tsuyoshi-otake/paperdiy-pda-terminal/README.md

# PaperDIY PDA Terminal

M5Stack PaperDIY（4.7 型 e-paper、ESP32-S3）を画面に、CACOE キーボードを BLE でつないだ、PDA 風クラムシェルの SSH 端末です。Un Kyu Lee さんの [phone-enclosure](https://github.com/unkyulee/phone-enclosure)（Boox Palma 2 + CACOE キーボード）を元にしています。

**関連プロジェクト**：画面を M5Stack Tab5（5 型タッチ液晶）に替えた筐体は、[Tab5 PDA Terminal](https://github.com/tsuyoshi-otake/tab5-pda-terminal) にあります（トレイ・ヒンジ・留めツメは同じ形）。

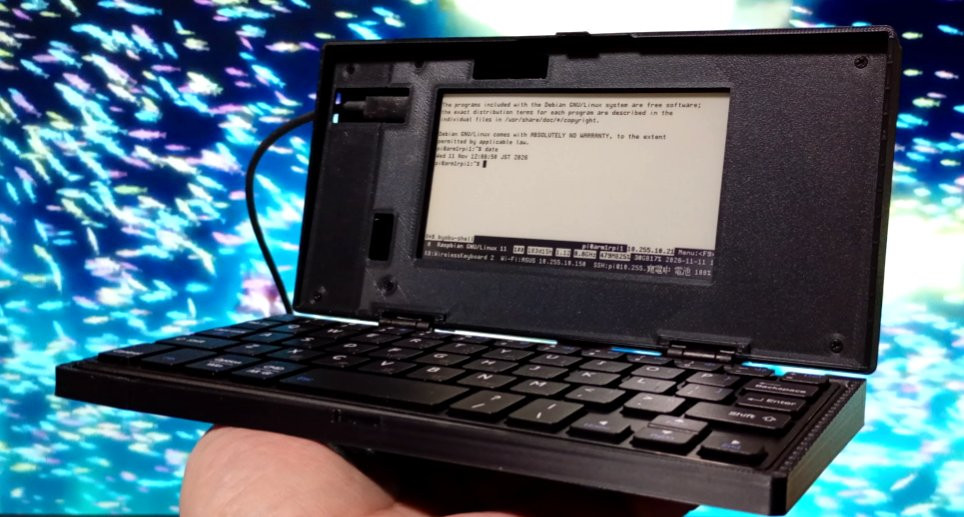
[picture p1: docs/images/photo_2026-11-11.jpg]
組み上がった実機。Raspberry Pi に SSH で入ったところ（2026-11-11）


実機です（2026-11-11。留めツメを直す前の版で、蓋はまだカチッと留まりません）。Wi-Fi 経由で Raspberry Pi に SSH で入り、CACOE キーボードで打っています。下は、いまの版の完成予想図です。

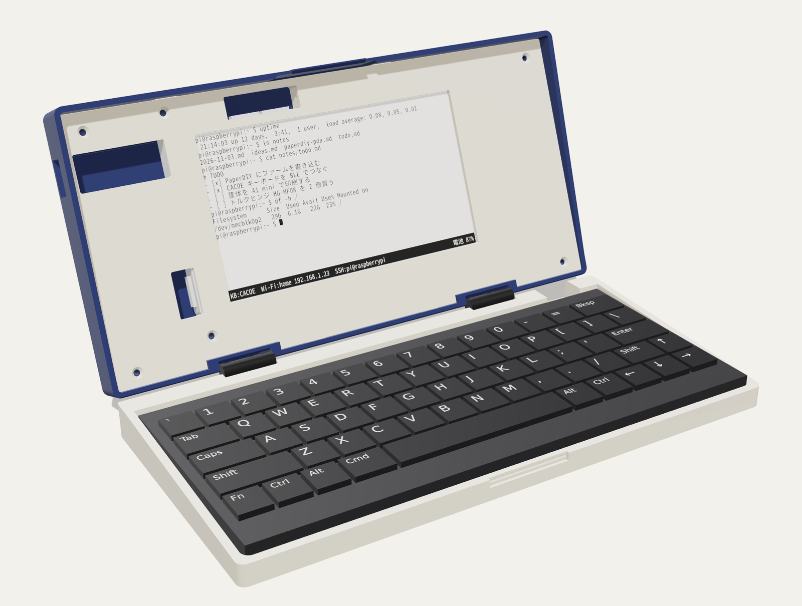
[picture p2: docs/images/render_open.png]
完成予想（開いたところ）


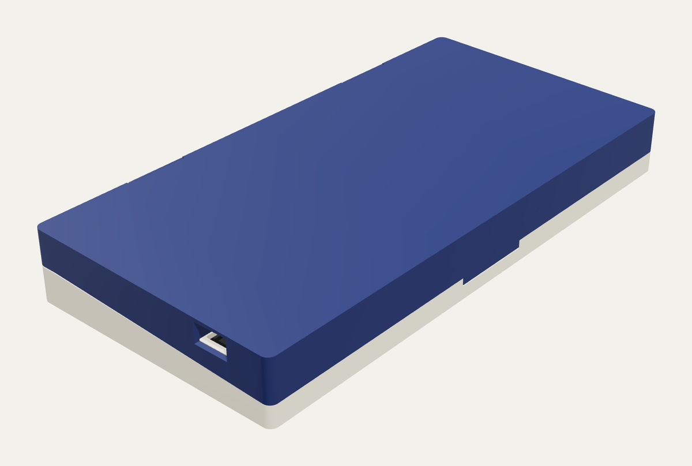
[picture p3: docs/images/render_closed.png]
完成予想（閉じたところ）
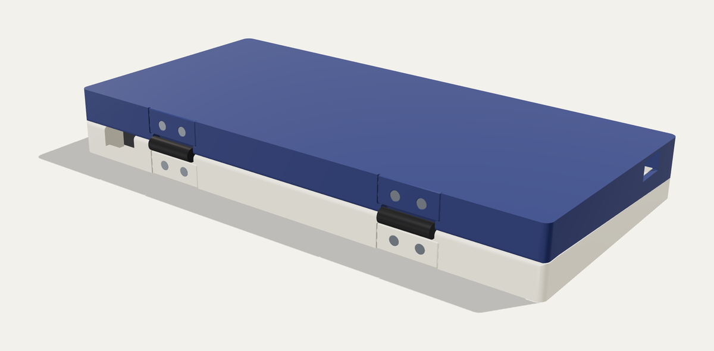
[picture p4: docs/images/render_back.png]
完成予想（背面のヒンジ）


筐体は `cad/out` の STL を組み立てた状態で描いています（キーボードは CACOE の代わりの簡易モデル、画面の表示はイメージ）。色は黒だけ・カーキだけ・ミックス（蓋がカーキ、トレイと化粧パネルが黒）で描いたものもあります：

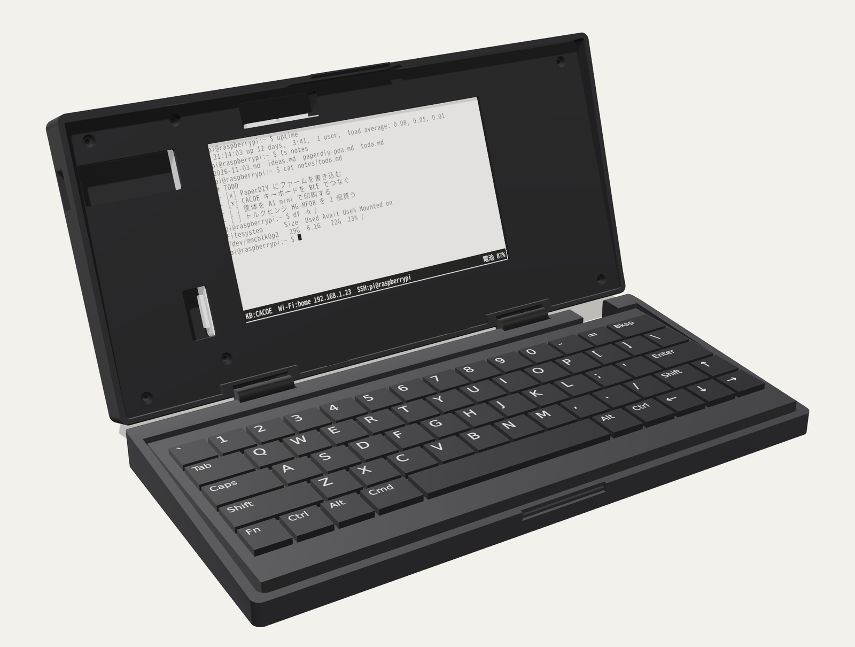
[picture p5: docs/images/render_open_black.png]
黒だけ
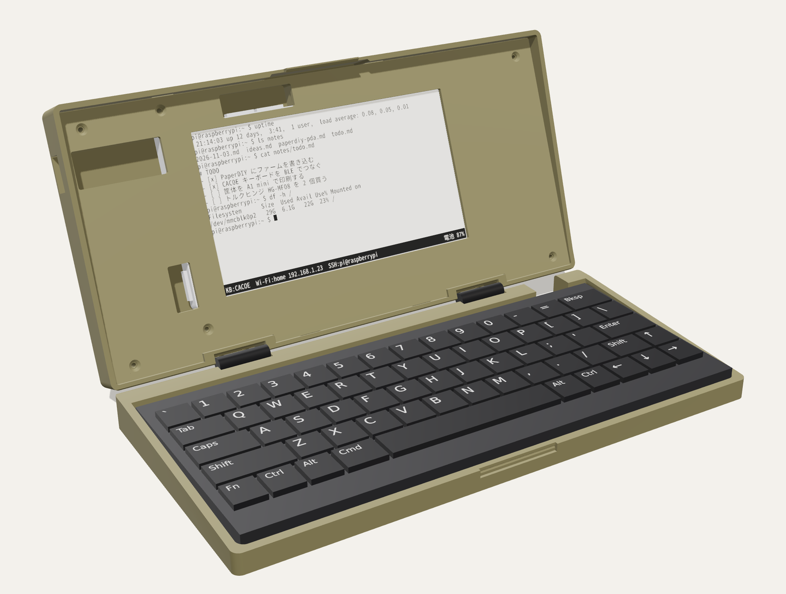
[picture p6: docs/images/render_open_khaki.png]
カーキだけ
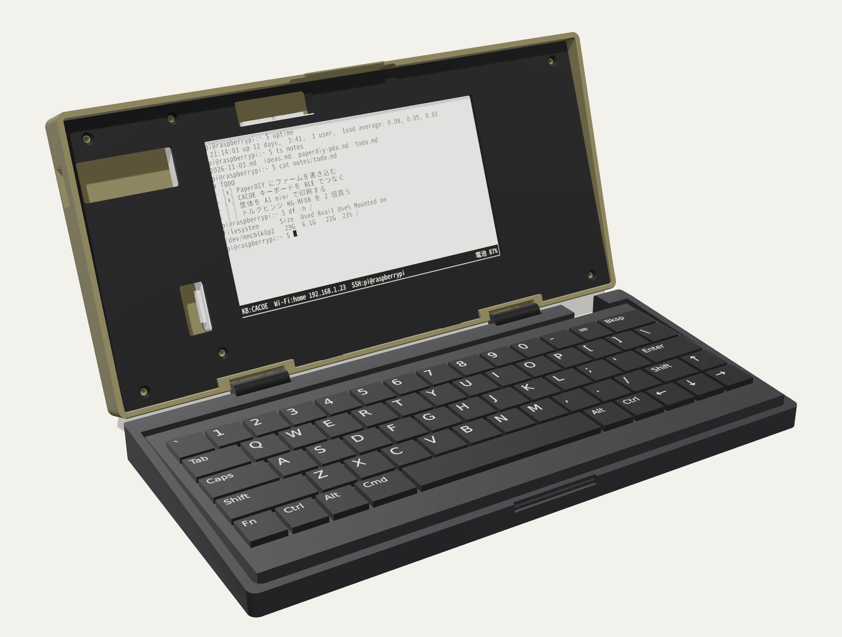
[picture p7: docs/images/render_open_mix.png]
ミックス（蓋がカーキ、トレイと化粧パネルが黒）


> **実機が 1 台、組み上がって動いています**（上の写真）。キーボードの BLE 接続と自動ペアリング、Wi-Fi、Raspberry Pi への SSH ログインまで、筐体に入れた状態で使えています。ただし、まだ試作段階です。筐体は、刷って組むたびに出た問題を直してきました。前の設計（PaperDIY の基板をそのまま載せる版）では、キーボードのがたつきや開いたときのすき間。今の設計（Complete Kit のケースごと入れる中空の蓋と化粧パネル）では、壁の柔らかさ（1.2 mm → 2.0 mm）、カバーと継ぎ板のきつさ、ヒンジの戻りで蓋の手前が浮くこと、留めツメが勝手に外れること、キーボードの位置決めリブが当たること、TPU の足が作りにくいこと。写真の 1 台は留めツメを直す前のもので（ツメが掛からず、蓋の手前が少し浮く）、**いまのリポジトリの版そのものは、まだ刷って確かめていません**（[まだ確かめていないこと](#まだ確かめていないこと)）。

## 特徴

**端末（ファーム）**

- BLE キーボードで入力。ペアリング待ちのキーボードを自分で見つけてつなぎ、次からはキーを押せば再接続
- Wi-Fi の検索・保存・自動再接続、SSH の接続先 8 件（パスワード、キーボードインタラクティブ、microSD の秘密鍵）
- xterm 互換の端末（UTF-8、日本語の全角表示、スクロール領域、代替画面）。vim、less、top、nano、tmux を想定。日本語の入力は未対応（[Issue #1](https://github.com/tsuyoshi-otake/paperdiy-pda-terminal/issues/1)）
- 接続エラーには、つなぎに行った IP とポート、この端末の IP を表示
- ESP-IDF v5.5.6 の再現可能ビルド。ビルド済みのファームはブラウザからでも書き込める

**筐体**

- Bambu Lab A1 mini と PLA で刷る前提の作り：蓋とトレイは壁・天板・床とも 2.0 mm の殻にして（1.2 mm では刷ってみて柔らかすぎた）、ねじのボスとリブで補強（パネルのねじのボスにもリブ）。面取りなし、サポート不要。0.4 mm ノズル向き（0.2 mm ノズルの設定もある）
- トレイは、キーボードのまわりのすき間と奥の帯を、縁と面一の天板（デッキ）でふさいである。ヒンジのボスは隠れる。キーボードの入る所は元のトレイと同じ 196 × 87 mm。壁から内側に出る位置決めのリブはない（キーボードに干渉する・きつい、と分かったのでやめた）
- PaperDIY は Complete Kit のケースに入れたまま、中空の薄い蓋に入れ、画面の窓のある化粧パネルで押さえる。パネルは押し込むとパチンと留まり（ねじなしでもある程度保持）、ねじ 6 本で固定。ボタンと USB-C プラグはパネルの切り欠きから。KEY の切り欠きの裏にはごみよけのガード
- 閉じた高さは手前 23.8 mm・奥 26.4 mm。蓋と一体の短い留めツメ（幅 30 mm、合わせ目から 2.6 mm）でパチンと閉じる（磁石なし）。ツメに切れ目はなく、まわりの壁を内側から薄くした帯が板としてたわむので折れにくい。蓋の下面はヒンジに向かって 0.4 mm まで斜めに逃がしてある（ヒンジのそばで縁が当たると、ねじを締めたときに蓋の手前が開くため）。トルクヒンジは手を離すと少し戻るので、蓋はカチッと言うまで押し込んで閉じる（ツメがその戻りを押さえる）
- 部品はすべて PLA。トレイの底は平らで、足はない（TPU の足とそのくぼみは、作るときの失敗を招くだけだったのでやめた）
- ヒンジは市販のトルクヒンジ（スガツネ HG-MF08 × 2）を背面に埋め込み、背面と面一のカバーで隠す。カバーは押し込むだけで側面の小さなリブで留まり、ヒンジのねじで共締めするので接着剤は要らない。好きな角度で止まり、開いたときの継ぎ目は 1〜1.5 mm
- USB-C は左端の穴から直接挿す。パネルマウントのメス端子用の蓋も用意（ねじ間隔 16〜30 mm）
- Bambu Lab A1 mini 用の分割版（3 枚で PLA 約 150 g。0.4 mm ノズルで約 4 時間、0.2 mm ノズルで約 22 時間 40 分。A1 mini（0.4 mm ノズル）向けには、印刷設定を入れた Bambu Studio のプロジェクトもある（`cad/3mf/bambu_a1mini/`。開いてスライスするだけ）。継ぎ目はまっすぐ突き合わせ、裏から貼る継ぎ板でつなぐ）と、220 mm 角以上のプリンター用の一体版（0.4 mm ノズルで約 3 時間 46 分・150 g、貼り合わせ不要）
- ねじは M2×8 皿タッピング 14 本だけ。本番の前に試し刷り（0.4 mm ノズルで約 24 分）で、はめあいと留めツメの留まり具合を確かめられる

## 作り方

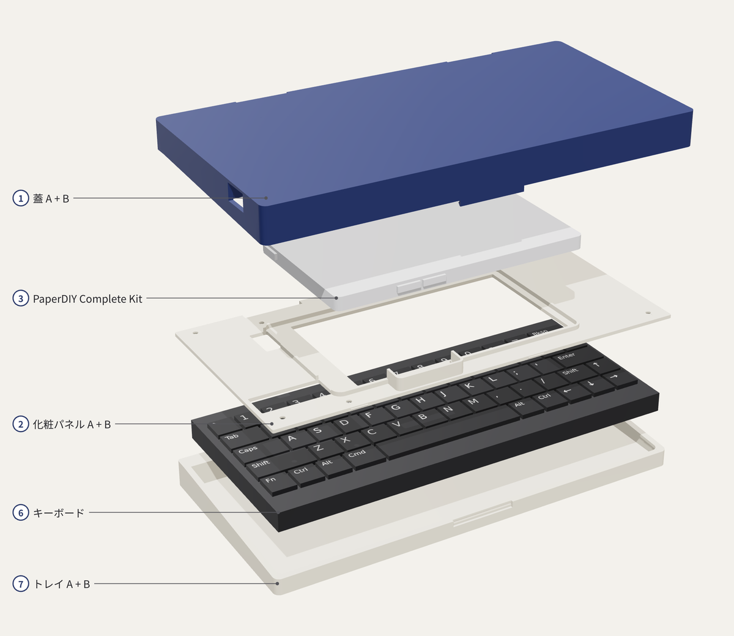
[picture p8: docs/images/render_exploded.png]
分解図


印刷用のファイル（Bambu Studio のプロジェクト、3MF、STL）とビルド済みのファームは、[Releases](https://github.com/tsuyoshi-otake/paperdiy-pda-terminal/releases) からまとめてダウンロードできます（リポジトリの `cad/3mf/`、`cad/out/`、`firmware/prebuilt/` と同じものです）。

1. **測る**：キーボードの厚さ（キートップまで）・幅・奥行き・重さ。厚さで蓋の高さが決まります。トレイは元の作品と同じ 196 × 87 mm の空間なので、CACOE ならそのまま入ります（[組み立てガイドの 3-1](cad/ASSEMBLY_ja.md)）。83 g 以上なら蓋をどこまで開いても後ろに倒れません
2. **試し刷り**：`cad/3mf/plate0_test_coupons.3mf`（0.4 mm ノズルで約 24 分）で、ヒンジ・カバーのはめあいと、留めツメの留まり具合を確かめる（A1 mini の 0.4 mm ノズルなら、設定入りの `cad/3mf/bambu_a1mini/bambu_plate0_test_coupons.3mf`）
3. **本番**：A1 mini なら `cad/3mf/plate1_lid.3mf`〜`plate3_panel.3mf`（設定入りは `bambu_a1mini/bambu_plate1_lid.3mf`〜。分割した部品を突き合わせて継ぎ板で貼り合わせる）、大きいプリンターなら `cad/3mf/large/` の 3 枚
4. **ファームを書く**：[`firmware/README.md`](firmware/README.md) の手順で `firmware/prebuilt/` のファームを書き込み、キーボードと Wi-Fi をつないでおく
5. **組み立てる**：ヒンジとカバー、PaperDIY と化粧パネル、キーボードの順に（[組み立てガイド](cad/ASSEMBLY_ja.md)）

## ドキュメント

| 文書 | 内容 |
| --- | --- |
| [cad/ASSEMBLY_ja.md](cad/ASSEMBLY_ja.md) | **組み立てガイド**：部品表、印刷設定、試し刷り、分割版の貼り合わせ、組み立て手順、使うときの注意、確認リスト |
| [cad/README_ja.md](cad/README_ja.md) | 筐体の概要：印刷するファイル、蓋・トレイ・化粧パネル、留めツメ、ヒンジ、倒れやすさ |
| [cad/README.md](cad/README.md) | 筐体の詳細（英語）：寸法の根拠、検査の内容、元の作品からの変更点、全パラメータ |
| [cad/README_bare.md](cad/README_bare.md) | 前の設計（PaperDIY の基板をそのまま載せる版、英語） |
| [cad/bom.csv](cad/bom.csv) | 部品表（CSV） |
| [firmware/README.md](firmware/README.md) | **ファーム**：書き込み、使い方、困ったとき、公開鍵認証、対応する SSH サーバー |
| [firmware/prebuilt/BUILDINFO.md](firmware/prebuilt/BUILDINFO.md) | ビルド済みファームの中身とビルド条件 |
| [docs/README.md](docs/README.md) | 画像と、それを描くスクリプト |
| [CHANGELOG.md](CHANGELOG.md) | 変更の履歴 |
| [Releases](https://github.com/tsuyoshi-otake/paperdiy-pda-terminal/releases) | 印刷用のファイルとビルド済みファームのダウンロード（zip） |
| [Issues](https://github.com/tsuyoshi-otake/paperdiy-pda-terminal/issues) | 課題と検討中のこと |

## リポジトリの構成

| フォルダ | 内容 |
| --- | --- |
| [`firmware/`](firmware/) | PaperDIY 用ファーム（ESP-IDF v5.5.6）。`prebuilt/` にビルド済みのバイナリ |
| [`cad/`](cad/) | 筐体のデータ。`src/`（作るスクリプト）、`out/`（STL）、`3mf/`（印刷用プレート）、`tools/`（検査・レポート） |
| [`docs/`](docs/) | README の画像と、それを描くスクリプト |
| `Makefile`、[`.github/workflows/`](.github/workflows/) | 全部を作り直すコマンドと、push のたびに作り直して確かめる CI（`build.yml`）、リリースを出すワークフロー（`release.yml`、手動で実行） |

## まだ確かめていないこと

1. いまの版の筐体の印刷と仮組み（はめあい、ヒンジ側を逃がした蓋で、留めツメがカチッと掛かってヒンジの戻りに負けずに留まるか・開けにくくないか、リブをなくしたトレイにキーボードが入るか、ヒンジの筒の太さと軸の高さ。公表値がないので、メーカーの 3D データから太さ 5.5 mm・軸は裏から 3.2 mm と読み取った。合わせ目の縁を丸めたので、軸が 0.3 mm 低くても蓋とトレイが当たるのは 170° から）
2. CACOE の厚さ・幅・奥行き・重さ（いまは厚さ 11.5 mm を想定。測った値を `cad/src/params.py` の `KB_THICK` に入れて作り直す。幅と奥行きは、元のトレイ（196 × 87 mm）で 2 mm ほどガタつくという報告から 194 × 85 mm と推定しているが、トレイは元と同じ 196 × 87 mm のままなので、入るかどうかには関係しない）
3. トレイの開口から CACOE の充電ケーブルを挿せるか、スイッチに届くか（デッキは開口の上を開けてある。充電ケーブルを挿したままだと蓋は 95° まで）
4. PaperDIY 内蔵の 140 mAh でどれくらい使えるか（足りなければモバイルバッテリー）
5. 設定入りの Bambu Studio プロジェクト（`cad/3mf/bambu_a1mini/`）が、実際の Bambu Studio で設定どおりに開くか（公開されているソースの読み込み処理に合わせて作ったもので、作る側では Bambu Studio を動かせていない）
6. 足のないトレイの底が机の上で滑りやすくないか

## 作り直す・同じものができるか確かめる

```bash
make setup      # Python のパッケージ（バージョン固定）
make verify     # 元データを固定のコミットで取得 → STL と 3MF を作り直し → コミット済みのものと比べる
make variants   # 文書にある別の作り方（前の設計 PD_MOUNT=bare、詰まった蓋 KIT_LID=solid）が今も作れるか確かめる
make report     # 印刷時間・重さ・スライサーの警告・壁の厚さ・倒れやすさ（PrusaSlicer が要る）
make sim        # 留めツメを閉じるところのシミュレーション（cad/out/snap_sim.md）
make test       # ファームの端末エミュレータのテスト（g++ と pyte）
make firmware   # ESP-IDF v5.5.6 でビルドして prebuilt/ と 1 バイトずつ比べる（Docker なら make firmware-docker）
make render     # README の画像を描き直す（Node.js）
make dist       # リリースに付けるファイル（zip とファーム）を dist/ に作る
```

- 元データ（phone-enclosure）はコミットと SHA-256 で固定しています。Python のパッケージ、ESP-IDF、ファームの依存ライブラリ、画像を描く npm パッケージもバージョンを固定しています
- 筐体の出力（STL・3MF）は、同じ PC なら 1 バイトも違わないものができます。別の PC では計算の最後の桁の丸めで一部のファイルのバイトが変わることがありますが、形（体積・寸法）は一致します。全ファイルの SHA-256 と体積・寸法を `cad/out/MANIFEST.json` に記録してあり、`make verify` は 0.01 mm / 0.01 % の差まで許して比べます
- ファームは日時やパスを含めない再現可能ビルドで、push のたびに GitHub Actions の `espressif/idf:v5.5.6` コンテナでビルドして `prebuilt/` と 1 バイトずつ比べています

## リリースの出し方

1. `docs/releases/（タグ名）.md` にリリースノートを書く（1 行目が `# 題名`、3 行目から本文。例：[`docs/releases/v2026.11.11.md`](docs/releases/v2026.11.11.md)）。タグ名は日付（`v2026.11.11` の形）
2. push して、CI（build）が通るのを待つ
3. GitHub の **Actions → release → Run workflow** で、タグ名を入れて実行する。そのコミットにタグが付き、`make dist` で作った zip（Bambu Studio のプロジェクト、3MF、STL、ファーム）と `SHA256SUMS` の付いたリリースができる。「Dry run」にチェックを入れると、公開はせずに zip だけ作って確かめられる（結果は実行ページの Artifacts）

zip の中身は、コミット済みの `cad/3mf/`・`cad/out/`・`firmware/prebuilt/` そのままです。日時を固定してあるので、同じ入力なら同じバイトになります。手元で作るなら `make dist TAG=（タグ名）` で `dist/` にできます。

## ライセンス

- **ソースコードと文書は [MIT ライセンス](LICENSE)** です（`firmware/`、`cad/src/`、`cad/tools/`、`docs/` のスクリプト、`Makefile`、CI、Markdown の文書）。
- **筐体の 3D データと、それを描いた画像は [CC BY-NC 4.0（非営利のみ）](cad/LICENSE.md)** です（`cad/out/`、`cad/3mf/`、`cad/renders/`、`docs/images/`）。Un Kyu Lee さんの [phone-enclosure](https://github.com/unkyulee/phone-enclosure)（[CC BY-NC 4.0](https://creativecommons.org/licenses/by-nc/4.0/)）の改変物なので、MIT にはできません。変更点は [`cad/README.md`](cad/README.md#changes-vs-the-original-for-the-licence-indicate-changes) にあります。
- **ビルド済みのファーム**（`firmware/prebuilt/`）には、ビルド時に取得するライブラリ（M5GFX・M5Unified：MIT、LovyanGFX：FreeBSD、efont：BSD 系、libssh2：BSD-3-Clause、ESP-IDF：Apache-2.0 ほか）が入っています。著作権表示とライセンス本文は [`firmware/prebuilt/THIRD_PARTY_NOTICES.md`](firmware/prebuilt/THIRD_PARTY_NOTICES.md) にあります。
- M5Stack、PaperDIY、スガツネ（HG-MF08）、CACOE はそれぞれの会社の名称です。このプロジェクトはどの会社とも関係ありません。
