tsuyoshi-otake/paperdiy-pda-terminal/cad/README.md

# PaperDIY PDA clamshell — printable CAD (derivative of unkyulee/phone-enclosure)

A Boox-Palma-free version of Un Kyu Lee's "PDA Terminal". The screen is an **M5Stack PaperDIY Complete Kit** (4.7"
e-paper, ESP32-S3) **left in its own printed case**: it lies in a hollow lid (2.0 mm walls and ceiling) and a
printed **bezel panel** with the screen window holds it from the front, screwed to six bosses in the lid. The buttons are
pressed directly through finger slots in the panel (the KEY slot with a guard ring behind it); a straight USB-C cable goes in through an opening in the left end,
and lid A (the small left piece) also comes in versions for a panel-mount female USB-C, so the end can be swapped later
by reprinting that piece only. It runs on the kit's own 140 mAh LiPo (a power bank on the USB-C when that is not
enough). A snap lip moulded into the lid's front wall (no slits: a thinned zone of the wall flexes) clicks into a recess in the tray, so the closed lid stays shut without
magnets or extra parts. The original knob-and-pin hinge is replaced by **two free-stop torque hinges (Sugatsune HG-MF08)
recessed into the back face, under printed cover plates that sit flush in it and are held by the hinge screws
themselves**, so only the barrels and the screw heads show; the whole back face is at the hinge plane, so the seam between
screen and keyboard stays 1–1.5 mm when open. Everything prints in PLA on a **Bambu Lab A1 mini (180 mm bed)**:
lid and tray are 2.0 mm shells stiffened by screw bosses and ribs (1.2 mm printed too flexible), no chamfers, corner radii halved. Lid, tray and panel
are split for the A1 mini with a straight seam, butt-glued and bridged by splice plates glued on the hidden side; with a bed of 220 mm
or more they are one piece each (`3mf/large/`, `out/whole/`). Nothing needs supports. Fasteners: 14 × M2×8
countersunk tapping screws (8 hinges, 6 panel). A **test-coupon plate** checks the hinge and cover fits and the snap's hold in
~24 min. Bill of materials, print settings and assembly order (Japanese): [ASSEMBLY_ja.md](ASSEMBLY_ja.md); parts list
as CSV: [bom.csv](bom.csv).

`KIT_LID = "solid"` (or `KIT_LID=solid` in the environment) builds the previous kit lid (a solid deck with the kit in a pocket, one M2×4 screw from the top, no
panel; not kept up: its lower front wall strains the snap's zone past the guide, and the build log says so). `PD_MOUNT = "bare"` in `src/params.py` (or `PD_MOUNT=bare` in the environment) still builds the earlier design:
the bare Assembly Kit on a printed bezel panel with a strap, snap-in push-rods, a 2000 mAh cell and a panel-mount USB-C.
It is described in [README_bare.md](README_bare.md).

Contents: [Run](#run) · [Kit design](#kit-design-pd_mount--kit-the-default) · [Hinge](#hinge) ·
[Printing](#printing) · [Hardware](#hardware) · [Measure on the real parts](#measure-on-the-real-parts) ·
[Verification](#verification-performed) · [Changes vs. the original](#changes-vs-the-original-for-the-licence-indicate-changes) ·
[Sources](#sources-of-measured-dimensions) · [Parameters](#parameters-srcparamspy-all-of-them)

## Run

From the repository root (or the same commands by hand from this folder):
```
make setup     # pip install -r cad/requirements.txt (pinned versions) + the host-test packages
make verify    # fetch the pinned original, build every STL + 3MF, compare with out/MANIFEST.json
make report    # optional, needs prusa-slicer: print time / filament / stability warnings -> out/print_report.md
make sim       # the lid closing onto its snap, simulated on the built parts -> out/snap_sim.md
make variants  # the other designs (PD_MOUNT=bare, KIT_LID=solid) still build? (in scratch copies; CI runs it)
```
By hand:
```
pip install -r requirements.txt
tools/fetch_original.sh                  # clones unkyulee/phone-enclosure at the pinned commit to ~/phone-enclosure, checks hashes
python3 src/build.py                     # ~10 s; writes out/, out/split/, out/coupons/, renders/
python3 src/export_3mf.py                # 3mf/ print plates
python3 tools/manifest.py --check        # same outputs as committed?
python3 tools/print_report.py            # optional (prusa-slicer)
python3 tools/snap_sim.py                # the snap, simulated (--figure ../docs/images/snap_sim.png redraws the figure)
```
Set `PHONE_ENCLOSURE_STL=/path/to/phone-enclosure/STL` if the original repo is cloned elsewhere.
`src/params.py` holds every parameter; `src/build.py` does the mesh booleans (manifold3d) on the original STLs,
checks each export by re-loading the written STL (watertight, one body), runs assembly interference and motion checks,
writes the test coupons and the lid-A variants, and renders PNGs with `src/render.py` (software z-buffer, no GPU). The full
log is written to `out/build_log.txt`.

### Reproducibility
* **Input pinned:** `ORIG_COMMIT` and `ORIG_SHA256` in `src/params.py`; `load()` refuses STLs with other hashes
  (override: `PHONE_ENCLOSURE_ANY_VERSION=1`). `tools/fetch_original.sh` checks out that commit.
* **Tools pinned:** `requirements.txt` (Python 3.13). The README images use `docs/render/package-lock.json`.
* **Deterministic:** on one machine, two builds give byte-identical STL / 3MF files (also with one CPU); the 3MF zips carry
  fixed timestamps. Another machine can round the last digit differently: on the GitHub Actions runner some files
  are byte-identical and the rest match in geometry only.
* **Recorded:** `out/MANIFEST.json` holds the SHA-256, volume, bounding box and triangle count of every output.
  `tools/manifest.py --check` accepts byte differences only when the geometry matches to 0.01 mm / 0.01 %.
* **CI:** `.github/workflows/build.yml` runs `make verify`, the snap simulation, the slicer report, the firmware build (compared byte for byte
  with `firmware/prebuilt/`) and the host tests.

## Kit design (`PD_MOUNT = "kit"`, the default)

### Manufacturing basis
PLA on a Bambu Lab A1 mini (0.4 mm nozzle, 0.2 mm layers), split parts on its 180 mm bed or one-piece parts on a bigger
one. Lid and tray are shells: **2.0 mm walls, ceiling and floor** (`WALL`: 5 lines of a 0.4 mm nozzle; the 1.2 mm version printed too flexible), stiffened by screw
bosses and ribs (`RIB_T` = 1.2). Clearances are for a tuned FDM printer: 0.2 mm around the kit and
the panel (`KIT_FIT`, `PANEL_CLR`), 0.25 mm around the covers (`COVER_POCKET_CLR`; 0.15 printed too tight), 0.3 mm around the splice plates, 0.25 mm in the hinge mortises
(`HINGE_CLR`). No supports. No chamfers anywhere; the plan corners of lid and tray are r 3 (`CORNER_R`, the original's
r 6 halved), and the other small radii were halved too.

### Outputs
| File | Notes |
|---|---|
| `out/display_lid_usbc.stl` | lid, unsplit (hollow shell; 202.0 × 99.5 × 22.1) |
| `out/display_panel_kit.stl` | bezel panel, unsplit (199.2 × 97.6; 1.6 thick + 2.0 rim, KEY guard up to the kit's back) |
| `out/keyboard_tray.stl` | tray, unsplit (a new thin shell with the original's outline and parting; 202.0 × 99.5 × 12.9) |
| `out/paperdiy_kit_envelope.stl` | the kit as placed (case 120.0 × 67.0 × 6.3, r 3, KEY and power caps): checks and renders |
| `out/hinge_cover_lid_x2.stl`, `out/hinge_cover_tray_x2.stl` | print 2 of each |
| `out/split/lid_A_left.stl`, `lid_B_main.stl`, `panel_A_left.stl`, `panel_B_main.stl`, `tray_A_left.stl`, `tray_B_main.stl` | A1 mini pieces (≤ 175 mm), cut straight, with the splice-plate pockets |
| `out/split/splice/{lid,tray,panel}_splice_N.stl` | splice plates for the split pieces (2 lid and 1 tray, 1.0 mm; 3 panel, 0.8 mm) |
| `out/split/usb_variants/lid_A_left_usb*.stl` | lid A for a panel-mount female USB-C: M3 ears 16 / 18 / 20 / 22 / 25 / 28 / 30 mm apart, or none (glue) |
| `out/whole/lid.stl`, `tray.stl`, `panel.stl`, `out/whole/usb_variants/lid_usb*.stl` | one-piece parts for a bed of 220 mm or more: no split, no keys, no pockets (each asserted to be the checked part minus material; the panel-mount lids are also checked against the connector) |
| `out/coupons/*.stl` | hinge seat (lid, tray), snap lip with its flex zone (lid) + recess and notches (tray) |
| `3mf/plate0_test_coupons.3mf` | coupons + one cover of each kind, ~24 min, 10 g |
| `3mf/plate1_lid.3mf` | lid A + B + 2 lid covers + 2 lid splice plates, ~1 h 45 min, 65 g |
| `3mf/plate2_tray.3mf` | tray A + B + 2 tray covers + 1 tray splice plate, ~1 h 32 min, 62 g |
| `3mf/plate3_panel.3mf` | panel A + B + 3 panel splice plates, ~38 min, 24 g |
| `3mf/bambu_a1mini/bambu_plate0…3*.3mf` | the same four plates as **Bambu Studio projects** for the A1 mini with a 0.4 mm nozzle: printer, process, filament and plate type are selected on opening (see "Bambu Studio projects") |
| `3mf/bambu_a1mini/paperdiy_process_a1mini_04.json` | the same process changes as a preset to import (File → Import → Import Configs), the fallback |
| `3mf/usb_variants/lid_A_left_usb*.3mf` | the lid-A variants, one per file |
| `3mf/large/plate1_lid.3mf`, `plate2_tray.3mf`, `plate3_panel.3mf` | one-piece lid / tray / panel (+ covers) on a 220 x 220 mm plate: ~1 h 40 min 65 g, ~1 h 28 min 61 g, ~35 min 24 g (150 g, 3 h 42 min, nothing to glue) |
| `3mf/large/usb_variants/lid_usb*.3mf` | the panel-mount lids in one piece |

Plates 1–3: about 151 g and 3 h 54 min with the 2.0 mm walls (3 h 58 min with the keyboard ribs, now gone; 118 g and 3 h 07 min with 1.2 mm walls; the version with the
original tray took 139 g and 3 h 29 min).

### The kit
Measured from M5Stack's model of the Complete Kit (`m5stack/M5_Hardware`, `Products/K159-B_PaperDIY_Complete_Kit/Structures/PaperDlY_Complete_Kit.stl`,
sha256 `9258e3e2…3e58`): case 120.0 × 67.0 × 6.3 mm with r 3 mm corners; window 105.0 × 59.7 at the front, 4.0 mm off
centre away from the USB end; KEY1/KEY2 caps on one long edge (9.6–20.4 and 21.6–32.4 mm from the centre toward the USB
end, 1.2 proud, 2.1–4.95 mm behind the front face); power cap on the USB end (+17.9…+28.8 mm across, 1.27 proud);
USB-C at −24.0 across, 2.44–5.6 mm behind the front; a 4.2 mm hole in the back plate over the M2 standoff, 20.0 mm from
the centre toward the USB end (not used by the shell lid). M5Stack: 43.1 g.

### Layout and lid shape
* The kit lies front face down (window toward the keyboard), window centred on the lid (`KIT_CX = −4.0`), USB end at −x,
  KEY edge toward the front (−y), as the bare board was.
* **Panel face** at `PANEL_Z0 = KB_TOP_Z + KB_CLR` = 14.0, with `KB_TOP_Z = TRAY_FLOOR + KB_THICK` = 2.0 + 11.5: the
  CACOE stands above the tray rim (the original lid's panel face was at z = 15 over a 3 mm floor), and nobody has measured
  it yet. Measure the keyboard over the keycaps and set `KB_THICK`: every millimetre comes off the lid. The panel is 1.6
  thick, so the kit's front face is at 14.8 and its back (+ 0.2 gap) at 21.3.
* **Underside**: the original parting plane z = 10.4417 + 0.05376 y (fitted to the original lid, residual < 0.001 mm),
  flat at `Z_PART` behind y = 44.7 (the hinge strip).
* **Top**: a plane through the lowest point that the hinge allows at the back face (leaf 12.75 mm above the axis + the
  cover's top rim; z 26.4 at y = 53) and the most demanding of: the kit + ceiling, and the USB-C plug path + 0.8
  (`USB_CEIL`): z = 24.994 + 0.02653 y (set by the kit's front edge + the 2.0 ceiling). The lid is 15.8 mm thick at
  the front face and 13.4 at the back; the closed case is 23.8 mm tall at the front and 26.4 at the back (was 30 / 30). The hinge (25 mm wide, face mounted) sets a floor
  of ~26 mm at the back whatever the keyboard.
* **Lid shell** (`KIT_LID = "shell"`): the plan outline (r 3 corners) as a prism between the two planes, no chamfers,
  hollowed to `SHELL_WALL` = `SHELL_CEIL` = 2.0. Inside: a pad and two screw bosses per hinge (see "Hinge"), six screw
  bosses (Ø6) for the panel with Ø1.8 pilots, each braced by 1.2 mm ribs in up to four directions (`PANEL_BOSS_RIBS`:
  toward a wall within 5.5 mm a full-height rib into it, elsewhere a 3 mm gusset sloping from the boss's foot to the
  ceiling; none into the kit's rim, the splice-plate pockets or the plug path; all 0.5 mm above the panel's back),
  three ribs from the ceiling to 0.1 mm above the kit's back (x −50 / 0 / 40,
  clear of the ESP32 window), two 1.2 mm guide ribs either side of the plug path (from the end wall, beside the opening, to
  the kit; cut at the split like everything else), and a relief that leaves 0.8 mm of ceiling over the plug.
* **Tray shell**: a new part instead of the original `Keyboard.stl`: the same plan outline (r 3) cut by the original
  parting plane and `Z_PART`, hollowed to 2.0 walls over a 2.0 floor (`TRAY_FLOOR`; the original had 3 mm walls and floor).
  The keyboard's room is the original tray's, 196 × 87 mm (`KB_FACE_X`, `KB_FACE_Y`), and nothing stands out of its
  walls. The nine locating ribs on the front and back got in the keyboard's way; the two on each end wall, brought back
  0.15 mm off the ends of the estimated 194 mm keyboard, were too tight in the print (`TRAY_KB_RIBS`, now `None`: set
  it again once the keyboard's length is measured). The keyboard has the original's play, ~2 mm each way. Also: hinge pads and bosses, a pad behind the snap-tab recess (flush with the room's front face), and the
  original's charge-port opening in the back wall (x 72.9–89.1, from 3.0 above the floor: `TRAY_PORT`).
* **Tray deck** (`TRAY_DECK`): a 1.2 mm face flush with the rim closes the gaps around the keyboard and the strip behind
  it, so the hinge bosses and pads no longer show. Its opening is the original tray's room (196 × 87 mm, front
  corners r 3 as the original's inner corners), the one size the keyboard is known to go into.
  Along the front and end walls it is 1.0 mm wide on a 45° fillet; behind the keyboard it tops a strip that is solid from
  the floor up (7.5 mm deep; it takes in the hinge bosses and pads, the slicer fills it with infill). Over the charge-port opening it is open (16.2 mm), so the plug, and a switch there, stay reachable from above.
  No supports, no slicer warnings (the first try, a deck bridged over ribs, gave long-bridge warnings). The tray's splice
  plate now stays inside the keyboard's room (y ±42.4, 84.8 mm), so it goes in through the opening.
* **No feet**: the tray's bottom is flat and stands on the table, as the original's does. An earlier version pressed
  four TPU pads into 0.8 mm pockets in the bottom; the pockets in the first layer and the second material only invited
  mistakes in the making, so they are gone and every part is PLA.
* **No dampers** under the lid's front edge: the torque hinges spring back a little when the lid is let go (see
  "Hinge"), so the closed lid is always pressed up against the snap and cannot rattle. The TPU bow springs an earlier
  version had in the tray's front rim only added 0.5 N to that push.
* **Bezel panel** (`PANEL_*`): 1.6 mm, inside the lid's walls (0.2 mm clear of them and the hinge pads). Screen window =
  the kit's window + 0.3 per side, square edges (no chamfer); a locating rim (2.0 high, 1.2 wide, 0.2 clear, below the
  caps at 2.1) around the kit on its back; six countersunk M2×8 holes (6.4 mm into the bosses); a gap in the rim for the
  USB-C plug. The kit is clamped between the panel and the ribs.
* **Panel snaps** (`PANEL_SNAP`): four 8 mm bumps, two on the front edge (x = −60, +26) and two on the back (x = −23,
  +26), between the wall ribs and clear of the latch, the KEY guard and the hinge pads: a ridge 0.45 mm out from the panel
  edge at mid-thickness. Going in they pass the lid's 2.0 mm walls by 0.25 mm (the walls flex), then sit in 0.30 mm
  grooves (0.05 clear) once the panel rests on the bosses, so the panel stays in without its screws; prise it out at the
  finger slots. The grooves follow `PANEL_SNAP["h"]`, the bumps `["bump"]`: if it is too tight, lower `bump` and reprint
  the panel only.
* **Buttons**: finger slots through the panel at the KEY caps (one slot for both, on the front edge) and the power cap (on
  the USB end), 8.0 mm out from the kit and 3.0 mm past the caps' ends (`PANEL_SLOT`; they were 6.5 / 1.5). No push-rods.
* **KEY guard** (`PANEL_GUARD`): a 1.2 mm ring on the panel's back around the KEY slot, 0.5 mm off it, from the panel up
  to the kit's back and closed by the kit's edge: whatever falls into the slot stays in that pocket instead of getting
  into the lid. The power slot has none: it opens into the space between the kit's end and the lid's end wall, which the
  USB-C slot already opens to the outside, and a ring there would take the place of a panel-mount female's body
  (lid-A variants).
* **USB-C, direct** (default): a 13 × 7.6 mm opening in the left end face; the guide ribs lead a straight plug (overmold
  ≤ 12 × 6.5) to the port, and the plug stays in with the lid closed. The panel is open over the plug path
  (`PANEL_USB_SLOT`: 13.2 mm wide, from a 2.2 mm frame at its left edge to the kit), like the button slots, so the plug
  can be watched and pushed home by hand; with a panel-mount female the extension's inner plug goes in and out the same
  way, without taking the panel off.
* **USB-C, panel-mount female** (lid-A variants): the same lid with the opening moved to y = 20 (`USB_PM_Y_KIT`, clear of
  the lid keys and the power slot), 13 × 7 mm (narrower for close ears) and two Ø3.4 holes. The connector's ears and
  body can be up to 7.2 mm tall between the panel and the ceiling. Only lid A changes (the build asserts that lid B is
  identical); a short extension's male end goes into the kit and its cable lies beside the kit, behind the panel.
* **Back**: `BACK_STYLE = "solid"` for lid and tray in the kit design: the whole back face is at the hinge plane
  (y = 53). With housings only behind the hinges, the lid's back edge between them was 7.65 mm in front of the hinge axis
  and swung 11–15 mm off the tray when opened, a slot between screen and keyboard; now the edge is 0.15 mm from the axis
  and the seam stays 1.0–1.5 mm (1.45 at 90°, 1.26 at 130°, 0.96 at 150°). The lid's lower and the tray's upper back edge
  along the parting are rounded r 1.5 (`HINGE_EDGE_R`), so a real axis a little lower than the catalogue model does not
  make them rub. The cost of the full-width back: with the keyboard's charge plug in, the lid opens to 95°.
* **Split** (A1 mini only): at x = −72 for lid and tray and −74.2 for the panel (2.2 mm clear of the power slot, panel B
  173.0 mm), a straight cut (`SPLIT_JOINT = "straight"`; `"dovetail"` adds three glued dovetail keys per seam, `DOVETAIL`,
  `PANEL_DOVETAIL`, as the earlier version had). `build.py` erodes each panel piece by 1 mm at mid-thickness and asserts
  it stays in one piece (no web under 2 mm).
* **Splice plates** (`SPLICE`): the butt joint alone makes a weak seam, so each seam is
  also bridged on its hidden side by plates half the wall thick (1.0 mm; 0.8 on the 1.6 mm panel) glued into pockets cut
  half the wall deep into both halves (0.3 mm clear: 0.15 printed too tight, the plates print flat with elephant foot), flush when in (until they are glued, the wall under a pocket is
  only half as thick, hence the thin-wall notes in the print report): one 20 × 84.8 mm plate on top of the tray floor (under the keyboard, inside the deck's opening), two (16 × 11 and 16 × 65.5 mm) in
  the lid's ceiling from the inside (parallel to the sloping top, clear of the USB-C relief), three (18.4 × 10.1 / 29.0 /
  15.4 mm) on the panel's back (between the slots, ≥ 1.5 mm from edges and slots). All pockets face up in print, so they
  need no bridging; the plates print flat. Plates vs their pieces: 0 mm³. The lid-A variants carry the same pockets.
* **Print**: lid pieces top face down (the 3MF export first tilts the top plane level, `LAY_TOP`, from `assembly.json`);
  tray floor down; panel pieces visible face down.

### Bambu Studio projects (`3mf/bambu_a1mini/`)
`export_3mf.py` writes the A1 mini plates a second time as Bambu Studio projects (`bambu_` + the plate's file name, so
the two kinds cannot be mixed up once downloaded); they open ready to slice: Bambu Lab
A1 mini 0.4 nozzle, Textured PEI Plate, Bambu PLA Basic, and "0.20mm Standard @BBL A1M" with
five options changed (`BAMBU["changed"]`: 3 wall loops, gyroid infill, Arachne walls, 0.1 mm elephant-foot compensation,
precise Z height).

The files follow how Bambu Studio reads a project (its source: `src/libslic3r/Format/bbs_3mf.cpp`,
`PresetBundle::load_config_file_config`, `PresetCollection::load_external_preset`, `PresetBundle::validate_presets`):
- `3D/3dmodel.model` carries the metadata `Application = BambuStudio-02.00.00.00`; that is what makes it a project
  instead of "geometry only". The version is the lowest 2.x, so no "newer file" notice comes up.
- `Metadata/project_settings.config` (JSON) names the three presets and lists, in `different_settings_to_system`, the
  process options that differ. Bambu Studio takes every option that is not in that list from its own system preset of
  that name, so the file holds only the names and the five changed values; start G-code, speeds and temperatures are
  Bambu's own, as installed.
- `Metadata/model_settings.config` puts every object on extruder 1 and on plate 1.

Not verified in Bambu Studio itself (it cannot be run where these files are built): on opening, check that the four
boxes show the presets above. The geometry-only plates in `3mf/` and the preset JSON are the fallback.

### Snap (`LATCH`)
**What it is for.** The hinges are free-stop friction hinges: let go, they turn back a little, so a lid pushed down
onto the tray comes up again (1° at the axis is 1.7 mm at the front edge), and it cannot be pushed past closed to make
up for that. The snap holds the lid down against it: 0.5…1.3 N at the front edge (both hinges' torque, ±25 %, less the
lid's weight; `out/print_report.md`, "Does the lid stay shut?").

A 30 mm wide, 1.0 mm thick lip in the middle of the lid's front wall runs 2.6 mm below the parting into a recess in the
tray's front face. Nothing is slit: a tab freed by two slits breaks from the slit ends, where the strain gathers on a
layer line (the lid prints ceiling down). Instead the front wall is thinned from inside to 1.1 mm over x −20…20
(`LATCH["flex"]`), up to 2 mm below the ceiling, with 45° chamfers back to the 2.0 wall (they face up in print), clear
of the panel's snap groove at x 22…30; that zone bends outward as a plate and nothing shows from outside. A 0.45 mm
bump on the lip's inside (its faces stand at 44° on the closing side and 49° on the catch side, measured from the
closing direction; see "The faces' angles" below) presses on the recess face, pushing the lip outward into free air,
and drops into a groove 1.4 mm below the parting (0.6 mm of tray above it).

**Where the lid sits.** The lid hangs on the hinges 100 mm behind the snap, and the engagement is whatever the bump
overlaps the tray's edge by: 0.45 − 0.05 (lip to recess face; the lip rides on it) = 0.40 mm by the drawn numbers,
0.37 mm on the built parts, less 0.1 mm for every 0.1 mm the lid sits forward. `src/latch_plate.py` solves the wall as
a Kirchhoff plate (Morley triangles, scikit-fem; E = 3.5 GPa, ν = 0.35; ceiling and end walls rigid, so the real wall
is somewhat softer): 24.9 N/mm at the bump; peak strain 0.41 % at 0.40 mm, spread over the zone (keep under ~0.5 %
across the layers; 0.46 % at 0.45 mm); an outward pull of ~17 N at the bump brings it to ~25 MPa. A plain 2.0 mm wall
without the zone would be four times as stiff. Behind the tray's recess 1.95 mm of wall stay, behind the groove
1.50 mm. (An earlier note here, that the model overstates the hold several times over, was drawn from snaps that
never engaged; it is withdrawn.)

**Simulation.** `tools/snap_sim.py` (`make sim`, all cases in `out/snap_sim.md`) closes the built lid on the built
tray: a section of the two STLs through the lip, the lid rigid on the hinge's arc, the lip as a spring (the plate
model), friction 0.3 on the ramps, then the hinges' spring-back (0.5–1.3 N) lifting the front edge. The lid may sit
off its drawn position front to back, shift freely about it, or give. Forces at the front edge:

| the lid, front to back | to close | holds | |
| --- | --- | --- | --- |
| where it was drawn | 13 N | 17 N | the lip bends 0.36 mm |
| 0.1 mm forward | 9 N | 12 N | |
| 0.2 mm forward | 4 N | 7 N | |
| 0.3 mm forward | 1 N | 2.6 N | opens when handled |
| 0.4 mm forward | – | 0 | the bump does not reach its groove: no click |
| 0.1 mm back | 18 N | 22 N | strain 0.47 % |
| 0.2 mm back | 23 N | 27 N | hard to close, strain 0.57 % |
| free to shift by ±0.2 / ±0.3 mm | 4 / 1 N | 7 / 2.6 N | the ramp pushes the lid forward as far as it goes |
| as drawn, the lip's printed gap 0.10 mm wider / tighter | 9 / 18 N | 12 / 22 N | |

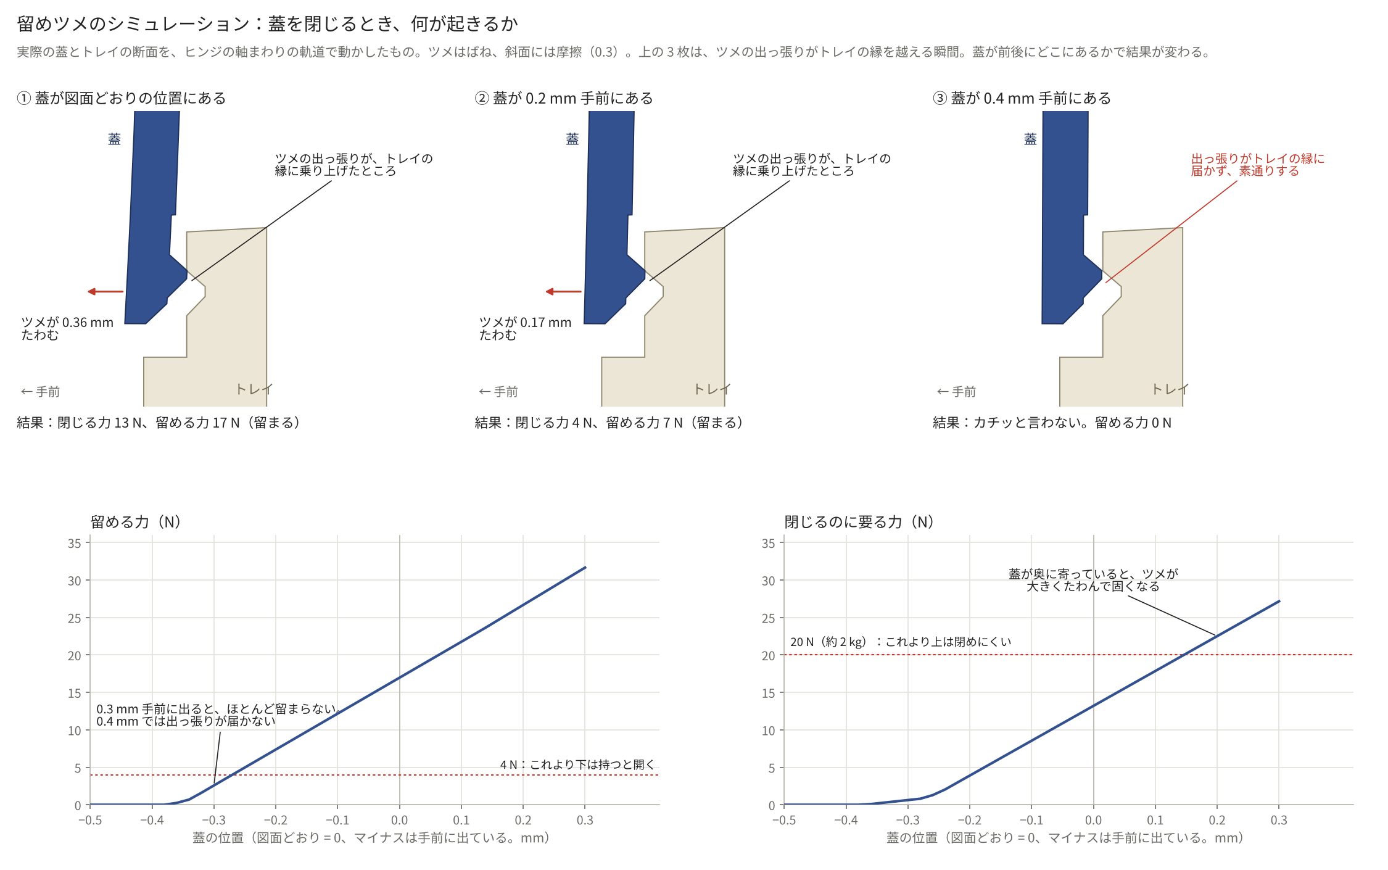
[picture p9: docs/images/snap_sim.png]
The snap, simulated: three positions of the lid at the moment the bump is on the tray's edge, and hold and closing force against where the lid sits


So the snap holds for a lid within about −0.2…+0.1 mm of its drawn position. Where the real lid sits and how freely
it moves are inputs, not results; if the closed lid's front face stands proud of the tray's by more than about 0.2 mm,
measure the step: the lip has to be moved by that much. The simulated push is the hinges' spring-back only. Rims that
meet near the hinges lever the lid open with far more (see "Relief at the hinge side" under the hinges); the snaps
printed so far (12 mm and 30 mm lips), which never held, were up against that.

**No stops.** For one revision (never printed) two tongues on the lid, either side of the flex zone, reached down
inside the tray's front wall to keep the bump's ramp from pushing the lid forward. They are gone
(`LATCH["stop"] = None`; the code is still there): the levering at the hinges is the likelier reason the snaps did
not hold; a lid that sits more than 0.3 mm forward and does not give would have ridden up on the tray's wall with
them (simulated: 29 N to close at 0.3 mm, 44 N at 0.4 mm); and they could not be put where the lip is, as asked: the
tray's wall is full there (the pad behind the recess), and the lid's wall there is the part that bends.

**The faces' angles.** `LATCH["close_deg"]` / `["open_deg"]` (30°, 35°) set how far each flank runs along the lip, but
the bump's profile is rooted 0.3 mm inside the lip, so the faces themselves stand at 44° and 49° to the closing
direction (`build.py`, `latch_flanks`). Earlier revisions of this page quoted ~7.9 N to close and ~9.5 N of hold,
worked out for 30° / 35° faces; the forces above are those of the faces as built. The geometry is unchanged (every
printed version had these faces).

The snap coupons of plate 0 take in the whole flex zone (45 mm wide): put the lid piece over the tray piece's wall,
click it down and pull it off before printing the lid and the tray. Too hard to open: file the bump's upper flank a
little, or lower `LATCH["bump"]`.

There is no finger grip: the lid is opened at the seam of the front edge (about 18 N by the simulation with the lid where it was drawn, less if it sits forward: snap +
hinge friction − the lid's weight) while the other hand holds the base, which is lighter than that pull.

### Checks run by `src/build.py` (kit)
Kit envelope vs lid and vs panel, a straight USB-C plug in the port vs lid and vs panel, panel vs lid and vs tray, lid vs
tray, the keyboard's room (tray floor to `KB_TOP_Z`) vs lid, tray (deck, pads, bosses) and panel, split halves (lid,
panel, tray), splice plates vs their pieces, hinge leaves / barrels / covers vs both halves, and for every lid-A variant
a female-connector envelope (ears + body) vs lid, panel and kit: all 0 mm³ (the covers' crush ribs press 0.16 mm³ each into
their pockets, logged apart). Lid + kit + panel + covers rotated 0–180° about the real hinge axis: no contact with the
tray; the lid reaches the table at 162.2°. With the axis 0.15 mm further in (exactly at the back face) still none;
0.3 mm further in, the lid meets the tray at 170°. With the keyboard's charge plug in, the lid opens to 95°.

### Tipping
Lid side 138 g (printed parts as sliced + kit 43.1 g + half the hinges), centre of mass 49.0 mm in front of the hinge
axis; base 64 g without the keyboard, tipping about the back edge of the tray's bottom (y = 53.0): a
keyboard of **83 g** keeps it upright up to the table contact at 162.2° (`out/print_report.md`; the tray's centre of mass is taken from its solid shape,
which puts too much weight in the infilled strip behind the keyboard, so this errs on the safe side).

### Colour mock-ups
`make render` also draws the closed and open views in three palettes: all black, all khaki, and a mix (khaki lid, black
tray and panel): `docs/images/render_{open,closed}_{black,khaki,mix}.png`.

### Hinge
* **Parts:** 2 × Sugatsune **HG-MF08** (free-stop, 0.0784 N·m ±25 % each, POM, 20 × 25 × 2.0 mm, holes Ø2.4 with Ø4.2
  countersink, pitch 10 along / 16 across the axis, from Sugatsune's spec table). The lid side (138 g with the kit, the
  panel and the covers, centre of mass 49.0 mm from the axis) needs about 0.07 N·m held horizontal, so the pair
  (0.157 N·m) holds it at any angle and still opens easily; it never falls shut by itself. **Spring-back:** let go,
  a friction hinge turns back a little (the twist stored in the POM hinge and its seats). At any other angle that is
  made up for by pushing a little further; at the closed position the lid lands on the tray and cannot go further, so
  an unlatched lid stays a little open at the front (1° = 1.7 mm). The snap holds it down (see "Snap").
  **Relief at the hinge side (`PART_RELIEF`):** reported from the built device: with the hinge screws tight the lid
  opens, with the screws loose it stays shut. The axis lies in the parting plane, 0.15 mm behind the back face, so the
  two rims met 1.65 mm from it while the front edge is 60 times further out: rims that come out 0.05 mm proud there
  (the top surfaces of both prints) hold the front edge 3 mm open as soon as the countersunk screws pull the leaves
  home; loose leaves let the lid's back rise instead. So the lid's underside now leans up from y −40 to 0.4 mm at the
  back face (0.16 mm half way): the lid lands on its front edge and the rims near the hinges never meet. Only the lid
  changes. How much of the lid's coming up was this rather than the hinges' spring-back is not known; it may be most
  of it, in which case the snap has had far more than 1.3 N to hold. Not printed yet. The catalogue's
  maximum opening is 260°, so the flat (closed) position is not at a stop. HG-MF15 (0.147 N·m) is 30 mm long with M3 holes:
  `HINGE_LEN = 30`, `HINGE_HOLE_PITCH_X = 20`.
* **Axis** at the outer back edge, on the parting (z = 12.85). Sugatsune's 3D model shows a flat back and a barrel (≈ Ø5.5)
  on the front only, its axis ≈ 3.2 mm above the flat back (`HINGE_AXIS_ABOVE_BACK`). Seated flat side down 1 mm below
  the back face (under the flush covers), the axis is at y ≈ 53.15, 0.15 mm outside the back face (y = 53.0); the motion
  check, the tipping estimate and the renders rotate about that axis. The original knuckle, ears, knob-pins and trough are removed.
* **Mounting:** each leaf sits in a 3.05 mm mortise (2 mm leaf + 1 mm cover, 0.25 mm clearance per side) with a slot for
  the barrel; 4 × M2×8 countersunk tapping screws per hinge go through the cover and the leaf, 5 mm into the back (Ø1.8
  pilots). Instead of a solid housing, each hinge sits on a pad (`HINGE_PAD`: the cover pocket + 2.0 mm around it, the
  mortise + 2.0 mm deep) with a Ø5.0 boss behind each pilot hole, out to 1.5 mm past the screw tip, tied to the ceiling
  (lid) or the floor (tray) by a 1.2 mm rib. Hinge centres at x = ±52 (`HINGE_X`), clear of the split at x = −72 and the
  tray's rear opening (x ≥ 72.9).
* **Back face:** `BACK_STYLE = "solid"`: the whole back face of lid and tray is at the hinge plane, so the lid's lower back
  edge is 0.15 mm from the axis and the seam between screen and keyboard stays 1.0–1.5 mm from 90 to 150° (with housings
  only behind the hinges it was 11–15 mm). Both back edges along the parting are rounded r 1.5 (`HINGE_EDGE_R`).
* **Covers** (`out/hinge_cover_lid_x2.stl`, `out/hinge_cover_tray_x2.stl`, 1.0 mm, case colour): flush in a pocket in the
  back face (0.25 mm clearance per side, r 0.5 corners; 0.3 mm chamfer round the outer face, which prints on the bed),
  overlapping the case by 1.5 mm and starting 3.6 mm from the axis;
  the tray's runs out through the bottom (`COVER_LIP` can add side lips for a deeper, stiffer cover; off). Each has two Ø4.0 × 90° countersinks over the leaf holes and under each a cone
  (Ø4.1, 0.7 mm) that fills the leaf's countersink, so the hinge screw clamps cover and leaf through a conical washer: no
  glue. Two crush ribs on each side edge (`COVER_RIBS`: 0.25 → 0.35 mm proud from the inner face to the chamfer, so up to
  0.1 mm into the pocket wall) hold a cover in its pocket when pressed in, before or without the screws; tune them by
  reprinting the covers only. Flush covers sink the leaves by their thickness, which moves the axis in by as much: at
  2 mm the plate would put the axis inside the back face, hence the 1 mm plate.
* **Checks:** lid + kit + panel + covers rotated 0–180° about the axis do not touch the tray + covers; on a table the lid
  reaches the table at 162.2° (opening limit). The axis height is read off Sugatsune's 3D viewer: moved 0.3 mm further in,
  the lid would meet the tray at 170° (past the table limit, thanks to the r 1.5 edges). Hinge envelopes and covers vs
  lid / tray: 0 mm³.
* The hinge's 25 mm leaf span sets a floor of about 26 mm for the closed height at the back, whatever the keyboard.

### Keyboard charge port
The original tray has an opening in its back wall at x 72.9–89.1, probably for the CACOE's charge port; the new tray
keeps it (from 3.0 mm above the floor, `TRAY_PORT`), and the deck is open above it. `build.py` checks a straight plug with a 12 × 6.5 mm overmold: 0 mm³
against tray and closed lid; **with the plug in, the lid opens to 95°** (the full-width back face meets the plug beyond
that). Any plug whose overmold fits the original opening (≈ 16 × 6.8 mm) fits.

### Printing
* **Plates** (`3mf/`, A1 mini, 180 × 180 mm): `plate0_test_coupons` (24 min, 10 g, print first), `plate1_lid` (lid A + B,
  2 lid covers, 2 splice plates, 1 h 45 min, 65 g), `plate2_tray` (tray A + B, 2 tray covers, 1 splice plate, 1 h 32 min,
  62 g), `plate3_panel` (panel A + B, 3 splice plates, 38 min, 24 g): 151 g and 3 h 54 min for plates 1–3.
  `3mf/usb_variants/` holds lid A for a panel-mount female.
* **One piece** (`3mf/large/`, 220 × 220 mm plates): lid (1 h 40 min, 65 g), tray (1 h 28 min, 61 g), panel (35 min,
  24 g): 150 g and 3 h 42 min, nothing to glue; `3mf/large/usb_variants/` holds the panel-mount lids in one piece.
* **Orientation:** lid top face down (the export tilts the sloped top plane level first, `LAY_TOP` from `assembly.json`),
  panel visible face down, tray floor down, covers visible face down (the cones face up), splice plates flat. No supports.
* **Settings, 0.4 mm nozzle** (Bambu Studio): 0.20 mm Standard, PLA, textured PEI, **3 wall loops** (material around
  the screw pilots), 15 % gyroid, brim Auto. Times and masses above are PrusaSlicer estimates with an approximation of
  that profile (`tools/a1mini_pla_020.ini`, `out/print_report.md`); Bambu Studio's own numbers differ somewhat.
* **Settings, 0.2 mm nozzle** (the author's A1 mini; the panel was sent to print with them): Cool Plate (SuperTack), PLA Basic,
  0.14mm Extra Draft @BBL A1M 0.2 nozzle with three changes in Quality: elephant-foot compensation 0.1 mm (the visible
  face is the first layer; keeps the window and slot edges and the 0.2 mm lid clearance), precise Z height on (the 1.6 mm
  panel and the 1.0 / 0.8 mm splice pockets come out exact), Arachne walls (fills the 2.0 mm walls and the 1.2 mm ribs and guards).
  The rest as in the profile (4 walls, 7 top / 5 bottom layers: the panel prints solid). Bambu Studio, 2026-11-08,
  including ~8 min of preparation: plate 0 1 h 11 min 5.7 g, plate 1 6 h 29 min 45.2 g, plate 2 5 h 45 min 40.0 g,
  plate 3 3 h 42 min 25.3 g: 15 h 56 min and 110.4 g for plates 1–3, 5–6 × the 0.4 mm nozzle's time for the same PLA.
  The 3MFs carry no print settings; pick these after opening.
* **Slicer warnings:** none on any plate. Thin-wall notes: the USB-C ceiling (0.8 mm), the panel's snap ridges, the
  covers' countersink edges, and the splice pockets (half the wall until the plate is glued in).
* **Test coupons** (`plate0_test_coupons.3mf`, cut from the real parts in print orientation): hinge seats from tray and lid
  (put a real HG-MF08 and a cover in: cover flush, barrel free, M2×8 bites, opens past 160°), the snap lip with its flex zone and both stops, and its recess (clicks shut, stays shut against a finger pushing up with ~3 N, lifts off; tune `LATCH["bump"]` in 0.05 mm steps), and one cover of each kind. Other fits: `HINGE_CLR`,
  `HINGE_BARREL_D`, `HINGE_PILOT_D`, `HINGE_AXIS_ABOVE_BACK`, `COVER_POCKET_CLR`, `COVER_RIBS`, `COVER_CSK`,
  `SPLICE["clr"]`.

### Hardware
* 14 × **M2×8 countersunk tapping screws** for plastic: 8 hinges (through the covers), 6 panel.
* 2 × **Sugatsune HG-MF08** (-WT or -BL; hidden under the covers).
* M5Stack **PaperDIY Complete Kit** (K159-B), used in its own case.
* A straight USB-C cable whose overmold is ≤ 12 × 6.5 mm, or (optional) a short panel-mount USB-C extension with M3 ears
  16–30 mm apart and ears + body ≤ 7.2 mm tall, with the matching lid A.
* CA gel or epoxy (seams and splice plates of the split parts); thin double-sided tape if the keyboard is loose.
* Parts list with numbers matching the exploded view: [bom.csv](bom.csv); assembly order: [ASSEMBLY_ja.md](ASSEMBLY_ja.md).

### Measure on the real parts
* **Keyboard thickness** over the keycaps: `KB_THICK` (assumed 11.5 mm, as the original lid allowed; `KB_TOP_Z` =
  `TRAY_FLOOR` + `KB_THICK`). Every millimetre less comes off the lid.
* **Keyboard play**: the kit tray keeps the original's 196 × 87 mm room with nothing to locate the keyboard, so the
  keyboard (estimated 194 × 85 mm, `KB_SIZE`) moves about 2 mm front to back and sideways as in the original. If that bothers: removable
  tape under the keyboard, or measure it and close the room up (`KB_FACE_X`, `KB_FACE_Y`).
* **Keyboard weight**: 83 g or more keeps the device upright up to the table contact; see "Tipping".
* **Hinge barrel and axis**: read off Sugatsune's 3D viewer, not a drawing; join the hinge coupons with a real hinge.
* **The kit's printed case**: modelled from M5Stack's 3D file (120.0 × 67.0 × 6.3, r 3); the panel's rim has 0.2 mm clearance.
* **CACOE charge port / switch** positions are inferred from the original tray's openings (`KB_CUTS_ENABLED` adds others).

### Verification performed
Every STL re-loaded: watertight, consistent winding, one body, pieces ≤ 175 mm (one-piece parts ≤ 214 mm). Zero-volume
interference in the closed assembly between lid, panel, tray, the kit envelope, a USB-C plug in the port, the keyboard's
room and every panel-mount connector envelope; split halves; splice plates; hinge envelopes and covers; lid + kit +
panel + covers rotated 0–180° about the hinge axis, also with the axis 0.15 and 0.3 mm further in; the keyboard's charge
plug while opening; the snap lip along its real opening arc. PrusaSlicer slice of every plate, wall thickness by ray
casting, a comparison of the sliced toolpaths with the model (0.4 mm nozzle), tipping estimate, the snap as a plate
model, two builds byte-identical, renders inspected. **Printed so far:** the earlier bare-kit design, and this design,
first with 1.2 mm and then with 2.0 mm walls, up to one complete device that is in use (2026-11-11, with a snap that does not catch yet:
[photo](../docs/images/photo_2026-11-11.jpg)); what those prints showed (soft walls, tight covers and splice plates, the lid lifting
by the hinges' spring-back, the snap not holding, tight hinge screws levering the lid open, the keyboard ribs in the way, the TPU feet a nuisance to make) is
corrected here. **Not done:** no print of the present revision; no FEA beyond the snap's plate model; the Bambu Studio
projects have not been opened in Bambu Studio.

## Changes vs. the original (for the licence "indicate changes")
**Kit design (default):** none of the original meshes is used. The lid is a new hollow part that follows the original's
outline (corner radii halved to 3 mm, no chamfers) and parting surface, with hinge pads and bosses, panel bosses, ribs, a
USB-C opening and guides, the hinge mortises and a snap lip on a thinned zone of the front wall; the bezel panel is new (window, rim, finger slots, KEY guard,
countersunk holes, snap bumps). The tray is a new thin shell with the original tray's outline (r 3), parting, keyboard room
(as the opening of a deck flush with the rim) and rear opening, plus hinge pads and bosses and a recess + groove for the snap lip. New parts: 4 hinge covers,
the splice plates, the lid-A variants and the test coupons.

**Earlier design (`PD_MOUNT = "bare"`):**
1. **Display Panel:** Palma window, Palma button slots and both vent grilles filled. New PaperDIY window, locating lip, strap
   posts, push-rod cradles, battery bay, USB-plug relief. Outline and the 4 corner screw holes are untouched (original mesh kept).
2. **Display (lid):** front-wall Palma side-button slot (incl. ceiling-edge notch) and right-wall Palma USB opening **closed**,
   rebuilt by extruding the adjacent original wall profile. A ray scan found **0 deviations** from the original outer surface
   (flat wall at y = −46.5 / x = +101, same top chamfer). Added: panel-mount USB-C opening + 2 screw holes (inner fillet
   squared behind them) and the power-rod bore (left wall), 2 key-rod bores (front wall), battery ceiling relief.
   **Hinge knuckle removed**, back wall rebuilt (original 3 mm) with a 9.5 mm housing and two tapered ribs behind each
   hinge, two hinge mortises with barrel slot and pilot holes, 14 triangular ribs between the long walls and the ceiling
   (see "Hinge"). **Camera window filled** (flat top). The 4 corner insert holes are refilled and re-drilled as Ø1.8 pilots for M2×8 tapping screws.
   Label recess, vents and corner bosses otherwise unchanged.
3. **Keyboard (tray):** **hinge ears and trough removed**, back wall rebuilt (original 3 mm) with a 9.5 mm housing and two
   tapered ribs behind each hinge, two hinge mortises with barrel slot and pilot holes, bottom chamfer squared under the
   leaves. Keyboard cut-outs otherwise unchanged by default
   (`KB_CUTS_ENABLED = False`). The original right-wall (y 26.3–36.7) and
   rear-wall (x 72.9–89.1) openings are kept; they are probably the CACOE port/switch cut-outs of the original design (not
   verified). If the real keyboard's port/switch are elsewhere, set `KB_CUTS_ENABLED = True`, measure `KB_*` and rebuild.
4. New parts: strap, 3 push-rods, 4 hinge covers, optional top plate, optional front clip and magnet drilling jigs, test coupons. Split versions of lid / tray / panel,
   lid-A variants for other USB-C cables. The original knobs and label are not used.

## Sources of measured dimensions
* PaperDIY Assembly Kit mechanical drawing **K159_PaperDIY_Assembly_Kit_model_size.pdf**
  (m5stack-doc.oss-cn-shenzhen.aliyuncs.com/1287/…). Text is not extractable (CJK font map missing), so the dimension values
  and positions were read from the PDF's vector geometry (scale 1:2): 115.3 × 62.5 × 5.5, PCB from 67.9, M2 at 77.9/centre
  (d2 in d4, top depth 5.4), keys at 72.9 & 84.9 (12.0 apart; actuator 1.72), short-edge switch 6.84 + 1.72, USB-C
  50.78–59.72 (8.94) protruding 1.75, module and antenna outline.
* **M5_Hardware/Products/K159-B_PaperDIY_Complete_Kit/Structures/PaperDlY_Complete_Kit.stl** (GitHub): cross-checked the
  above (kit back-cover hole at the M2 position, button caps 12.0 apart, USB-C position) and gave the **window 105.01 × 59.72**
  with its offsets (1.39 / 8.90 / 1.39).
* M5 docs (docs.m5stack.com/en/products/sku/K159): size, power button / KEY1 = G4 / KEY2 = G3, SH1.0-2P battery connector.
* Sugatsune HG-MF spec table (global.sugatsune.com/eu/en/tech/products/21651_t) and retailer listings: L / W / t / W2 / H2,
  holes, torque. The barrel is not in the table: `HINGE_BARREL_D` = 5.5 and `HINGE_AXIS_ABOVE_BACK` = 3.2 are read off
  Sugatsune's online 3D viewer (end view, scaled by the 25 mm width), so they are good to a few tenths of a mm.
* Original enclosure geometry: sections and ray probes of the phone-enclosure STLs.

## Licence & attribution
Derived from **"The PDA Terminal" / phone-enclosure by Un Kyu Lee** — https://github.com/unkyulee/phone-enclosure —
licensed **CC BY-NC 4.0** (https://creativecommons.org/licenses/by-nc/4.0/). The models and the images made from them
(`out/`, `3mf/`, `renders/`, `../docs/images/`) are under the same licence, non-commercial use only: see
[LICENSE.md](LICENSE.md). The scripts that build them (`src/`, `tools/`) and the documentation are under the
repository's [MIT License](../LICENSE). Changes are listed above. The PaperDIY is a product of M5Stack; its dimensions come from M5Stack's
published drawing and structure files.

## Parameters (`src/params.py`, all of them)
| Parameter | Value | Status | Note / source |
|---|---|---|---|
| `PD_MOUNT` | `"kit"` | design choice | `"kit"`: Complete Kit in its case in the lid; `"bare"`: the earlier design (env `PD_MOUNT` overrides) |
| `CAD_DIR` / `OUT_DIR` / `SPLIT_DIR` / `WHOLE_DIR` / `RENDER_DIR` / `HOME` / `ORIG_DIR` | this folder / `out` / `out/split` / `out/whole` / `renders` / `~` / `~/phone-enclosure/STL` | paths | where the outputs go and where the original STLs are read from (`PHONE_ENCLOSURE_STL` overrides `ORIG_DIR`) |
| `KIT_L` / `KIT_W` / `KIT_T` / `KIT_R` | `120.0` / `67.0` / `6.3` / `3.0` | measured | [M:K159-B STL] case without the caps |
| `KIT_WIN` / `KIT_WIN_OFF` | `(105.0, 59.7)` / `4.0` | measured | [M:K159-B STL] window, its offset away from the USB end |
| `KIT_KEY_CAPS` / `KIT_CAP_OUT` / `KIT_CAP_Z` | `((9.6, 20.4), (21.6, 32.4))` / `1.2` / `(2.1, 4.95)` | measured | [M:K159-B STL] KEY caps toward the USB end |
| `KIT_PWR_CAP_Y` / `KIT_PWR_CAP_OUT` | `(17.9, 28.8)` / `1.27` | measured | [M:K159-B STL] power cap on the USB end |
| `KIT_USB_Y` / `KIT_USB_Z` | `-24.0` / `(2.44, 5.6)` | measured | [M:K159-B STL] USB-C on the USB end |
| `KIT_SCREW_D` | `20.0` | measured | [M:K159-B STL] back-plate hole over the M2 standoff, toward the USB end |
| `KIT_MASS_G` | `43.1` | measured | [M: docs.m5stack.com K159-B] |
| `KIT_CX` / `KIT_FIT` / `KIT_GAP` | `-4.0` / `0.2` / `0.2` | design choice | window centred; clearance around the kit per side / behind |
| `WALL` / `CORNER_R` / `RIB_T` | `2.0` / `3.0` (bare `6.0`) / `1.2` | design choice | walls, ceiling and floor (5 lines of a 0.4 mm nozzle, 10 layers of 0.2 mm; 1.2 printed too flexible); plan corner radius (the original's halved); ribs, guides, guard rings |
| `TRAY_FLOOR` / `TRAY_KB_RIBS` / `TRAY_PORT` | `WALL` (bare `3.0`) / `None` / `x 72.9…89.1, 3.0 above the floor` | design choice | the kit tray: floor top; ribs on the end walls that locate the keyboard sideways (off: too tight in the print; e.g. `dict(end_y=(-25, 25), fit=0.5)` once the keyboard is measured); charge-port opening |
| `TRAY_DECK` | `t 1.2, r 3` (kit) | design choice | the kit tray's deck flush with the rim: thickness, corner radius of its opening (the opening itself is `KB_FACE_*`) |
| `KB_THICK` / `KB_TOP_Z` / `KB_CLR` | `11.5` / `TRAY_FLOOR + KB_THICK` (13.5) / `0.5` | ASSUMED | keyboard thickness over the keycaps -> MEASURE; its highest point; clearance under the panel |
| `KB_SIZE` / `KB_FACE_X`, `KB_FACE_Y` / `KB_PAD` | `(194, 85)` (kit; bare `None`) / `LID_INNER_X`, `LID_INNER_Y` (98, 43.5) / `clr 0.15, w 6, 4 front + 4 back + 2 per end` | ASSUMED / measured | keyboard body width × depth -> MEASURE (kit: the original room 196 × 87 less the reported ~2 mm play; used for the renders and the report only); the faces of the keyboard's room, the original tray's; bare: pads on the tray's inner walls take up the play (`None` = no pads) |
| `LID_UNDER` | `(10.4417, 0.05376)` | measured | [M] parting plane of the original lid, z = a + b y |
| `LID_SKIN` / `LID_CHAMFER` / `COVER_TOP_RIM` | `1.2` / `0.0` (bare `0.8`) / `0.8` | design choice | least skin; edge chamfers (none in the kit design); lid-cover rim above the leaf |
| `KIT_NOTCH` | `out 7, depth 5.6, end 1.5, r 2` | design choice | finger notches at the caps (`KIT_LID = "solid"`) |
| `USB_CH` | `w 13, h 7.6` | design choice | channel for a straight USB-C plug (overmold ≤ 12 × 6.5) |
| `KIT_SCREW_SEAT` | `1.6` | design choice | lid under the M2×4 head -> 2.2 mm into the kit (`KIT_LID = "solid"`) |
| `KIT_LID` | `"shell"` | design choice | hollow lid + bezel panel; `"solid"`: the solid deck with the kit in a pocket (env `KIT_LID` overrides) |
| `SHELL_WALL` / `SHELL_CEIL` / `USB_CEIL` | `WALL` / `WALL` / `0.8` | design choice | lid walls, ceiling, ceiling left over the USB-C plug path |
| `PANEL_T` / `PANEL_CLR` / `PANEL_WIN_CLR` | `1.6` / `0.2` / `0.3` | design choice | bezel panel; clearance to the lid's walls and hinge pads; window = kit window + 0.3 per side, square edges |
| `PANEL_RIM` / `PANEL_SLOT` / `PANEL_GUARD` | `h 2.0, w 1.2` / `out 8.0, end 3.0, r 0.75` / `t RIB_T, clr 0.5` | design choice | locating rim around the kit; finger slots at the caps; guard ring behind the KEY slot, up to the kit's back |
| `PANEL_SCREWS` | `(±91, −37.5), (±91, 46), (−62, −39.5), (−62, 40)` | design choice | six M2×8 into the lid's bosses, clear of the hinge pads |
| `PANEL_BOSS_R` / `PANEL_BOSS_RIBS` | `3.0` / `t 1.2, len 3, tie 5.5, gap 0.5` | design choice | radius of the panel's screw bosses; ribs on those bosses: ties into walls within 5.5 mm, else gussets |
| `PANEL_SNAP` | `x_front (−60, 26), x_back (−23, 26), len 8, h 0.45, bump 0.45, clr 0.05` | design choice | snap bumps on the panel's front and back edges, grooves in the lid's walls (tight: lower `bump`, panel only) |
| `PANEL_DOVETAIL_Y` / `DOVETAIL_Y_KIT` | `(-37.3, 0, 42)` / `(-37, 5, 36)` | design choice | panel keys (front: between the edge and the USB slot; back: between the power slot and the back edge) / lid keys |
| `PANEL_DOVETAIL` | `neck 4.5, head 7, depth 5, clr 0.2` | design choice | smaller keys for the panel (webs ≥ 2.5 mm), when `SPLIT_JOINT = "dovetail"` |
| `SPLIT_JOINT` | `"straight"` (kit) / `"dovetail"` | design choice | how the A1 mini pieces meet: a straight butt seam with splice plates, or dovetail keys as well |
| `PANEL_USB_SLOT` | `frame 2.2, half 6.6, r 0.75` | design choice | panel open over the USB-C plug path, from a 2.2 mm frame at the left edge to the kit (`None` = closed) |
| `KIT_RIBS_X` / `USB_GUIDE_X` / `SPLIT_BLOCK` | `(-50, 0, 40)` / `(-99.6, None)` / `None` (bare `7 × 7 × 3.4`) | design choice | ribs onto the kit's back; USB-C guide ribs from the end wall to the kit; ceiling blocks around the lid keys (bare design only) |
| `SPLICE` | `clr 0.3`; tray 1, lid 2 plates (t `WALL / 2`), panel 3 (t `PANEL_T / 2`), x −10…+10 / +6 / +8.4 from the split | design choice | splice plates glued on the hidden side across each seam of the split pieces, flush in pockets in both halves |
| `USB_PM_Y_KIT` | `20.0` | design choice | panel-mount female opening in the lid-A variants (clear of the lid keys and the power slot) |
| `LATCH` | `x 0, w 30, t 1.0, below 2.6, bump 0.45 @ 1.4, clr 0.05, 30° / 35° (flank runs; the faces stand at 44° / 49°); flex x −20…20, t 1.1, top 2; stop `None` | design choice | snap: lip on a thinned zone of the front wall, no slits, 0.37 mm engagement with the lid where it was drawn; no stops (see "Snap") |
| `PANEL_Z_FRONT` | `15.0` | measured | [M:Display Panel.stl] screen-side face |
| `PANEL_Z_BACK` | `18.0` | measured | [M:Display Panel.stl] back face, seats against lid corner bosses |
| `LID_CEILING_Z` | `27.0` | measured | [M:Display.stl] ceiling underside (ceiling 27..30, 3.0 thick) |
| `LID_CEIL_THK` | `3.0` | measured | [M:Display.stl] |
| `LID_INNER_Y` | `43.5` | measured | [M:Display.stl] inner wall faces at y=+-43.5, x=+-98 |
| `LID_INNER_X` | `98.0` | design choice |  |
| `LID_LABEL_POCKET` | `(21.7, 78.0, 21.34, 32.5)` | measured | [M:Display.stl] x0,x1,y0,y1 of top label recess (ceiling only 1.5 thick) |
| `LID_FRONT_SLOT_X` | `(-51.5, -6.5)` | measured | [M:Display.stl] Palma side-button slot in front wall, z 19..27 + ceiling edge |
| `LID_RIGHT_OPEN_Y` | `(-6.0, 6.0)` | measured | [M:Display.stl] Palma USB opening in right wall (x=+101), z 19..27 |
| `INSERT_M2_D` | `3.2` | measured | [M:Display.stl corner bosses d=3.18; readme: M2 insert OD3.2 L3] |
| `INSERT_M2_L` | `3.0` | measured | [M:readme] |
| `PD_L` | `115.3` | measured | [M:K159 PDF] display/board length |
| `PD_W` | `62.5` | measured | [M:K159 PDF] display/board width |
| `PD_T` | `5.5` | measured | [M:K159 PDF] overall thickness (front face -> tallest part) |
| `PD_PCB_TOP_FROM_TOP` | `67.9` | measured | [M:K159 PDF] PCB starts 67.9 from the non-USB end |
| `PD_PCB_OVERHANG` | `0.85` | measured | [M:K159 PDF] PCB 'ears' 64.2 wide vs display 62.5 (0.85/side) only for v>=108.9 (USB end); depth 1.4..2.4 |
| `PD_M2_FROM_TOP` | `77.9` | measured | [M:K159 PDF] single M2 standoff, centred across width (30.2 from edge line @61.45 -> 31.25) |
| `PD_M2_STANDOFF_H` | `5.4` | measured | [M:K159 PDF side view] standoff top depth from screen face (PCB back at 2.4 -> 3.0 tall) |
| `PD_M2_STANDOFF_OD` | `4.0` | measured | [M:K159 PDF] d4 circle (thread M2 d2) |
| `PD_MAX_THREAD` | `3.0` | given | [given] screws must engage < 3 mm into the PaperDIY standoff |
| `PD_KEY_FROM_TOP` | `(72.9, 84.9)` | measured | [M:K159 PDF] side keys (12.0 apart; 30.14 dim) on long edge, actuator 1.72 wide |
| `PD_KEY_DEPTH` | `2.95` | measured | [M:K159 PDF side view] actuator centre depth from screen face (2.67..3.23) |
| `PD_KEY_PROTRUDE` | `0.05` | measured | [M:K159 PDF] actuator tip beyond display edge |
| `PD_PWR_FROM_KEYEDGE` | `62.5 - 7.85` | measured | [M:K159 PDF 6.84+1.72/2 from far edge] power button on USB short edge  (=54.65) |
| `PD_PWR_DEPTH` | `3.27` | measured | [M:K159 PDF side view, 2.84..3.69] (inferred to be the power button: the lone short-edge switch) |
| `PD_PWR_PROTRUDE` | `0.7` | measured | [M:K159 PDF ext. line @116.0 vs edge 115.3; kit cap at 0.72] |
| `PD_USB_FROM_KEYEDGE` | `62.5 - 55.25` | measured | [M:K159 PDF 50.78..59.72] USB-C centre 7.25 from the key edge |
| `PD_USB_W` | `8.94` | measured | [M:K159 PDF] |
| `PD_USB_DEPTH` | `(1.64, 4.8)` | measured | [M:K159 PDF side view] |
| `PD_USB_PROTRUDE` | `1.75` | measured | [M:K159 PDF 117.05 - 115.3] |
| `PD_WIN_W` | `105.0` | measured | [M:K159-B kit STL window 105.01 x 59.72 at inner face] |
| `PD_WIN_H` | `59.72` | design choice |  |
| `PD_WIN_FROM_TOP` | `1.39` | measured | [M:K159-B kit STL] window offset from non-USB end |
| `PD_WIN_FROM_USB` | `8.90` | measured | [M:K159-B kit STL] window offset from USB end (FPC/bond area hidden) |
| `PD_ANTENNA_FROM_TOP` | `(70.0, 88.0)` | measured | [M:K159 PDF] WROOM-1 antenna zone, on the long edge opposite the keys |
| `PD_TOP_X` | `55.8` | derived | [D] x of the non-USB end; USB end = 55.8-115.3 = -59.5 |
| `PD_CY` | `0.0` | derived | [D] centred across the lid |
| `FIT` | `0.3` | ASSUMED | [A] display-to-rim clearance per side |
| `RIM_W` | `1.6` | design choice | locating lip width (>= MIN_WALL) |
| `RIM_H` | `1.0` | design choice | rim z 18..19 stays below PCB (z 19.4) and USB-C (z 19.64) |
| `WIN_CHAMFER` | `1.5` | derived | [D: same 1.5/side bevel as original panel window] |
| `PANEL_KEEP_VENTS` | `False` | design choice | original Palma "speaker" slots: filled (left ones sit over the battery pocket) |
| `STRAP_X` | `-22.6` | design choice | strap centre line (standoff at x=-22.1, posts at x=-22.6) |
| `STRAP_W` | `8.0` | design choice |  |
| `STRAP_THK` | `2.0` | design choice |  |
| `STRAP_PAD_DROP` | `0.5` | design choice | pad under the screw reaches the standoff top; elsewhere 0.5 higher (module is 5.45 tall) |
| `STRAP_POST_Y` | `36.0` | design choice |  |
| `STRAP_POST_SIZE` | `6.4` | design choice |  |
| `STRAP_SCREW_LEN` | `4.0` | design choice | ISO 7046 M2x4 countersunk -> 1.5 mm into the standoff (M2x5 -> 2.5 mm, still < 3) |
| `CSK_D` | `4.2` | design choice | countersink for M2 ISO 7046 (head 3.8) |
| `M2_CLEAR` | `2.4` | design choice |  |
| `ROD_D` | `3.0` | design choice |  |
| `ROD_HOLE` | `3.4` | design choice | +0.4 slide clearance |
| `ROD_GAP` | `0.3` | design choice | rest gap rod tip -> actuator |
| `ROD_COLLAR_D` | `5.5` | design choice |  |
| `ROD_COLLAR_T` | `0.8` | design choice | thin enough that a rod pushed fully in still clears the panel cradle |
| `ROD_PROUD` | `1.0` | design choice | rod end proud of the outer wall (plain rods, `ROD_SNAP = None`) |
| `ROD_SNAP` | `play 0.9, catch 0.35, slot 1.0 × 7.5` | design choice | split snap tip: barbs click past the outer face |
| `BATT_L` | `50.0` | ASSUMED | [A] cell length (along y) default 50x34x10 "~2000 mAh" |
| `BATT_W` | `34.0` | ASSUMED | [A] cell width  (along x) |
| `BATT_T` | `10.0` | ASSUMED | [A] cell thickness |
| `BATT_CLR` | `0.5` | design choice | side clearance and minimum top clearance |
| `BATT_WALL` | `1.6` | design choice |  |
| `BATT_CX` | `76.9` | design choice | bay centre x (between PaperDIY end and right wall) |
| `BATT_CY` | `-4.5` | design choice | shifted -y so the ceiling relief stays clear of the 1.5 mm-thin label recess |
| `MIN_WALL` | `1.6` | design choice |  |
| `USB_PM_W` | `13.0` | ASSUMED | [A] opening width  (along y); narrowed for close screw spacings |
| `USB_PM_H` | `7.0` | ASSUMED | [A] opening height (along z) |
| `USB_PM_R` | `1.0` | design choice |  |
| `USB_PM_Y` | `1.0` | ASSUMED | [A] offset from the PaperDIY port (y=-24) so the cable can loop; 30 mm ears clear the power rod |
| `USB_PM_Z` | `22.5` | design choice |  |
| `USB_PM_SCREW_SPACING` | `28.0` | ASSUMED | [A] default in plate 1 -> MEASURE |
| `USB_PM_SCREW_D` | `3.4` | ASSUMED | [A] M3 clearance (use 2.4 for M2 ears) |
| `USB_PM_WEB` | `1.2` | design choice | minimum wall between the opening and a screw hole |
| `USB_PM_VARIANTS` | `(0, 16, 18, 20, 22, 25, 28, 30)` | design choice | lid-A variants (0 = opening only) |
| `USB_PM_EAR` / `USB_PM_BODY` | `4 past hole, 8 tall, 3 thick` / `13 × 7 × 25` | ASSUMED | connector envelope for the fit check |
| `KB_PORT_BAY` / `_X` / `_Z` / `_R` | `True` / `(70.5, 91.5)` / `(4.0, 15.5)` / `1.5` | design choice | charge-port bay back to the original wall face (`BACK_STYLE = "solid"` only) |
| `KB_PLUG` | `12 × 6.5 overmold at x 81, 6.4 above the tray floor` | ASSUMED | straight USB-C plug for the fit / opening check |
| `ROD_FLAT` | `0.9` | design choice | push-rod flat below the axis (2.4 mm on the bed) |
| `ORIG_REPO` / `ORIG_COMMIT` / `ORIG_SHA256` | `a21bfd6…` | pinned | original phone-enclosure version the build accepts |
| `KB_CUTS_ENABLED` | `False` | design choice | `True` cuts the extra keyboard port / switch openings below (`KB_PORT_*`, `KB_SW_*`) into the tray |
| `KB_PORT_WALL` | `"left"` | ASSUMED | [A] TODO measure: left short wall (x=-101) |
| `KB_PORT_Y` | `10.0` | ASSUMED | [A] TODO |
| `KB_PORT_Z` | `6.5` | ASSUMED | [A] TODO centre height (floor top is z=3) |
| `KB_PORT_W` | `10.0` | ASSUMED | [A] TODO |
| `KB_PORT_H` | `5.0` | ASSUMED | [A] TODO |
| `KB_SW_Y` | `-15.0` | ASSUMED | [A] TODO switch notch centre (same wall) |
| `KB_SW_W` | `8.0` | ASSUMED | [A] TODO |
| `KB_SW_BOTTOM_Z` | `5.5` | ASSUMED | [A] TODO notch bottom (wall top there is ~z 9.6) |
| `SPLIT_X_LID` | `-72.0` | design choice | clear of the hinges (/x/ 42..62) and camera window (x>=-68.9) |
| `SPLIT_X_TRAY` | `-72.0` | design choice | clear of the hinges and rear opening (x 72.9..89.1) |
| `SPLIT_X_PANEL` | `-74.2` (bare `-72.0`) | design choice | kit: 2.2 mm clear of the power slot (x >= -72.0), panel B 173.0 mm; bare: of the window bevel |
| `MAX_PIECE` / `WHOLE_BED` | `175.0` / `220.0` | design choice | longest split piece (A1 mini); bed the one-piece plates are laid out on |
| `DOVETAIL` | `dict(neck=6.0, head=10.0, depth=6.0, clr=0.2)` | design choice | glued dovetail keys (0.4 total clearance) |
| `DOVETAIL_Y` | `(-25.0, 0.0, 25.0)` | design choice |  |
| `DOWEL_D` | `3.3` | unused | (old lid seam pads) |
| `LID_PAD` | `dict(...)` | unused | (old lid seam pads; `LID_SEAM = "dovetail"` replaces them) |
| `HINGE_LEN` / `HINGE_WIDTH` / `HINGE_LEAF_T` | `20.0` / `25.0` / `2.0` | measured | [M:Sugatsune spec table] HG-MF08 L / W / t |
| `HINGE_HOLE_PITCH_X` / `HINGE_HOLE_OFF` | `10.0` / `8.0` | measured | [M:Sugatsune spec table] H2 = 10, W2 = 16 |
| `HINGE_BARREL_D` | `5.5` | measured | [M: Sugatsune 3D viewer, ± a few 0.1 mm] |
| `HINGE_AXIS_ABOVE_BACK` / `HINGE_AXIS_Y` | `3.2` / `≈ 53.15` | measured / derived | axis height above the hinge's flat back; real rotation axis |
| `HINGE_MODEL` / `HINGE_TORQUE` / `HINGE_TORQUE_TOL` | `Sugatsune HG-MF08 × 2` / `0.0784` / `0.25` | measured | [M:Sugatsune spec table] free-stop torque per hinge in N·m and its tolerance (the snap and tipping estimates use them) |
| `HINGE_SCREW` / `HINGE_SCREW_LEN` / `HINGE_SCREW_DEPTH` | `M2×8 countersunk tapping × 8` / `TAP_SCREW_LEN` / `5.0` | design choice | hinge screws through cover and leaf; depth into the back = length − `HINGE_SINK` − `HINGE_LEAF_T` |
| `HINGE_X` | `52.0` | design choice | hinge centres at +-52 |
| `HINGE_CLR` | `0.25` | design choice | mortise clearance per side |
| `HINGE_PILOT_HOLES` / `HINGE_PILOT_D` | `True` / `1.8` | design choice | printed pilots for M2 tapping screws |
| `BACK_OLD_Y` / `BACK_EXTRA` / `Y_BACK` | `46.5` / `6.5` / `53.0` | measured / design choice / derived | the original's outer back face (and, mirrored, its front face); hinge housings 3.0 -> 9.5 mm deep; new back face / axis plane |
| `BACK_STYLE` | `"solid"` (kit) / `"housings"` (bare) | design choice | whole back face at the hinge plane (`"housings"`: 9.5 mm only behind the hinges) |
| `HOUSING_HALF` / `HOUSING_GUSSET` | `13.5` / `5.5` | design choice | bare design: housing 27 mm wide; tapered rib 5.5 mm long each side |
| `HINGE_PAD` / `HINGE_EDGE_R` | `boss_wall 1.6, skin 1.5` / `1.5` (bare `0`) | design choice | kit: hinge pad + a boss per screw (out to 1.5 past the tip) + rib; radius on the back edges along the parting |
| `LID_RIBS` | `t 1.6, depth 7.0, drop 7.5`, 7 + 7 x positions | design choice | ribs between the long walls and the lid ceiling |
| `STRAP_RAILS` | `x_end 52.3, width 6.0, rib 1.6 deep to z 20.4, feet x 18 / 49` | design choice | rails off the strap hold down the display's far end |
| `STRAP_LEGS` | `gap 0.2, t 2.0, legs y ±22…29, arms y ±20…29.5` | design choice | two legs just past the PCB's inner end (x = −12.1) stop the loose Assembly Kit PCB turning about its single standoff |
| `CLIP_X` / `CLIP_W` / `CLIP_T` / `CLIP_LIP` | `20.0` / `20.0` / `1.6` / `12.0` | design choice | front clip: profile taken at x = 20; 20 mm wide, 1.6 mm thick, lips 12 mm deep |
| `CLIP_CLR` / `CLIP_BUMP` / `CLIP_BUMP_R` | `0.1` / `0.2` / `0.8` | design choice | clip clearance; ridges 0.2 mm into the lid top and tray bottom (spring preload) |
| `MAGNETS` | `d 2.0, l 3.0, depth 4.0, y -44.8, from_end (17, 57)` | design choice | 4 pairs of 2 x 3 mm magnets in the front walls' land, 17 and 57 mm from each end face |
| `MAG_JIG` | `clr 0.15, guide_d 2.15, h 8.0, finger 3.0` | design choice | drilling jig: straddles the front wall, fence on the end face, 8 mm guide bores |
| `MAGNET_HOLES` | `False` | design choice | `True` prints the magnet holes into lid and tray (no jig needed) |
| `Z_PART` | `12.85` | measured | [M] parting line at the back |
| `BACK_ZONE_X` | `62.0` | design choice | old hinge removed and back wall rebuilt for /x/ <= 62 |
| `CORNER_C` | `(95.0, 40.5)` | measured | [M] centre of the r 6 back-corner arcs |
| `LID_HINGE_BOSS` | `w 18, depth 4, z 18.5..27` | design choice | screw boss inside the lid per hinge |
| `HINGE_MOUNT` | `"face"` | design choice | leaves flush in the back face ("parting": folded in the parting plane) |
| `HINGE_COVER` / `COVER_T` / `COVER_RIM` / `COVER_R0` | `True` / `1.0` / `1.5` / `3.6` | design choice | printed covers over the leaves |
| `COVER_FLUSH` / `COVER_SCREWED` / `HINGE_SINK` | `True` / `True` / `1.0` (kit) | design choice | covers flush in a pocket, leaves sunk by `COVER_T`, covers clamped by the hinge screws (bare: glued on top) |
| `COVER_POCKET_CLR` / `COVER_EDGE_CHAMFER` / `COVER_R` / `COVER_CSK` | `0.25` / `0.3` / `0.5` / `top_d 4.0, hole_d 2.3, cone_d 4.1, cone_h 0.7` | design choice | pocket clearance per side; chamfer round the outer face (on the bed in print); plan corner radius; countersink for the M2 head, cone into the leaf's 4.2 countersink |
| `COVER_RIBS` / `COVER_LIP` | `per_side 2, h 0.35, r 0.9` / `None` | design choice | tapered crush ribs on the covers' side edges: press fit in the pocket (tight: lower `h`; loose: raise it); optional side lips for a deeper cover |
| `FASTENING` | `"tapping"` | design choice | M2x8 tapping screws into printed pilots ("inserts": M2 heat-set inserts) |
| `SCREW_PILOT_D` / `TAP_SCREW_LEN` | `1.8` / `8.0` | design choice | one tapping-screw size everywhere |
| `LID_CORNER_HOLES` | `(+-92.8, +-38.78)` | measured | [M] panel screw bosses in the lid |
| `LID_FILL_CAMERA` / `CAMERA_FILL` | `True` / `(-69.5, -22.5, -34.8, -17.8)` | design choice | Palma camera window filled |
| `LID_SEAM` | `"dovetail"` | design choice | lid halves joined by 3 glued dovetail keys in the ceiling |
| `TOP_PLATE` | `True` | design choice | blank plate for the lid-top recess |
