tsuyoshi-otake/paperdiy-pda-terminal/cad/README_ja.md

# PaperDIY PDA 筐体（3D プリント用データ）

Un Kyu Lee さんの [phone-enclosure](https://github.com/unkyulee/phone-enclosure)（Boox Palma 2 + CACOE キーボードのクラムシェル）を元に、画面側を **M5Stack PaperDIY** に置き換えた筐体です。

- PaperDIY は **Complete Kit のケースに入れたまま**、中空の薄い蓋に入れ、画面の窓のある**化粧パネル**で押さえて M2×8 のねじ 6 本で留めます。パネルは押し込むと前後の縁の突起 4 か所が蓋の壁の溝にパチンとはまるので、ねじなしでもある程度留まります。電池はキット内蔵の 140 mAh の LiPo で、足りないときは USB-C にモバイルバッテリーをつなぎます
- **Bambu Lab A1 mini と PLA** で刷る前提で、材料と時間を減らす作りにしています。蓋とトレイは壁・天板・床とも 2.0 mm（0.4 mm ノズルで線 5 本）の殻にし、ヒンジのボスとリブで補強しています（1.2 mm の版は刷ってみて柔らかすぎました）。組み合わせる部品のすき間は片側 0.15〜0.3 mm、面取りはなし、角の丸みは元の半分（R3）、サポートは要りません
- 閉じた全体の高さは手前 23.8 mm・奥 26.4 mm です（前の設計は 30 mm）。キーボードの厚さを測って入れれば、さらに下げられます
- ボタン（KEY1・KEY2・電源）は化粧パネルの切り欠きから指で直接押せます。KEY の切り欠きのまわりには、パネルの裏にガード（壁）があり、切り欠きから落ちたごみが蓋の中に入りにくくしてあります。USB-C は左端の穴から直接挿します。あとからパネルマウントのメス端子に替えたいときは、**蓋の左端の小片（蓋 A）だけ**を刷り直します
- 閉じた蓋は、蓋と一体の**留めツメ**がトレイのくぼみに掛かってパチンと留まります。磁石や後付けの部品は要りません
- ヒンジは、市販のトルクヒンジ（スガツネ HG-MF08）2 個を背面に埋め込み、背面と面一のカバーで隠しています。カバーはヒンジのねじで共締めします。開いたときの画面とキーボードの間の継ぎ目は 1〜1.5 mm です
- **Bambu Lab A1 mini（180 mm）** で刷れるよう、蓋・トレイ・化粧パネルは 2 分割して、継ぎ目はまっすぐ突き合わせ、裏から貼る**継ぎ板**でつなぎます。印刷は 3 枚で PLA 約 150 g、時間は 0.4 mm ノズルで約 4 時間です（0.4 mm ノズルが標準で、刷れない形がないことをスライス結果で確かめてあります。0.2 mm ノズルでも刷れますが約 22 時間 40 分かかります）。造形範囲が 220 mm 角以上のプリンター用に、分割しない一体の版もあります（0.4 mm ノズルで 3 時間 46 分・150 g、貼り合わせ不要）
- ねじは **M2×8 皿タッピングねじ 14 本だけ**です（ヒンジ 8、化粧パネル 6）
- 本番の前に、**試し刷り**（0.4 mm ノズルで約 24 分）でヒンジ・カバーのはめあいと、留めツメの留まり具合を確かめられます

> **実機が 1 台、組み上がって動いています**（[写真](../docs/images/photo_2026-11-11.jpg)、2026-11-11。留めツメを直す前の版）。**刷って組むたびに出た問題を直してきた版です。**壁 1.2 mm の版では、壁が柔らかい、留めツメが長い、ヒンジカバーと継ぎ板がきつい。壁 2.0 mm の版では、ヒンジの戻りで蓋の手前が浮く、留めツメが勝手に外れる、キーボードの位置決めリブが当たる、TPU の足が作りにくい。**これらを直したいまの版そのものは、まだ刷って確かめていません**（その前の設計で分かったキーボードのがたつきや開いたときのすき間も直してあります）。データ上のチェック（全 STL が閉じた 1 個の立体、各部品 175 mm 以下、閉じた状態で部品同士・キーボードの入る空間・USB-C のプラグ・メス端子が重ならない、蓋を 0〜180° 回しても当たらない、留めツメの曲がりとひずみ、充電プラグが当たらない）と、スライサー（PrusaSlicer）でのスライス、壁の厚さ、倒れやすさの見積もりまでは済んでいます。

開いたところ

分解図

**部品表・印刷設定・組み立て手順は [ASSEMBLY_ja.md](ASSEMBLY_ja.md)**（部品表の CSV：[bom.csv](bom.csv)）にまとめました。寸法の根拠と全パラメータは英語版の [README.md](README.md) にあります。

## 印刷するファイル

**Bambu Lab A1 mini（0.4 mm ノズル）なら、`3mf/bambu_a1mini/` の `bambu_plate0…3` を開くだけです。**Bambu Studio のプロジェクトになっていて、プリンタ・プロセス（壁 3 周、ジャイロイド、Arachne、象足補正 0.1 mm、正確な Z の高さ）・フィラメント・プレートが選ばれた状態で開きます（[組み立て説明書の 2-0](ASSEMBLY_ja.md)）。下の表のファイルは形だけで、どのスライサーでも開けます。

| ファイル | 中身 | 0.4 mm ノズル | 0.2 mm ノズル |
| --- | --- | --- | --- |
| `3mf/plate0_test_coupons.3mf` | 試し刷り（ヒンジ、留めツメ、カバー） | 24 分・10 g | 約 1 時間 55 分・11 g（推定） |
| `3mf/plate1_lid.3mf` | 蓋 A・B、蓋側のヒンジカバー 2 枚、蓋の継ぎ板 2 枚 | 1 時間 45 分・65 g | 約 9 時間 53 分・64.9 g（推定） |
| `3mf/plate2_tray.3mf` | トレイ A・B、トレイ側のヒンジカバー 2 枚、トレイの継ぎ板 1 枚 | 1 時間 32 分・62 g | 約 9 時間 11 分・60.5 g（推定） |
| `3mf/plate3_panel.3mf` | 化粧パネル A・B、パネルの継ぎ板 3 枚 | 38 分・24 g | 約 3 時間 33 分・24.3 g（推定） |
| 合計（plate 1〜3） | | 3 時間 54 分・151 g | 約 22 時間 40 分・149 g（推定） |
| `3mf/usb_variants/lid_A_left_usb○○mm.3mf` | メス端子用の蓋 A（ねじ間隔 16〜30 mm、ねじなし） | 必要なときだけ | 必要なときだけ |
| `3mf/large/plate1_lid.3mf`〜`plate3_panel.3mf` | **大きいプリンター用**（造形範囲 220 mm 角以上）：蓋・トレイ・化粧パネルを分割せず一体で。貼り合わせ不要 | 合計 3 時間 46 分・150 g | – |
| `3mf/large/usb_variants/lid_usb○○mm.3mf` | 大きいプリンター用の、メス端子用の蓋（一体） | 必要なときだけ | – |

部品は印刷する向きにそろえて 180 × 180 mm のプレートに並べてあります。Bambu Studio で開けば、そのままスライスできます。印刷設定（ノズルごとの設定）は [ASSEMBLY_ja.md](ASSEMBLY_ja.md) の 2 章にあります。0.2 mm ノズルの時間と重さは、作者の A1 mini 向けにその設定で Bambu Studio がスライスした前の版の値に、PrusaSlicer で比べた増え方を掛けた推定、0.4 mm ノズルは PrusaSlicer に A1 mini に近い設定を入れて出した目安です（`out/print_report.md`）。個別の STL は `out/split/`（分割した部品とメス端子用の蓋 A。継ぎ板は `out/split/splice/`）、`out/whole/`（一体の蓋・トレイ・化粧パネルとメス端子用の一体の蓋）、`out/`（カバー、確認用の分割前の蓋・トレイ・化粧パネル、キットの外形）、`out/coupons/`（試し刷り）にあります。

## 色の組み合わせ

完成予想を 3 通り描きました（PLA の黒・カーキの色味はメーカーで違います）。

| 黒だけ | カーキだけ | ミックス（蓋がカーキ、トレイと化粧パネルが黒） |
| --- | --- | --- |
| 黒 | カーキ | ミックス |
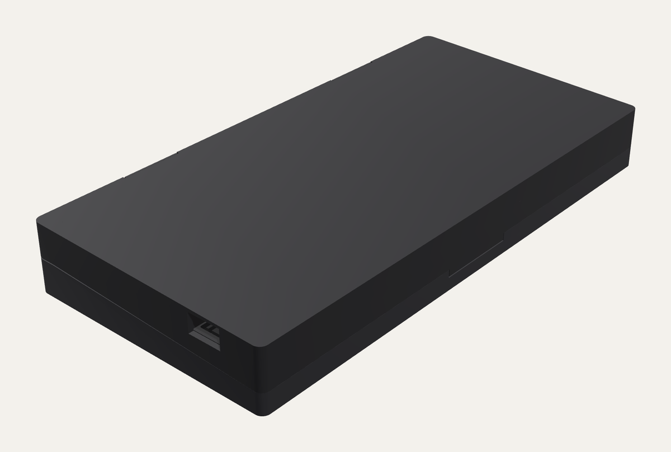
[picture p10: docs/images/render_closed_black.png]
黒・閉じたところ
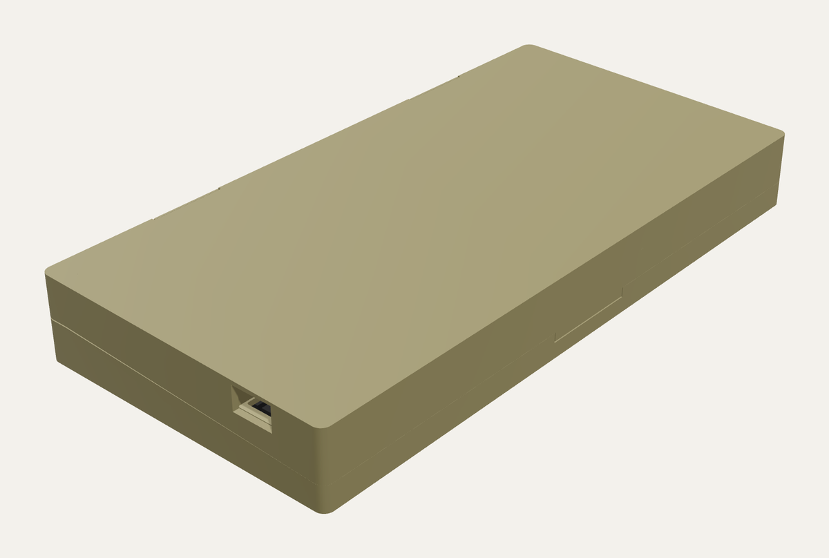
[picture p11: docs/images/render_closed_khaki.png]
カーキ・閉じたところ
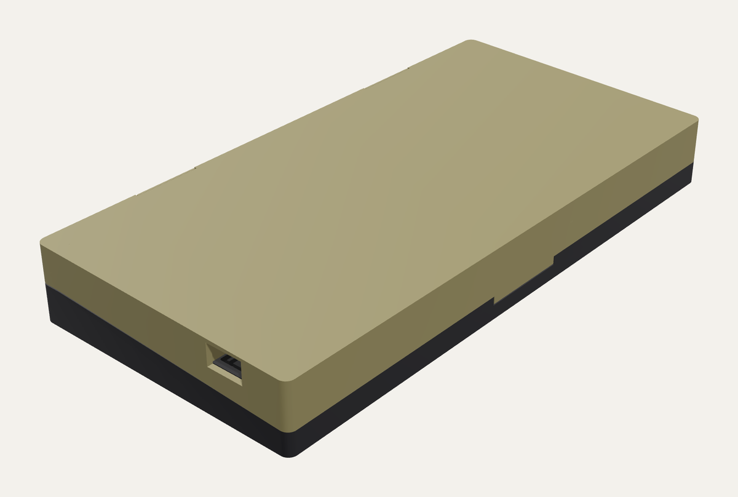
[picture p12: docs/images/render_closed_mix.png]
ミックス・閉じたところ
|  |  |  |

## 蓋と化粧パネル

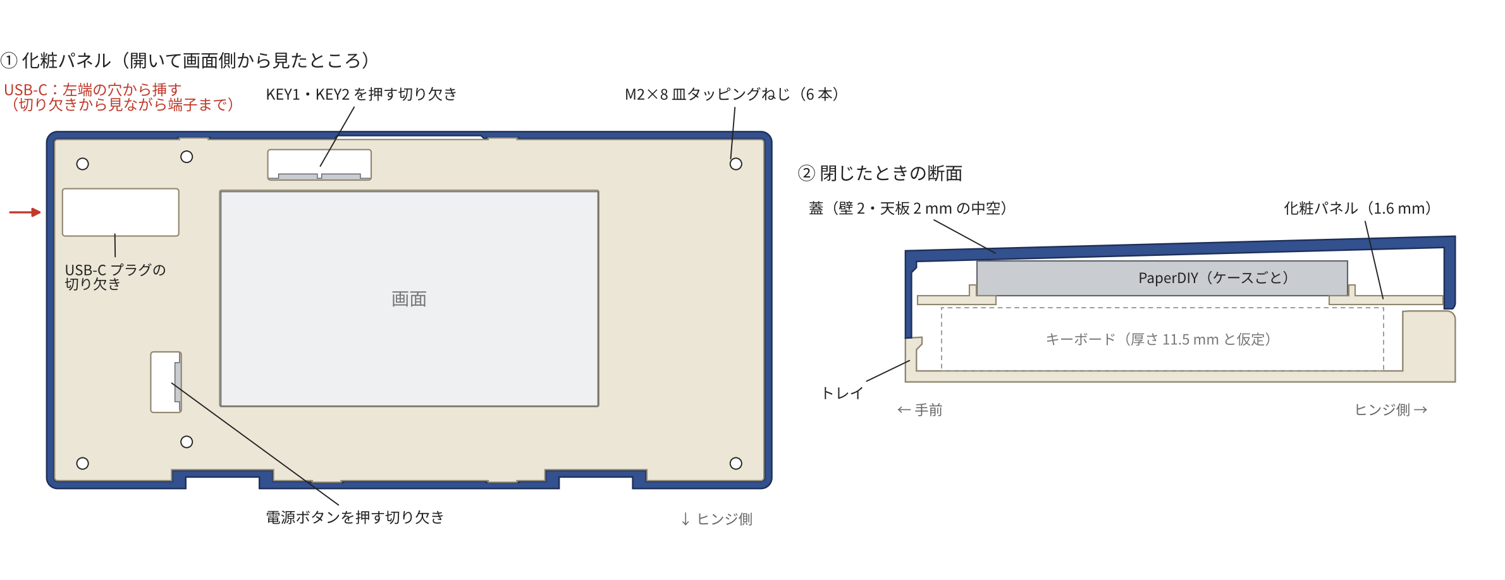
[picture p13: docs/images/kit_mount.png]
PaperDIY と化粧パネル


- **蓋**：壁・天板とも 2.0 mm の中空の殻です。角の丸みは R3、面取りはありません。内側には、ヒンジの座（ねじのボスとリブ）、化粧パネルのねじのボス 6 本（Ø6、まわりにリブ）、キットの裏を受けるリブ 3 本、USB-C プラグのガイド 2 本（幅 1.2 mm）があります。分割版の継ぎ目はまっすぐな突き合わせで、天板の内側に継ぎ板を貼ります
  - **パネルのねじのボスのリブ**：ボスは天板から 6.3〜8.6 mm 下がる柱なので、根元に横から力がかかると（落としたときなど）積層の境目で折れやすくなります。そこで、ボスの前後左右に厚さ 1.2 mm のリブを付けました。近くの壁（5.5 mm 以内）へは天井まで届く板でつなぎ、それ以外は長さ 3 mm の三角のリブです。キットの枠、継ぎ板のくぼみ、USB-C の通り道にはかからないようにし、パネルの裏から 0.5 mm 上で止めてあります。ヒンジのねじのボスは、前から天板・床へのリブでつないであります
- **トレイ**：これも壁・床とも 2.0 mm の殻です（前の版は元のトレイに背面を足したもので、床・壁 3 mm、背面はヒンジの面まで約 10 mm 詰まっていました）。キーボードの入る所は、元のトレイと同じ 196 × 87 mm です。壁から内側に出るものはありません。手前と奥の位置決めリブ 9 本はキーボードに干渉し、いったん戻した左右のリブ（キーボードの端から 0.15 mm。キーボードの幅は 194 mm と推定）は刷ってみるときつかったので、どちらもやめました（`TRAY_KB_RIBS`。キーボードの幅を測れば、すき間を決めて戻せます）。キーボードは前後・左右に片側 1 mm ほど動きます。背面の充電口の開口、留めツメの受け、ヒンジの座もあります
- **デッキ**：キーボードのまわりは、縁と面一の厚さ 1.2 mm の天板（デッキ）でふさいであり、ヒンジのボスや座は見えません。デッキの穴は元のトレイの内側と同じ 196 × 87 mm（手前の角は元と同じ R3）で、CACOE が入ることがわかっている大きさです。手前と左右では幅 1.0 mm で、下は 45° の斜面で壁につながります（サポート不要）。奥の帯（幅 7.5 mm）は床から縁まで中身の詰まった形で、ヒンジのボスと座を中に取り込み、スライサーがインフィルで埋めます。充電口の開口（x 72.9〜89.1）の上だけは開けてあり、プラグやそこにあるかもしれないスイッチに上から手が届きます
- **足はありません**：トレイの底は平らで、そのまま机に置きます（元の作品と同じ）。前の版では底の四隅のくぼみに TPU の足を押し込んでいましたが、1 層目にくぼみができることと、TPU を別に刷ることが、作るときの失敗を招くだけだったのでやめました。印刷は PLA だけです
- **ダンパーはありません**：前の版ではトレイの手前の縁に TPU の小さな板ばねを入れていましたが、やめました。トルクヒンジは手を離すと少し戻るので（下の「ヒンジ」）、閉じた蓋はいつもツメに押し付けられていて、がたつきません。板ばねはその押し上げる力を増やすだけでした
- **化粧パネル**：厚さ 1.6 mm。画面の窓（キットの窓より片側 0.3 mm 大きく、角は直角）、キットのまわりに入る枠（高さ 2.0・幅 1.2 mm、すき間 0.2 mm）、皿穴 6 つ、ボタンと USB-C プラグの切り欠き。PaperDIY はパネルの枠と蓋のリブの間に挟まって動きません
- **キットの位置**：Complete Kit のケース（M5Stack が公開している 3D データで 120.0 × 67.0 × 6.3 mm、角の丸み 3 mm）を画面側を下にして置き、画面の中心が蓋の左右の中央に来る位置です。まわりのすき間は 0.2 mm です
- **ボタン**：KEY1・KEY2 は化粧パネルの上の縁寄り、電源は窓の左に、指が入る切り欠きがあり、キットのボタンキャップを指先で横に押します。切り欠きはキットの縁から 8 mm、ボタンの両端から 3 mm 先まで開けてあります（前の版は 6.5 mm・1.5 mm）。押し棒はありません
- **ボタンのガード**：KEY の切り欠きのまわりには、パネルの裏から PaperDIY の裏の高さまで、厚さ 1.2 mm の壁が立っています（切り欠きから 0.5 mm 離れ、キットの縁で閉じる）。切り欠きから落ちたごみはこの中にとどまり、蓋の中やヒンジのほうへ入りにくくなります。電源の切り欠きは、キットの左端と蓋の端の壁の間の空間（USB-C の通り道があり、パネルの USB-C の切り欠きでもともと外とつながっている）に開いているので壁を立てても効き目が薄く、メス端子の蓋 A ではその場所に端子の本体が来るので、ガードはありません
- **USB-C**：蓋の左端に 13 × 7.6 mm の穴があり、蓋の内側の 2 本のガイド（穴の両脇の壁から PaperDIY の端まで）が、プラグを端子まで案内します。分割版ではガイドも蓋 A と蓋 B の境目で切れていますが、貼り合わせると一直線につながります。化粧パネルはこの通り道の上を切り欠いてあり（幅 13.2 mm、左端から PaperDIY の端まで）、プラグが端子に入るのを見ながら指で押し込めます。まっすぐなプラグ（根元 12 × 6.5 mm まで）なら挿したまま閉じられます
- **メス端子に替える**：蓋 A をメス端子用（`usb_variants/`）に替えると、左端の奥寄り（y = 20）に 13 × 7 mm の開口と M3 のねじ穴が開きます。ねじ間隔は 16・18・20・22・25・28・30 mm とねじなし（接着）。ねじ耳と本体が化粧パネルと天板の間に収まる高さ 7.2 mm までの端子が入ります。延長ケーブルのオス側は、化粧パネルの切り欠きから PaperDIY の端子に抜き差しできます。蓋 B・化粧パネル・ほかの部品は同じです
- **高さ**：化粧パネルの面はキーボードの上 0.5 mm の高さです。天面は、背面でヒンジの板とカバーが収まる高さと、キットの手前の縁の上に天板 2.0 mm が残る高さを通る平面にしてあり、手前ほど低くなります。蓋の厚さは手前 15.8 mm・奥 13.4 mm です
- **キーボードの高さ**：いまのデータは、元の蓋と同じく、キーボードの厚さ 11.5 mm（キートップまで）を想定しています。測った値を `src/params.py` の `KB_THICK` に入れて作り直すと、蓋がそのぶん低くなります

## 留めツメ

- **ヒンジ側の逃がし**（`PART_RELIEF`）：実機で「ヒンジのねじを締めると蓋が開き、緩く締めていると閉じたまま」と分かりました。ヒンジの軸は合わせ目の面の上、背面から 0.15 mm のところにあり、蓋とトレイの縁は軸から 1.65 mm のところで当たっていました。蓋の手前の縁はその 60 倍遠いので、奥の縁が 0.05 mm 盛り上がっているだけで（印刷の上面はそのくらい盛り上がります）、ねじを締めてヒンジの板が座に引き寄せられたとたん、手前が 3 mm 開きます。ねじが緩いと、板が穴の中で逃げて蓋の奥が浮くので、閉じたままになります。そこで蓋の下面を、手前から 6.5 mm のところ（y −40）から背面に向かって、背面で 0.4 mm になるよう斜めに削りました（真ん中で 0.16 mm）。蓋は手前の縁で着地し、ヒンジのそばの縁は当たりません。変わるのは蓋だけです。これまで「ヒンジの戻りで蓋が浮く」と説明してきた分のうち、どれだけがこれだったのかは分かっていません（大半だった可能性があります。その場合、ツメは 1.3 N よりずっと大きな力を受けていたことになります）。この版はまだ刷っていません
- **ツメの役目**：トルクヒンジは摩擦で止めるフリーストップ型で、手を離すと少し戻ります。途中の角度なら少し先まで押せば済みますが、閉じ位置では蓋がトレイに当たって先へ行けないので、戻った分だけ蓋の手前が浮きます（軸で 1° 戻ると手前で 1.7 mm）。この浮きを押さえるのがツメです。押し上げる力は手前の縁で 0.5〜1.3 N です（ヒンジ 2 個のトルク ±25 % から蓋の重さの分を引いた値。`out/print_report.md` の「Does the lid stay shut?」）
- 蓋の手前の壁の真ん中に、**幅 30 mm**・厚さ 1.0 mm のツメがあり、合わせ目から 2.6 mm 下まで伸びています。トレイの手前の面には、ツメが収まるくぼみと溝があります
- **切れ目はありません**。ツメの両脇に切れ目を入れて壁から切り離す形は、切れ目の上端にひずみが集まり、そこが積層の境目と重なるので（蓋は天板を下にして刷る）、そこから折れます。代わりに、ツメのまわりの壁（x −20〜20 mm、天板の 2 mm 下まで）を内側から 1.1 mm に薄くし、この帯全体が板として外へわずかにたわむようにしました。帯の端は 45° の斜面で 2.0 mm の壁に戻り（刷るときは上向きの面なのでサポート不要）、外からは見えません
- ツメの内側の出っ張り（0.45 mm、合わせ目から 1.4 mm 下）が、閉じるときにくぼみの面を押して壁を外へたわませ、溝に落ちてパチンと留まります。出っ張りの面は、閉じる向きに対して、閉じる側が 44°、掛かりの側が 49° です（パラメータの `close_deg`・`open_deg` は 30°・35° ですが、これは斜面の長さを決める値で、出っ張りの形をツメの中 0.3 mm から描いているぶん、面そのものは急になっています。`build.py` の `latch_flanks`）。溝の上にはトレイの壁が 0.6 mm 残ります
- **掛かり**（出っ張りがトレイの縁に重なる深さ）は、蓋が図面どおりの位置にあるとき、図面の数字で 0.40 mm（出っ張り 0.45 − ツメとくぼみのすき間 0.05）、出来上がった形で 0.37 mm です。蓋が 0.1 mm 手前にあるごとに、0.1 mm 減ります
- `src/latch_plate.py` で、蓋の前の壁を板（キルヒホッフ板、scikit-fem）として解いています。結果は次のとおりです
  - 出っ張りの位置で 24.9 N/mm
  - ひずみは帯全体に散って最大 0.41 %（積層をまたいで曲がる部品の目安は 0.5 %。壁が出っ張りの分 0.45 mm いっぱいたわんでも 0.46 %）。ひずみは掛かりの深さで決まり、幅を広げても増えません
  - ツメを外へ約 17 N で引くと、PLA の積層をまたぐ強さ（約 25 MPa）に届く
  - 帯を薄くしない 2.0 mm の壁のままだと、約 4 倍固くなって開け閉めできない
- この計算は天板と左右の壁を動かないものとして解いているので、実物は少し柔らかめです。前の版で「計算は実物の 2〜5 倍に出る」と書いたのは、掛かっていなかったツメの結果から推したもので、**取り消します**
- **閉じるところをシミュレーションしています**（`tools/snap_sim.py`、`make sim`。全部の結果は `out/snap_sim.md`）。出来上がった蓋とトレイの STL をツメの真ん中で切った断面にして、蓋をヒンジの軸まわりの軌道で下ろします。ツメはばね（上の板の計算）、斜面には摩擦 0.3。閉じたあと、ヒンジの戻り（0.5〜1.3 N）で手前を持ち上げて、留まるかを見ます。蓋が図面の位置から前後にずれている・自由に動く・押すとたわむ、を条件として変えます。力は手前の縁での値です

  | 蓋の前後の位置 | 閉じる力 | 留める力 | |
  | --- | --- | --- | --- |
  | 図面どおり | 13 N | 17 N | ツメは 0.36 mm たわむ |
  | 0.1 mm 手前 | 9 N | 12 N | |
  | 0.2 mm 手前 | 4 N | 7 N | |
  | 0.3 mm 手前 | 1 N | 2.6 N | 持つと開く |
  | 0.4 mm 手前 | − | 0 | 出っ張りが溝に届かない。カチッと言わない |
  | 0.1 mm 奥 | 18 N | 22 N | ひずみ 0.47 % |
  | 0.2 mm 奥 | 23 N | 27 N | 閉めにくい。ひずみ 0.57 % |
  | 前後に ±0.2 ／ ±0.3 mm 自由に動く | 4 ／ 1 N | 7 ／ 2.6 N | 斜面が蓋を、動けるだけ手前へ押す |
  | 図面どおりの位置で、ツメのすき間が 0.10 mm 広い／狭い | 9 ／ 18 N | 12 ／ 22 N | |

  留めツメのシミュレーション

  - つまりこのツメは、蓋が図面の位置から −0.2〜+0.1 mm にあれば留まります。実物の蓋がどこに付いていてどのくらい動くかは計算の入力で、結果ではありません。閉じた蓋の手前の面がトレイの面より 0.2 mm 以上出ているなら、その段差を測って、その分だけツメの位置を動かします
  - この計算で蓋を押し上げているのは、ヒンジの戻りだけです。ヒンジのそばで縁が当たって蓋がこじ開けられる場合（上の「ヒンジ側の逃がし」）は、力がずっと大きく、この計算の外です。これまでに刷ったツメ（幅 12 mm、30 mm）が留まらなかったのは、これが相手だった可能性が高いと見ています
  - 以前ここに書いていた「閉じる力 約 7.9 N、留まる力 約 9.5 N」は、面の角度を 30°・35° として計算した値でした。出来上がった形の面は 44°・49° なので、力は上の表のとおり大きくなります。形は変えていません（これまでに刷った版も同じ面です）
- **ストッパーはやめました**：一度、ツメの両脇に蓋の内側の舌を 2 本足して、トレイの壁の内側に当てて蓋が手前へずれないようにしました（刷る前にやめた版です）。やめた理由は 3 つです。蓋が開く原因はヒンジ側の当たりのほうがありそうなこと。蓋が 0.3 mm より手前に動かずに付いている場合、舌がトレイの壁に乗り上げて閉まらなくなること（シミュレーションで 29〜44 N）。それと、ツメと同じ場所には置けないこと（中央ではトレイの壁がツメの受けで内側いっぱいまで厚く、蓋の壁もツメと一緒にたわむ部分なので）。コードは残してあります（`LATCH["stop"]`）
- **試し刷りで確かめられます**：plate 0 の留めツメの小片は、薄い帯を丸ごと含む幅 45 mm で切り出してあります。蓋側をトレイ側にかぶせて押し下げ、カチッと掛かるか、引き上げて外れるかを、蓋とトレイを刷る前に確かめます。固すぎるときは、ツメの内側の出っ張りの上側の斜面を少し削るか、`LATCH["bump"]` を下げます
- **指掛かりはありません**：開けるときは、手前の合わせ目に指先を掛けて蓋を持ち上げます（シミュレーションでは、蓋が図面どおりの位置なら約 18 N、手前に寄っていればそれ以下：ツメ＋ヒンジの固さ−蓋の重さ）。本体（トレイとキーボード）はこの力より軽いので、もう片方の手で本体を押さえます
- トレイの手前の壁は、ツメの受けのところだけ厚くしてあり、くぼみの裏で 1.95 mm、溝の裏で 1.5 mm 残ります

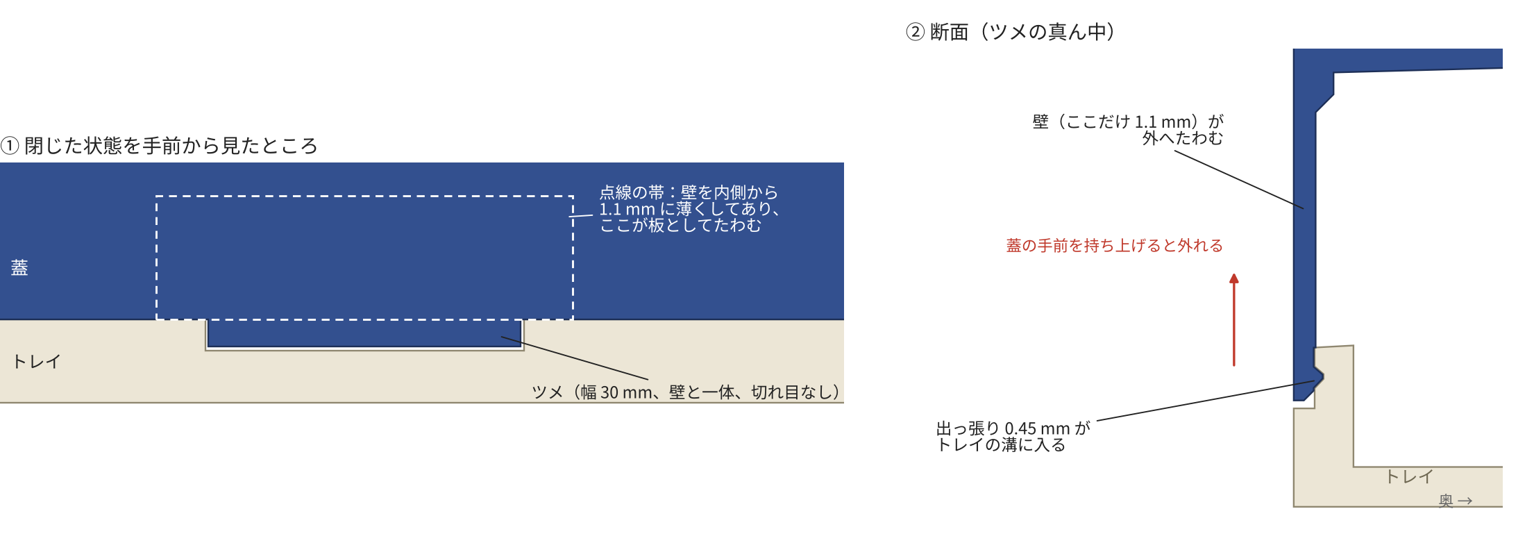
[picture p14: docs/images/latch.png]
留めツメ


## ヒンジ

- **部品**：スガツネの [ミニフラットトルクヒンジ HG-MF08](https://search.sugatsune.co.jp/product/g/gHG-MF/) を 2 個。20 × 25 × 2.0 mm、トルクは 1 個 0.0784 N·m（±25%）のフリーストップ型です
- **トルクの見積もり**：蓋の側（PaperDIY Complete Kit・化粧パネル・カバー込みで約 138 g）を水平にしたときのモーメントは約 0.07 N·m です。2 個で 0.157 N·m なので、どの角度でも止まります（逆に言うと、蓋は自分の重さでは閉じません）
- **戻り（スプリングバック）**：摩擦で止めるヒンジは、手を離すと少し戻ります（樹脂のヒンジと取り付け部にたまったねじれが戻る）。途中の角度では少し先まで押せば済みますが、閉じ位置では蓋がトレイに当たって先へ行けないので、ツメが掛かっていない蓋は手前が少し浮きます（1° で 1.7 mm）。これを押さえるのが留めツメです。カタログの最大開き角は 260° なので、閉じ位置でヒンジが突き当たっているわけではありません
- **取り付け**：軸は背面の下端（蓋とトレイの合わせ目）にあり、板は背面の溝にはまります。溝はヒンジより片側 0.25 mm 大きくしてあります。前の版は奥行き 9.5 mm の詰まったブロックで受けていましたが、いまは溝のまわりに 2.0 mm の壁を回した座と、ねじ穴ごとのボス（Ø5.0 mm、ねじ先から 1.5 mm 先まで）と、それを天板・床につなぐリブで受けています。羽根を広げた幅が 25 mm あるので、閉じた全体の背の高さは 26 mm より低くできません（いまは 26.4 mm）
- **開いたときのすき間**：背面の壁は**全幅で**ヒンジの板と同じ面にそろえてあり、縁は軸から 0.15 mm なので、開いても継ぎ目は 1〜1.5 mm です（90° で 1.45 mm、150° で 0.96 mm）
- **合わせ目の丸み**：蓋の背面の下の縁と、トレイの背面の上の縁（ヒンジの軸に沿った縁）は R1.5 で丸めてあります。軸が背面の 0.15 mm 外しかないので、実物の軸が少し低いと角同士がこすれます。丸みがあれば、軸が 0.3 mm 低くても蓋とトレイが当たるのは 170° からです（机の上の限界 162° より先）
- **カバー**：厚さ 1 mm のカバーを背面のくぼみにはめ、背面と面一にします。くぼみはカバーより片側 0.25 mm 大きく（0.15 mm では刷ってみてきつすぎました）、カバーの縁の小さな突起（つぶしリブ、片側 2 本）がそのすき間を 0.1 mm だけ押して、押し込むだけでも留まります。カバーは外の面を下にして刷るので、外の面の縁は 0.3 mm 面取りして、1 層目の広がり（エレファントフット）がくぼみに引っかからないようにしてあります。カバーには M2 の皿穴が 2 つあり、裏にはそれぞれヒンジの板の皿穴にはまる円すいが付いています。ヒンジの M2×8 は、カバーの皿穴からヒンジの板を通ってケースに入るので、カバーとヒンジを一緒に留められます（接着剤は使いません）。そのぶんヒンジの板は 1 mm 深く沈めてあり、軸は背面の 0.15 mm 外です。外から見えるのは筒とねじの頭だけです
- **開く角度**：机の上では約 162° で蓋が机に当たり、そこが限界です。0〜180° のどこまで回しても部品同士は当たりません。ヒンジの軸の高さは公表値がないのでメーカーの 3D データから読んでいます

## キーボードの充電口

元のトレイには、背面の壁に CACOE の充電口用と思われる開口があり、新しいトレイにも同じ位置（床から 3 mm 上から）に開けてあり、デッキもその上は開けてあります。プラグの条件は元の作品と同じです（根元の太い部分が幅 16 mm × 高さ 6.8 mm 以内）。充電ケーブルを挿したままだと、**蓋は 95° までしか開きません**（背面を全幅でヒンジの面にそろえたため）。

## 倒れやすさ

CACOE キーボードが **83 g 以上**なら、机に当たる約 162° まで開いても倒れません（前の設計は 156 g）。詳しくは [ASSEMBLY_ja.md](ASSEMBLY_ja.md) の 4 章。

## データの作り直し

リポジトリのルートで：

```bash
make setup     # Python のパッケージ（バージョン固定、cad/requirements.txt）
make verify    # 元データを固定のコミットで取得 → STL・3MF を作り直し → コミット済みのものと比べる
make report    # （PrusaSlicer があれば）印刷時間・重さ・警告・壁の厚さ・倒れやすさ → out/print_report.md
make sim       # 留めツメを閉じるところのシミュレーション → out/snap_sim.md
make render    # 完成予想図（docs/images/render_*.png、色違いも）
```

- **元データの固定**：元のリポジトリはコミット `a21bfd6` に固定し、使う STL の SHA-256 を `src/params.py` に書いてあります。違うものを読もうとするとビルドが止まります（`tools/fetch_original.sh` が正しいものを取ってきます）
- **同じものが出る**：同じ PC なら、STL も 3MF も 1 バイトも違わないファイルができます。別の PC では計算の最後の桁の丸めでバイトが変わるファイルがありますが、形は一致します。`out/MANIFEST.json` に全ファイルの SHA-256 と体積・寸法を記録してあり、`make verify` はバイトが同じか、形が 0.01 mm / 0.01 % 以内で同じかを確かめます
- **CI**：GitHub Actions（`.github/workflows/build.yml`）で、push のたびに同じ確認をします

寸法と作り方の切り替えはすべて `src/params.py` にあります。キーボードの厚さは `KB_THICK`、幅と奥行きの推定は `KB_SIZE`（レンダリングと報告用。トレイの空間は `KB_FACE_X`・`KB_FACE_Y`）、トレイのデッキは `TRAY_DECK`、壁の厚さは `WALL`、角の丸みは `CORNER_R`、留めツメは `LATCH`、蓋の殻は `SHELL_*`、継ぎ板は `SPLICE`、化粧パネルは `PANEL_*`、キットの寸法は `KIT_*`、メス端子の位置は `USB_PM_Y_KIT` です。`KIT_LID = "solid"`（または環境変数 `KIT_LID=solid`）にすると、中まで詰まった蓋のくぼみに PaperDIY をはめて天面から M2×4 のねじ 1 本で留める版（化粧パネルなし）、`PD_MOUNT = "bare"`（または環境変数 `PD_MOUNT=bare`）にすると前の設計（Assembly Kit の基板を画面パネルに載せ、2000 mAh の電池を入れる版。説明は英語の [README_bare.md](README_bare.md)）を作れます。この 2 つの別の作り方が今も作れることは、`make variants` と CI で確かめています。形を変えたら `make manifest` で記録を更新します。

## ライセンス

筐体の 3D データ（`out/`、`3mf/`、`renders/`）と、それを描いた画像（`../docs/images/`）は、元データ「The PDA Terminal / phone-enclosure」（Un Kyu Lee、[CC BY-NC 4.0](https://creativecommons.org/licenses/by-nc/4.0/)）の改変物なので、**CC BY-NC 4.0（非営利のみ）** です（[LICENSE.md](LICENSE.md)）。変更点は `README.md` の「Changes vs. the original」に書いてあります。データを作るスクリプト（`src/`、`tools/`）と文書は、リポジトリ全体と同じ [MIT ライセンス](../LICENSE) です。PaperDIY の寸法は M5Stack が公開している図面と構造データ（[M5_Hardware](https://github.com/m5stack/M5_Hardware) の K159-B）によります。
