tsuyoshi-otake/paperdiy-pda-terminal/cad/renders/display_lid_inside.png

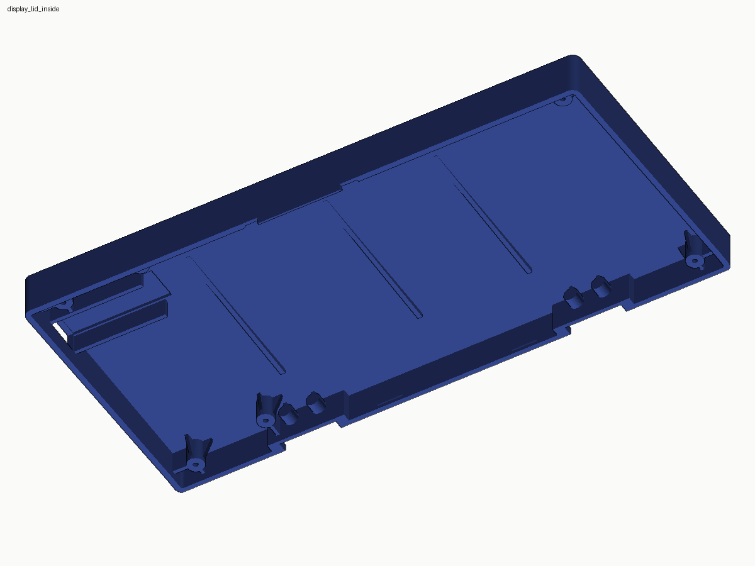
cad/renders/display_lid_inside.png
