tsuyoshi-otake/paperdiy-pda-terminal/cad/renders/display_lid_outside.png

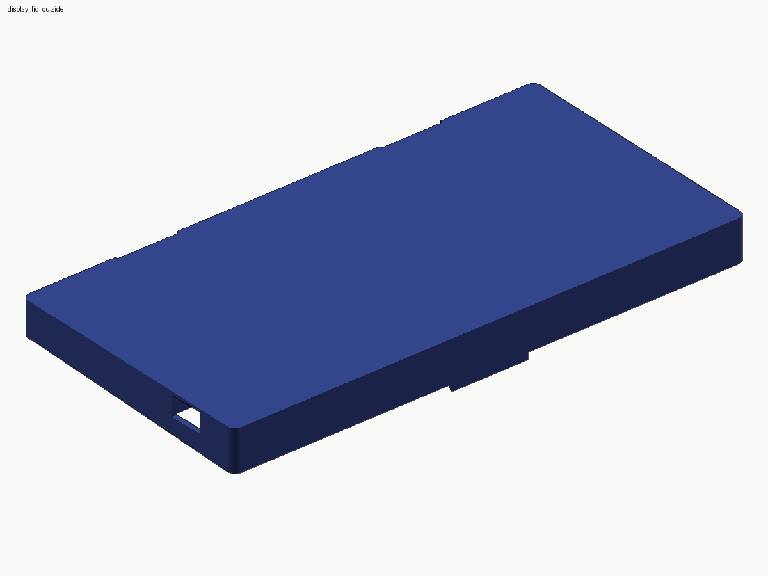
cad/renders/display_lid_outside.png
