tsuyoshi-otake/paperdiy-pda-terminal/cad/renders/display_lid_with_kit.png

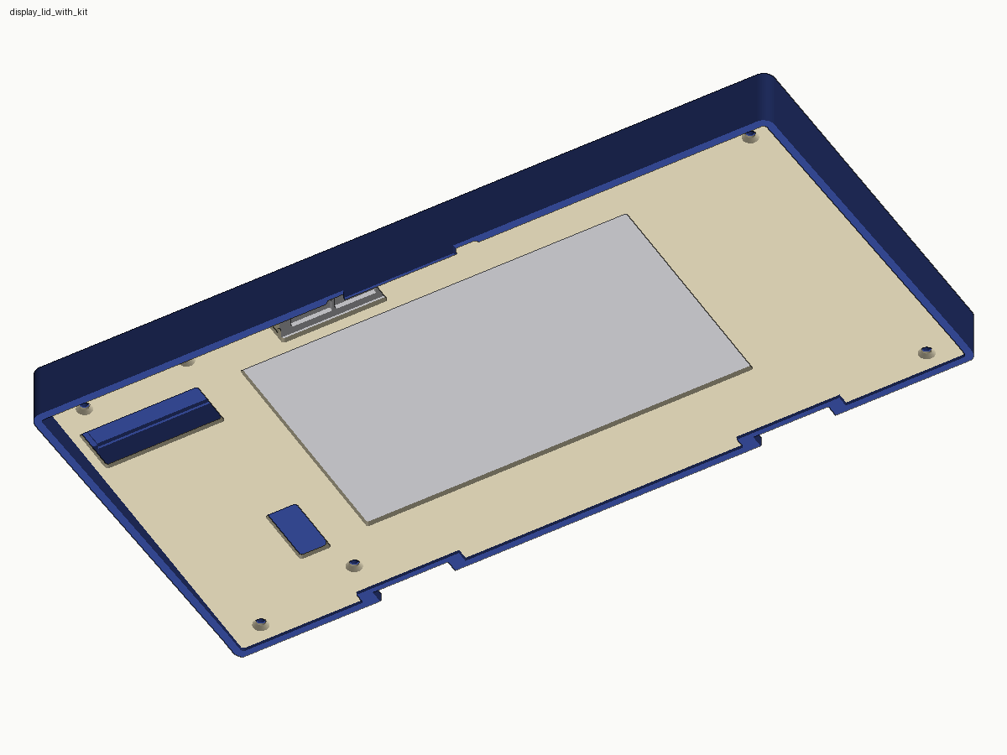
cad/renders/display_lid_with_kit.png
