tsuyoshi-otake/paperdiy-pda-terminal/cad/renders/display_panel_kit_back.png

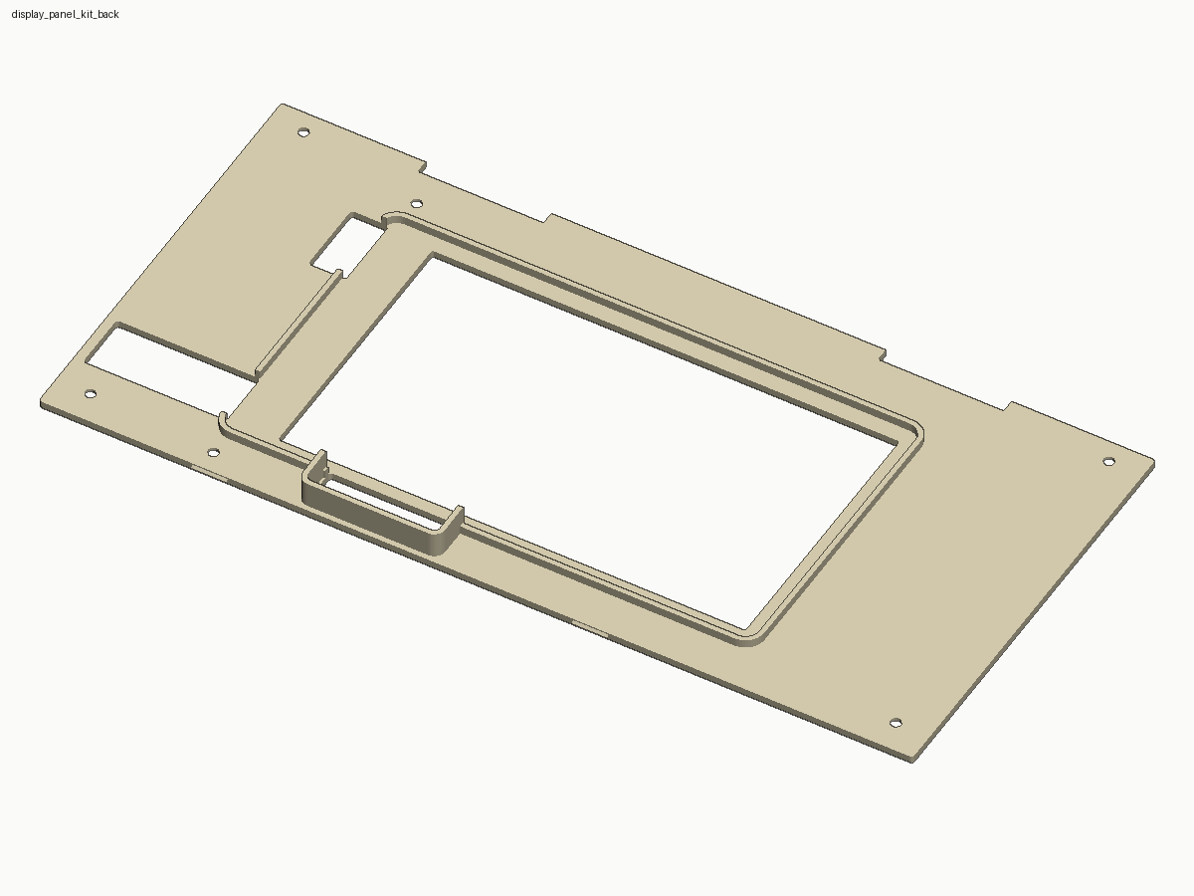
cad/renders/display_panel_kit_back.png
