tsuyoshi-otake/paperdiy-pda-terminal/cad/renders/keyboard_tray.png

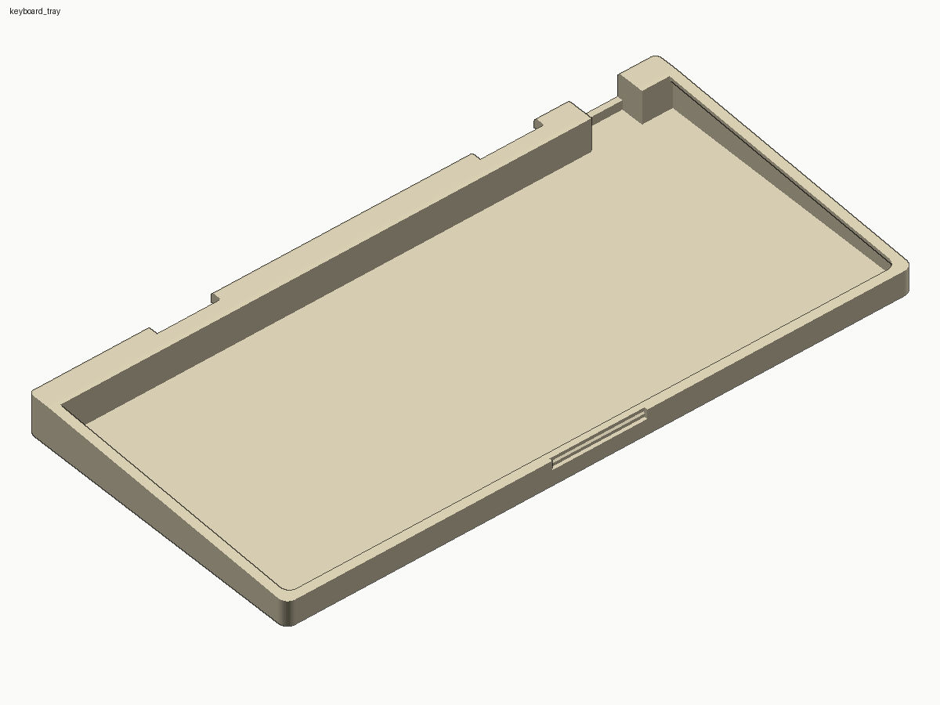
cad/renders/keyboard_tray.png
