tsuyoshi-otake/paperdiy-pda-terminal/cad/renders/split_lid.png

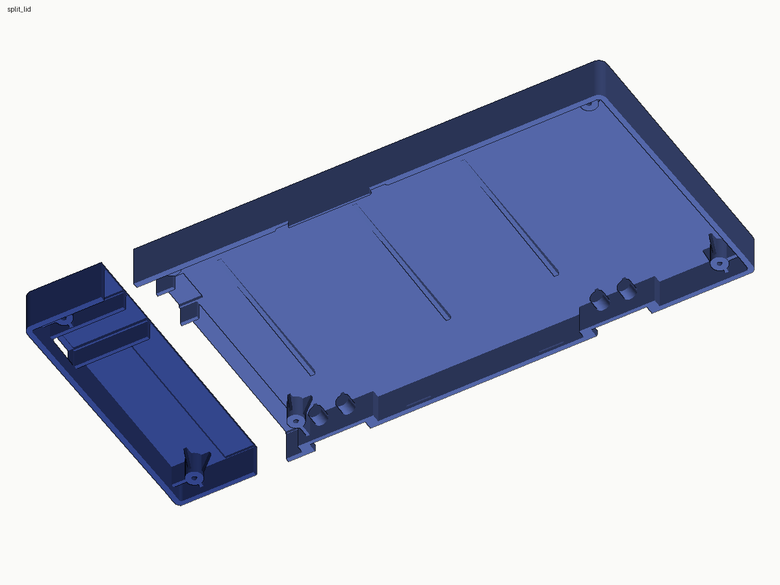
cad/renders/split_lid.png
