tsuyoshi-otake/paperdiy-pda-terminal/cad/renders/split_tray.png

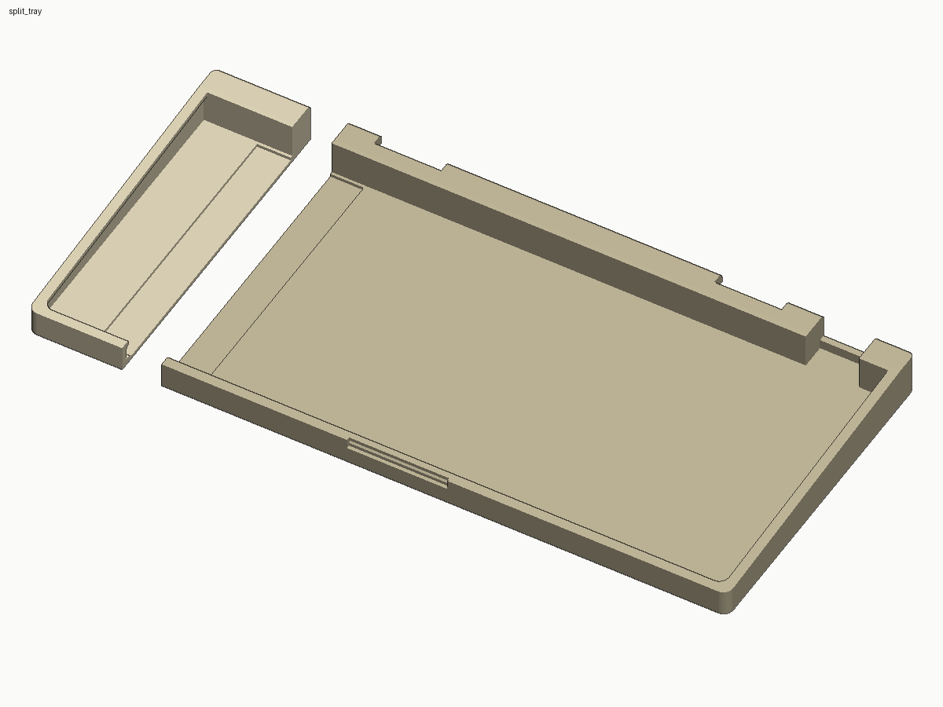
cad/renders/split_tray.png
