tsuyoshi-otake/paperdiy-pda-terminal/docs/images/render_diag.png

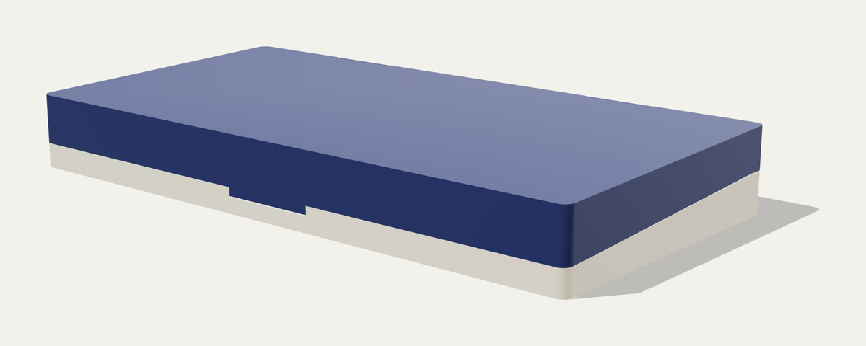
docs/images/render_diag.png
