tsuyoshi-otake/paperdiy-pda-terminal/docs/images/render_end.png

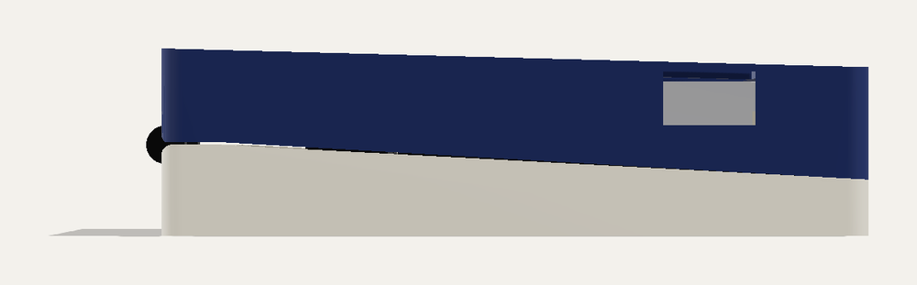
docs/images/render_end.png
