tsuyoshi-otake/paperdiy-pda-terminal/docs/images/render_front.png

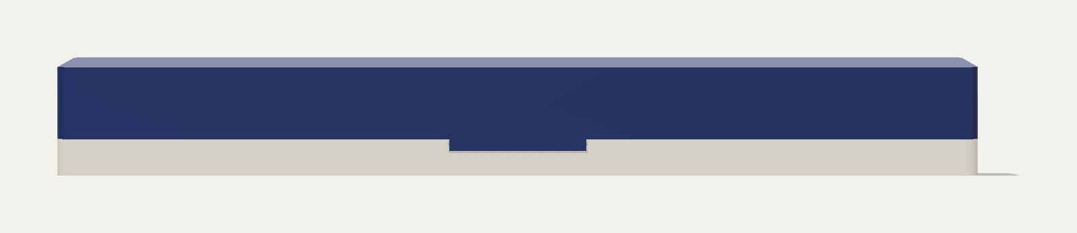
docs/images/render_front.png
