tsuyoshi-otake/paperdiy-pda-terminal/docs/images/render_side.png

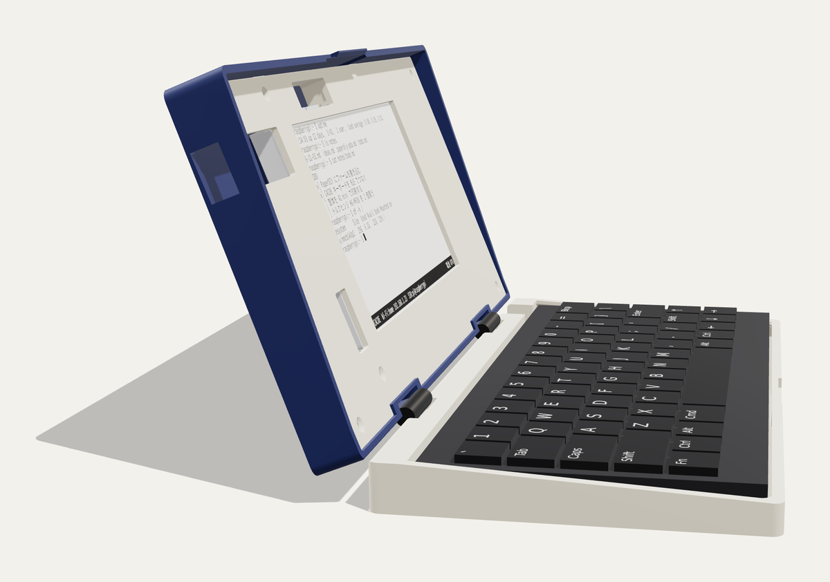
docs/images/render_side.png
