tsuyoshi-otake/paperdiy-pda-terminal/cad/bom.csv

番号 | 部品 | 数量 | 種類 | ファイル / 型番 | 色・仕様 | 使う場所・注意
1 | 蓋 A・B | 1 組 | 印刷 | 3mf/plate1_lid.3mf（蓋 A はメス端子用に 3mf/usb_variants/ から選べる） | 黒 または カーキ PLA | 天面を下にして印刷（傾きは 3MF で直してある）。突き合わせて継ぎ板で接着
2 | 化粧パネル A・B | 1 組 | 印刷 | 3mf/plate3_panel.3mf | 黒 または カーキ PLA | 見える面を下にして印刷。突き合わせて継ぎ板で接着。PaperDIY を画面側から押さえる。押し込むと縁の突起 4 か所で蓋に留まり、ねじ 6 本で固定
3 | M5Stack PaperDIY Complete Kit | 1 | 購入 | K159-B | 43.1 g（ケース・140 mAh 電池込み） | ケースに入れたまま蓋に入れ、化粧パネルで押さえる
4 | トルクヒンジ | 2 | 購入 | スガツネ HG-MF08（-WT / -BL） | 0.0784 N·m | 背面の溝に入れる
5 | ヒンジカバー | 4（蓋側 2、トレイ側 2） | 印刷 | plate1（蓋側）/ plate2（トレイ側） | ケースと同じ色 | 背面のくぼみに押し込むと側面のリブで留まり、ヒンジの M2×8 で共締め（接着しない）
6 | CACOE キーボード | 1 | 購入 | BLE の HID キーボードであること | 重さと寸法を測る | 83 g 以上なら蓋をどこまで開いても倒れない。厚さで蓋の高さが決まる（KB_THICK）。トレイは元の作品と同じ 196 × 87 mm の空間（出っ張りなし）なので、幅・奥行きは測らなくても入る
7 | トレイ A・B | 1 組 | 印刷 | 3mf/plate2_tray.3mf | 黒 または カーキ PLA | 底を下にして印刷。突き合わせて継ぎ板で接着。キーボードのまわりは縁と面一のデッキでふさいである。キーボードの入る所は 196 × 87 mm で、位置決めのリブはない
8 | M2×8 皿タッピングねじ（樹脂用） | 14 | 購入 | 十字穴付き、1 種または B タイト |  | ヒンジ 8（カバーごと）、化粧パネル 6
9 | USB-C ケーブル | 1 | 手持ち | まっすぐなプラグ、根元 12 × 6.5 mm 以内 |  | 蓋の左端の穴から PaperDIY に挿す
10 | USB-C パネルマウント延長ケーブル | 1 | 任意 | オス－メス、ねじ耳 M3（間隔 16〜30 mm）またはねじなし | ねじ耳と本体の高さ 8.2 mm まで | あとから左端をメス端子にするとき。蓋 A を usb_variants/ のものに替える
11 | 接着剤 | 少し | 購入 | ゼリー状瞬間接着剤またはエポキシ |  | 継ぎ目と継ぎ板（分割版だけ）
12 | 両面テープ | 少し | 任意 | はがせる薄いもの |  | キーボードがトレイの中で動くのが気になるとき（キーボードの裏に貼って床に留める）
13 | 試し刷り部品 | 1 式 | 印刷 | 3mf/plate0_test_coupons.3mf | 何色でも | 本番の前に刷ってはめあいと留めツメの固さを確かめる
14 | 継ぎ板 | 6（蓋 2、トレイ 1、化粧パネル 3） | 印刷 | plate1（蓋）/ plate2（トレイ）/ plate3（化粧パネル）、STL は out/split/splice/ | 何色でも（隠れる） | 分割版だけ。継ぎ目をまたいで見えない側のくぼみに接着し、面一になる
