tsuyoshi-otake/paperdiy-pda-terminal/cad/out/split/tray_B_main.stl

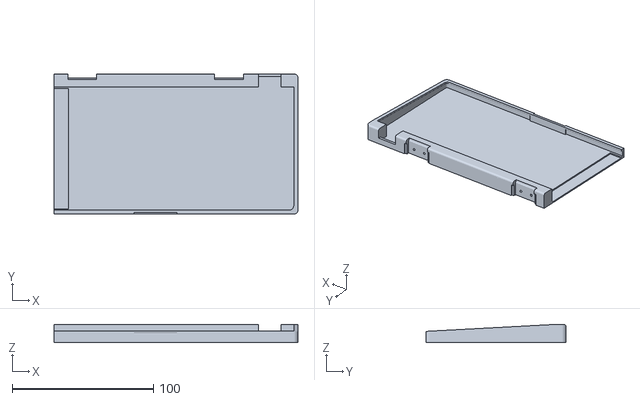
[picture p27: CAD file, 2026-11-11]
cad/out/split/tray_B_main.stl
173.0 x 99.5 x 12.9
