tsuyoshi-otake/paperdiy-pda-terminal/cad/out/split/panel_B_main.stl

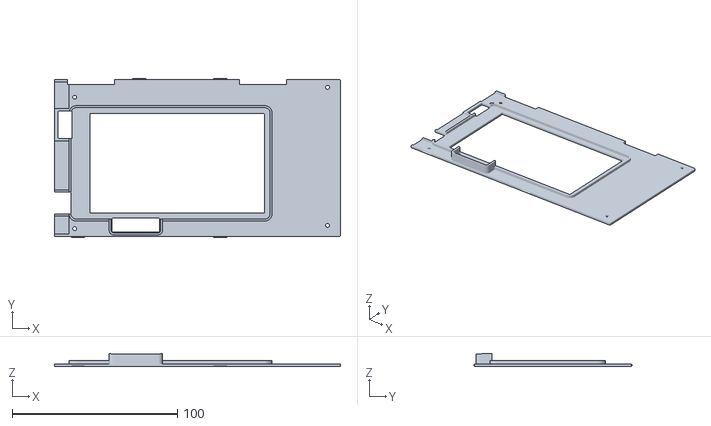
[picture p28: CAD file, 2026-11-09]
cad/out/split/panel_B_main.stl
173.0 x 96.0 x 7.90
