tsuyoshi-otake/paperdiy-pda-terminal/cad/3mf/bambu_a1mini/bambu_plate1_lid.3mf

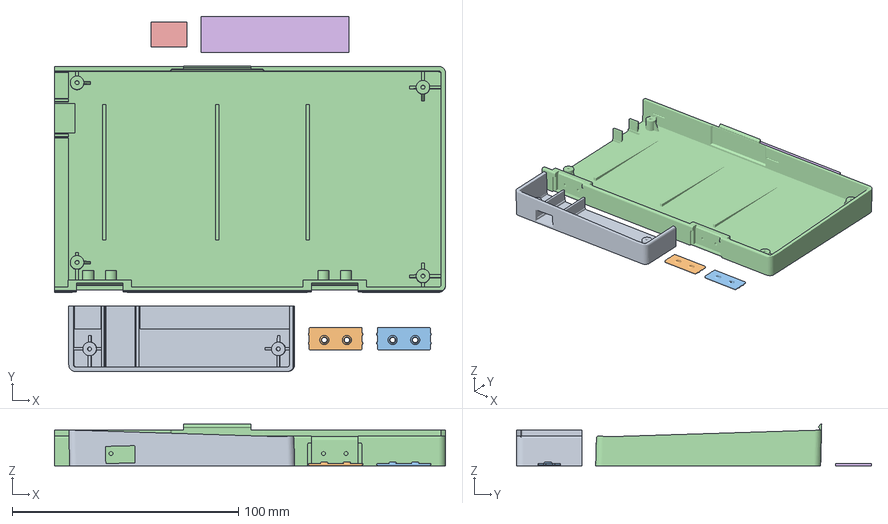
[picture p29: CAD file, 2026-11-11]
cad/3mf/bambu_a1mini/bambu_plate1_lid.3mf
173.0 x 157.0 x 18.4 mm
lid_A_left
hinge_cover_lid_1
hinge_cover_lid_2
lid_B_main
lid_splice_1
lid_splice_2
