tsuyoshi-otake/paperdiy-pda-terminal/cad/3mf/large/plate1_lid.3mf

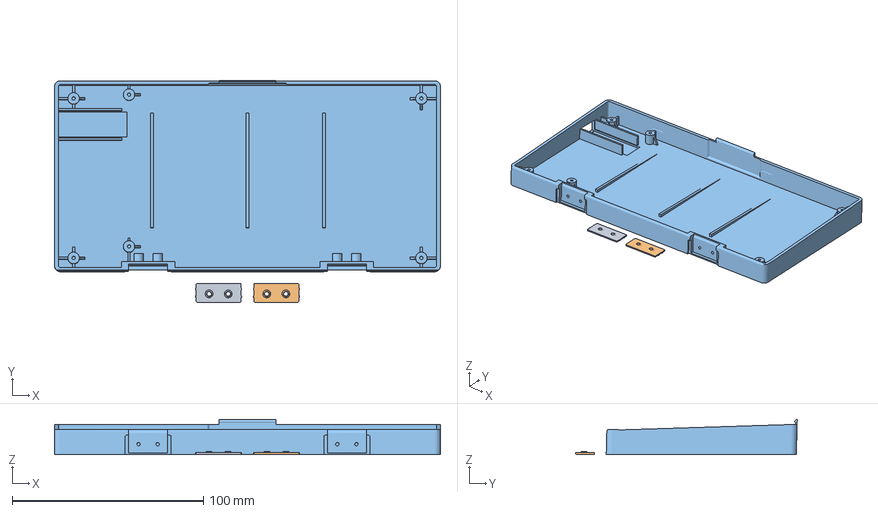
[picture p30: CAD file, 2026-11-11]
cad/3mf/large/plate1_lid.3mf
202.0 x 116.0 x 18.4 mm
hinge_cover_lid_1
hinge_cover_lid_2
lid
