tsuyoshi-otake/paperdiy-pda-terminal/cad/3mf/large/usb_variants/lid_usb18mm.3mf

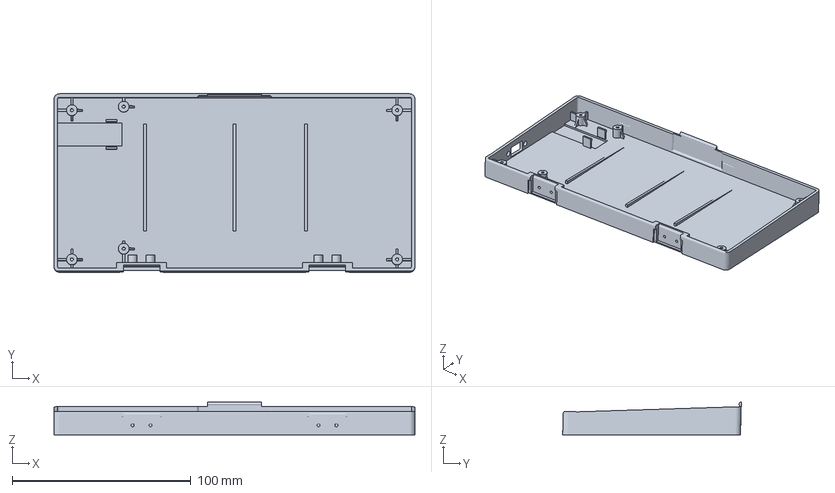
[picture p31: CAD file, 2026-11-11]
cad/3mf/large/usb_variants/lid_usb18mm.3mf
202.0 x 100.0 x 18.4 mm
