tsuyoshi-otake/paperdiy-pda-terminal/cad/3mf/plate2_tray.3mf

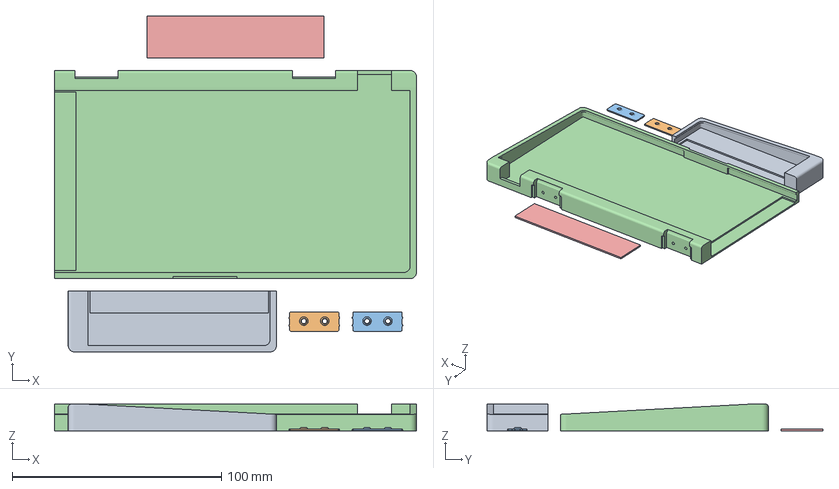
[picture p32: CAD file, 2026-11-11]
cad/3mf/plate2_tray.3mf
173.0 x 160.5 x 12.8 mm
tray_A_left
hinge_cover_tray_1
hinge_cover_tray_2
tray_B_main
tray_splice_1
