tsuyoshi-otake/paperdiy-pda-terminal/cad/3mf/usb_variants/lid_A_left_usb30mm.3mf

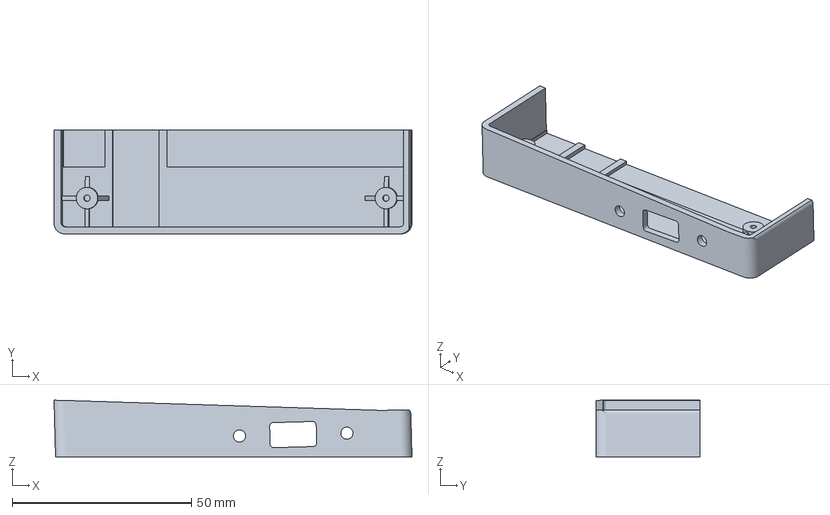
[picture p33: CAD file, 2026-11-11]
cad/3mf/usb_variants/lid_A_left_usb30mm.3mf
100.0 x 29.0 x 15.8 mm
