tsuyoshi-otake/paperdiy-pda-terminal/cad/out/coupons/coupon_latch_lid.stl

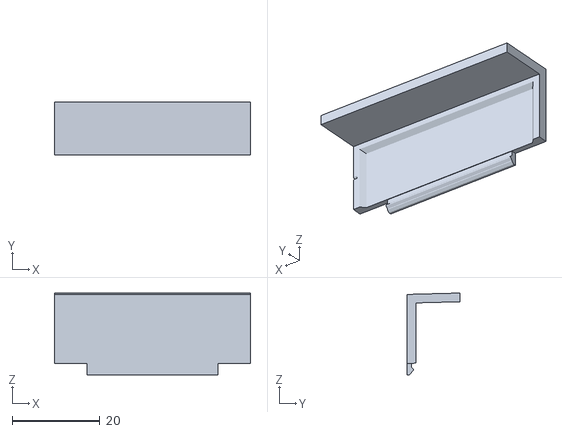
[picture p34: CAD file, 2026-11-11]
cad/out/coupons/coupon_latch_lid.stl
44.8 x 12.0 x 18.7
