tsuyoshi-otake/paperdiy-pda-terminal/cad/out/display_lid_usbc.stl

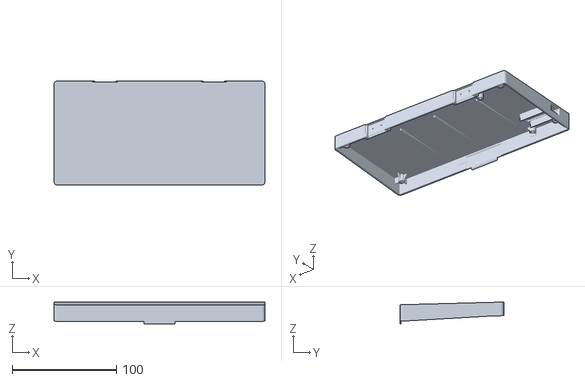
[picture p35: CAD file, 2026-11-11]
cad/out/display_lid_usbc.stl
202.0 x 99.5 x 21.1
