tsuyoshi-otake/paperdiy-pda-terminal/cad/out/split/splice/tray_splice_1.stl

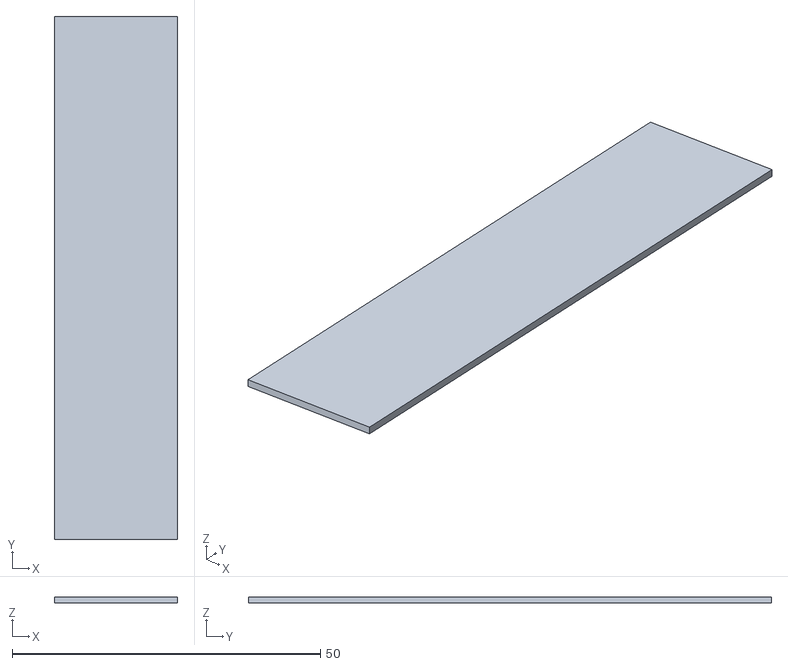
[picture p36: CAD file, 2026-11-09]
cad/out/split/splice/tray_splice_1.stl
20.0 x 84.8 x 1.00
