tsuyoshi-otake/paperdiy-pda-terminal/cad/out/split/usb_variants/lid_A_left_usb20mm.stl

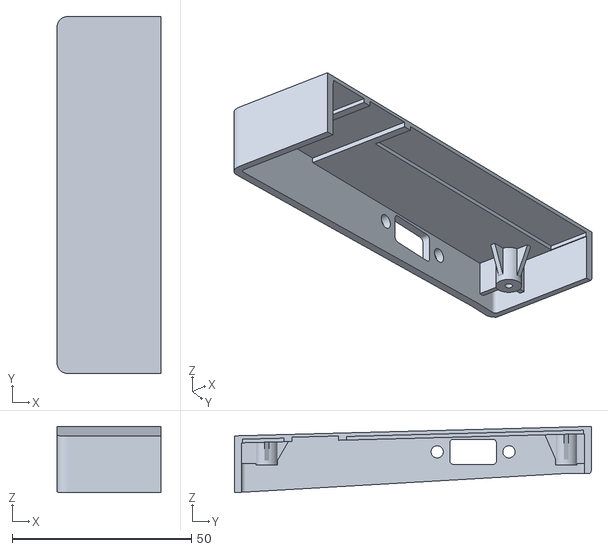
[picture p37: CAD file, 2026-11-11]
cad/out/split/usb_variants/lid_A_left_usb20mm.stl
29.0 x 99.5 x 18.5
