tsuyoshi-otake/paperdiy-pda-terminal/cad/out/whole/usb_variants/lid_usb30mm.stl

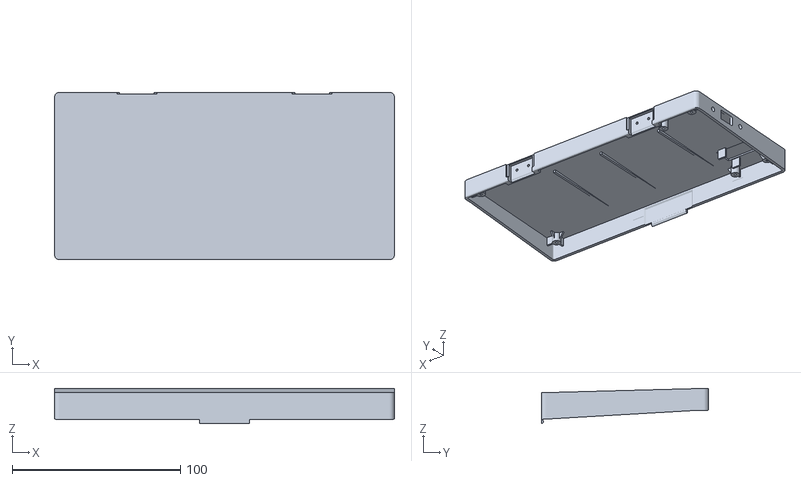
[picture p38: CAD file, 2026-11-11]
cad/out/whole/usb_variants/lid_usb30mm.stl
202.0 x 99.5 x 21.1
