tsuyoshi-otake/paperdiy-pda-terminal/cad/3mf/large/plate2_tray.3mf

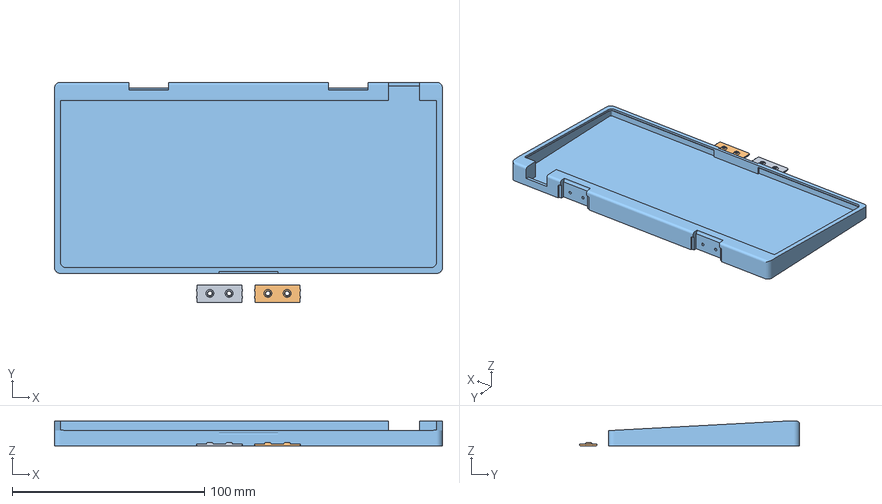
[picture p39: CAD file, 2026-11-11]
cad/3mf/large/plate2_tray.3mf
202.0 x 114.8 x 12.8 mm
hinge_cover_tray_1
hinge_cover_tray_2
tray
