tsuyoshi-otake/paperdiy-pda-terminal/cad/out/coupons/coupon_latch_tray.stl

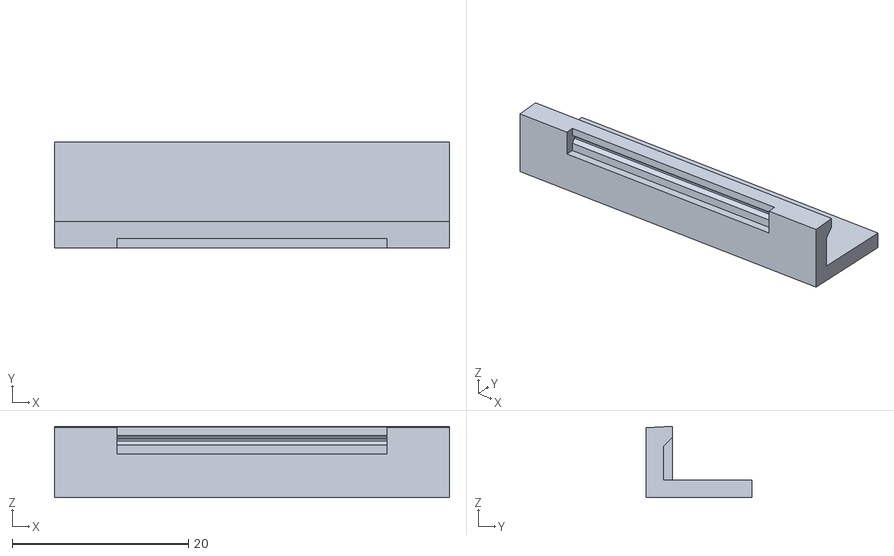
[picture p40: CAD file, 2026-11-11]
cad/out/coupons/coupon_latch_tray.stl
44.8 x 12.0 x 8.10
