tsuyoshi-otake/paperdiy-pda-terminal/cad/out/keyboard_tray.stl

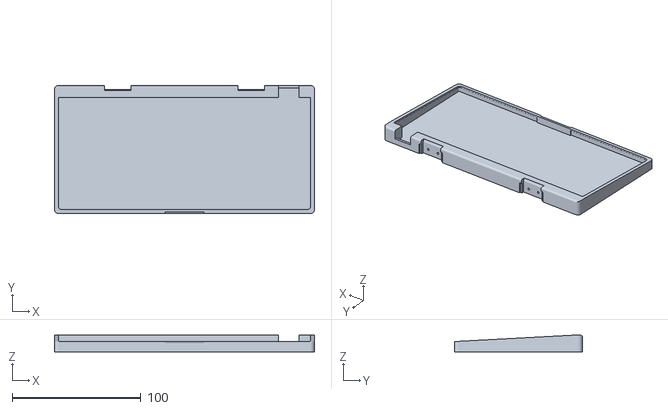
[picture p41: CAD file, 2026-11-11]
cad/out/keyboard_tray.stl
202.0 x 99.5 x 12.9
