tsuyoshi-otake/paperdiy-pda-terminal/cad/out/split/splice/lid_splice_1.stl

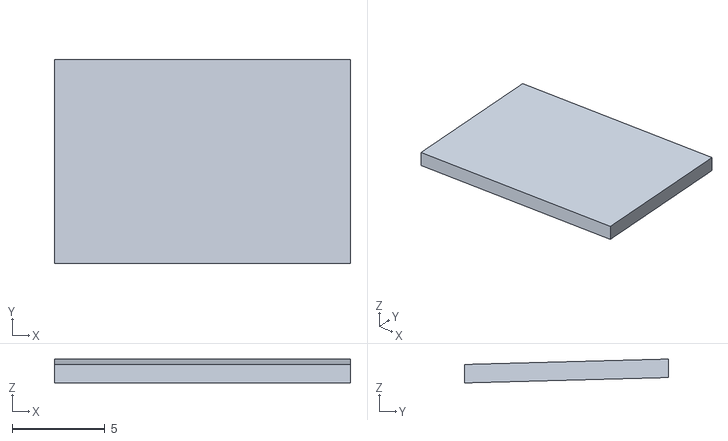
[picture p42: CAD file, 2026-11-09]
cad/out/split/splice/lid_splice_1.stl
16.0 x 11.0 x 1.29
