tsuyoshi-otake/paperdiy-pda-terminal/cad/3mf/bambu_a1mini/bambu_plate0_test_coupons.3mf

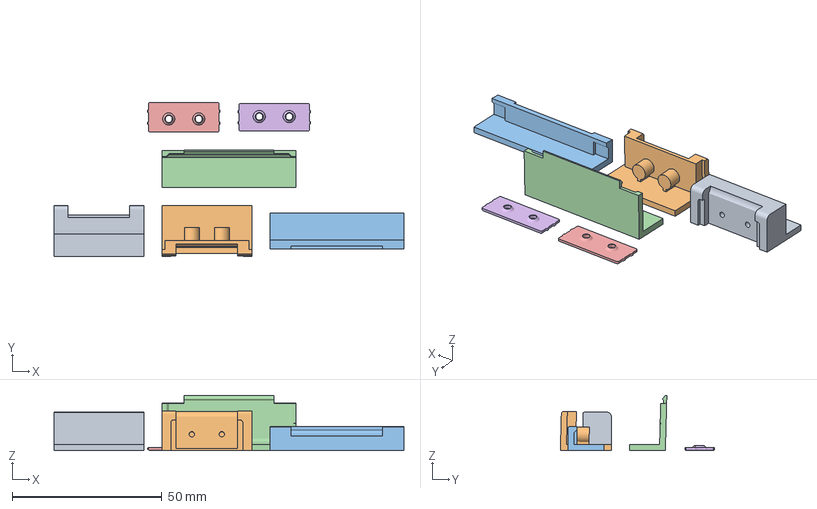
[picture p43: CAD file, 2026-11-11]
cad/3mf/bambu_a1mini/bambu_plate0_test_coupons.3mf
116.8 x 51.5 x 18.4 mm
coupon_hinge_tray
coupon_hinge_lid
coupon_latch_tray
coupon_latch_lid
hinge_cover_lid
hinge_cover_tray
