tsuyoshi-otake/paperdiy-pda-terminal/cad/3mf/large/plate3_panel.3mf

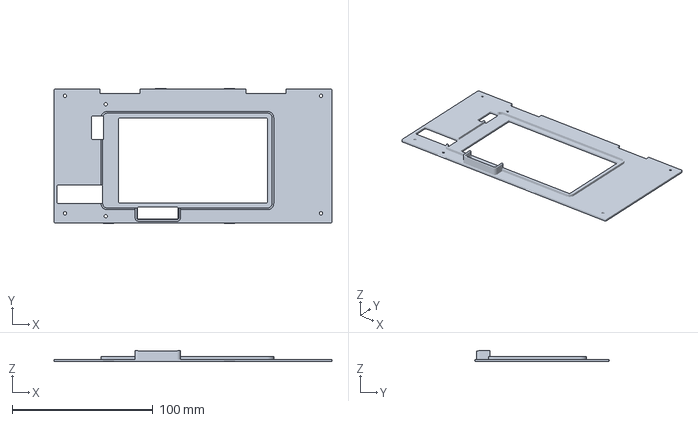
[picture p44: CAD file, 2026-11-09]
cad/3mf/large/plate3_panel.3mf
197.6 x 96.0 x 7.90 mm
