tsuyoshi-otake/paperdiy-pda-terminal/cad/out/coupons/coupon_hinge_lid.stl

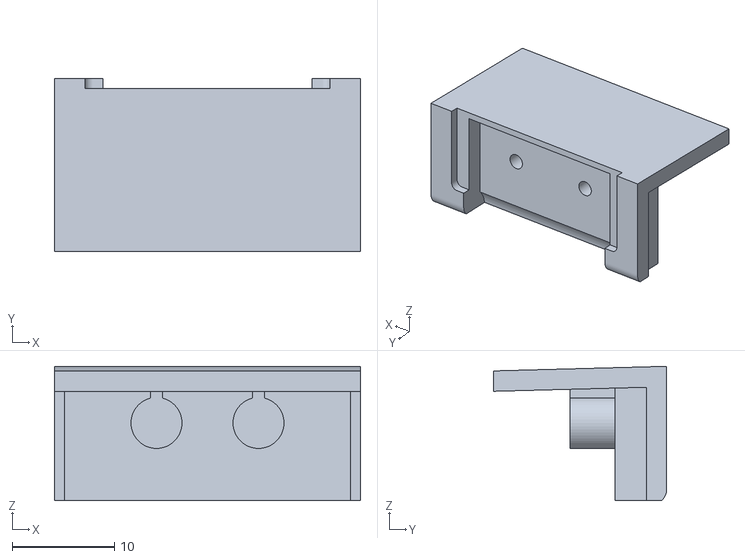
[picture p45: CAD file, 2026-11-11]
cad/out/coupons/coupon_hinge_lid.stl
30.0 x 17.0 x 13.2
