tsuyoshi-otake/paperdiy-pda-terminal/cad/out/hinge_cover_lid_x2.stl

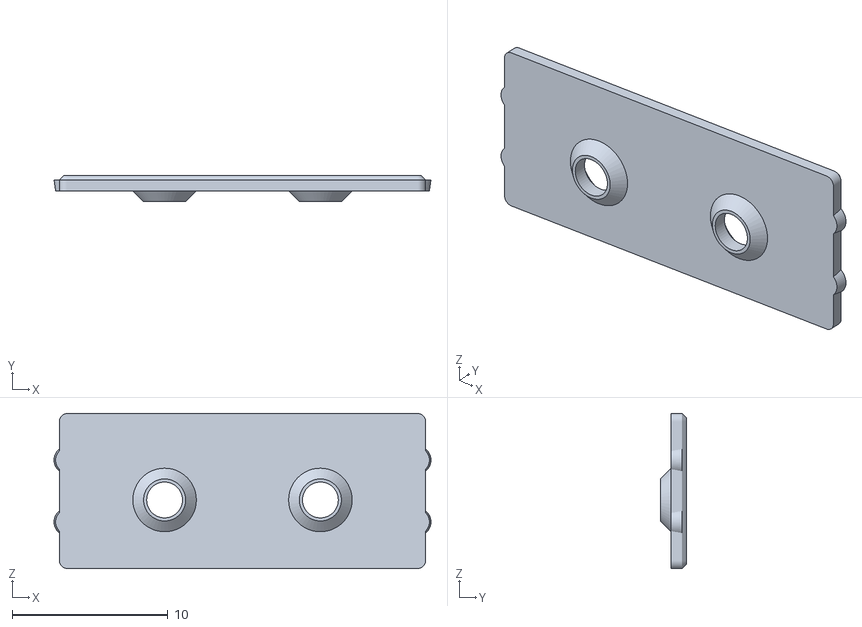
[picture p46: CAD file, 2026-11-09]
cad/out/hinge_cover_lid_x2.stl
24.2 x 1.70 x 9.95
