tsuyoshi-otake/paperdiy-pda-terminal/cad/out/split/splice/panel_splice_1.stl

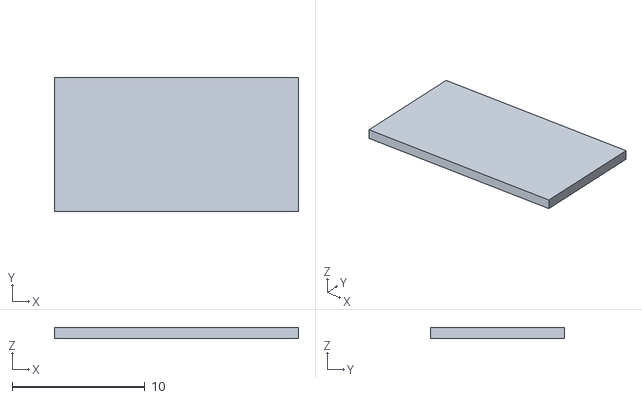
[picture p47: CAD file, 2026-11-09]
cad/out/split/splice/panel_splice_1.stl
18.4 x 10.1 x 0.8
