tsuyoshi-otake/paperdiy-pda-terminal/cad/3mf/bambu_a1mini/bambu_plate3_panel.3mf

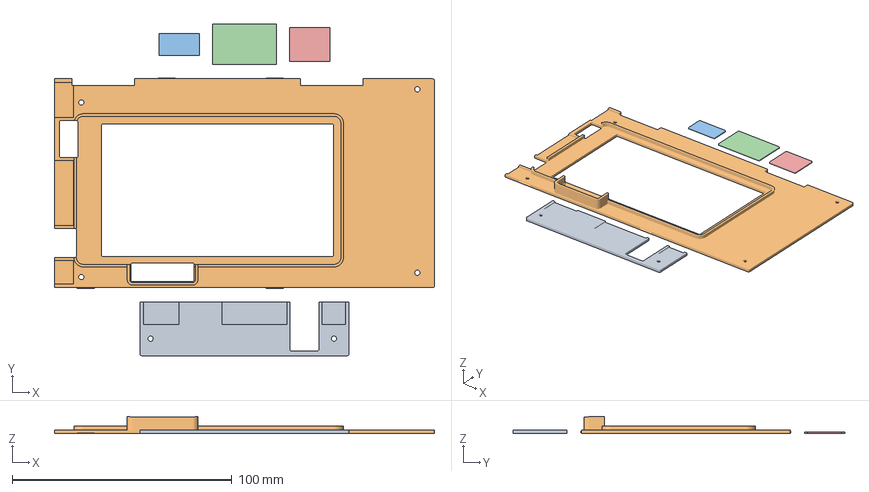
[picture p48: CAD file, 2026-11-10]
cad/3mf/bambu_a1mini/bambu_plate3_panel.3mf
173.0 x 151.0 x 7.90 mm
panel_A_left
panel_B_main
panel_splice_1
panel_splice_2
panel_splice_3
