tsuyoshi-otake/paperdiy-pda-terminal/cad/out/coupons/coupon_hinge_tray.stl

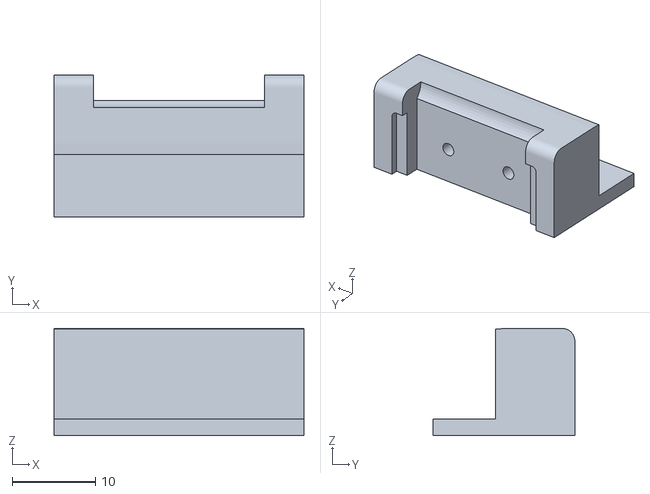
[picture p49: CAD file, 2026-11-10]
cad/out/coupons/coupon_hinge_tray.stl
30.0 x 17.0 x 12.9
