tsuyoshi-otake/paperdiy-pda-terminal/cad/out/split/splice/panel_splice_2.stl

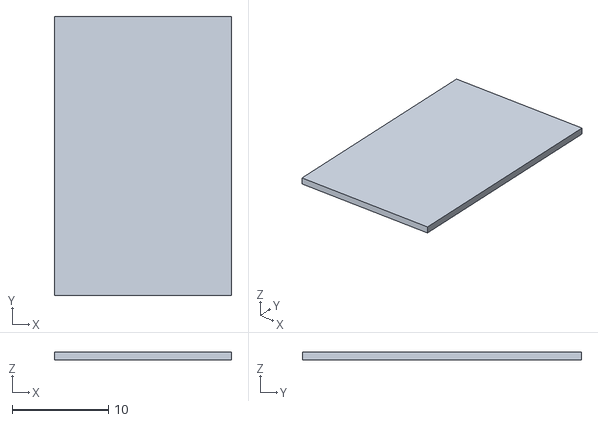
[picture p51: CAD file, 2026-11-09]
cad/out/split/splice/panel_splice_2.stl
18.4 x 29.0 x 0.8
