tsuyoshi-otake/paperdiy-pda-terminal/cad/out/split/tray_A_left.stl

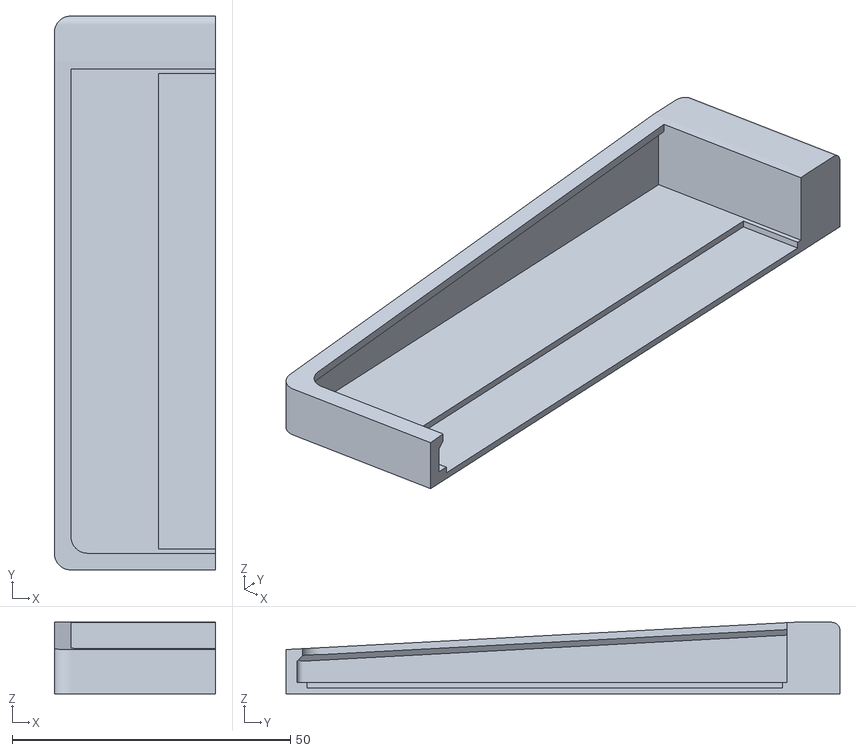
[picture p52: CAD file, 2026-11-10]
cad/out/split/tray_A_left.stl
29.0 x 99.5 x 12.9
