tsuyoshi-otake/paperdiy-pda-terminal/cad/out/paperdiy_kit_envelope.stl

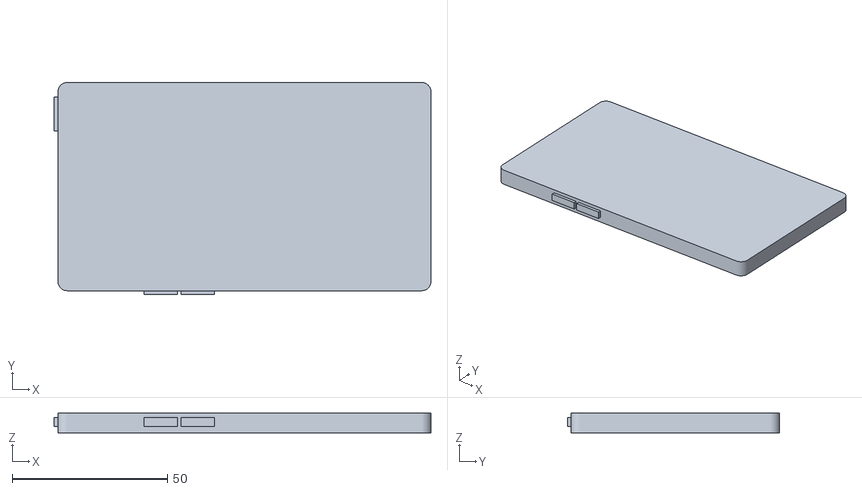
[picture p53: CAD file, 2026-11-09]
cad/out/paperdiy_kit_envelope.stl
121.3 x 68.2 x 6.30
