tsuyoshi-otake/paperdiy-pda-terminal/cad/out/split/panel_A_left.stl

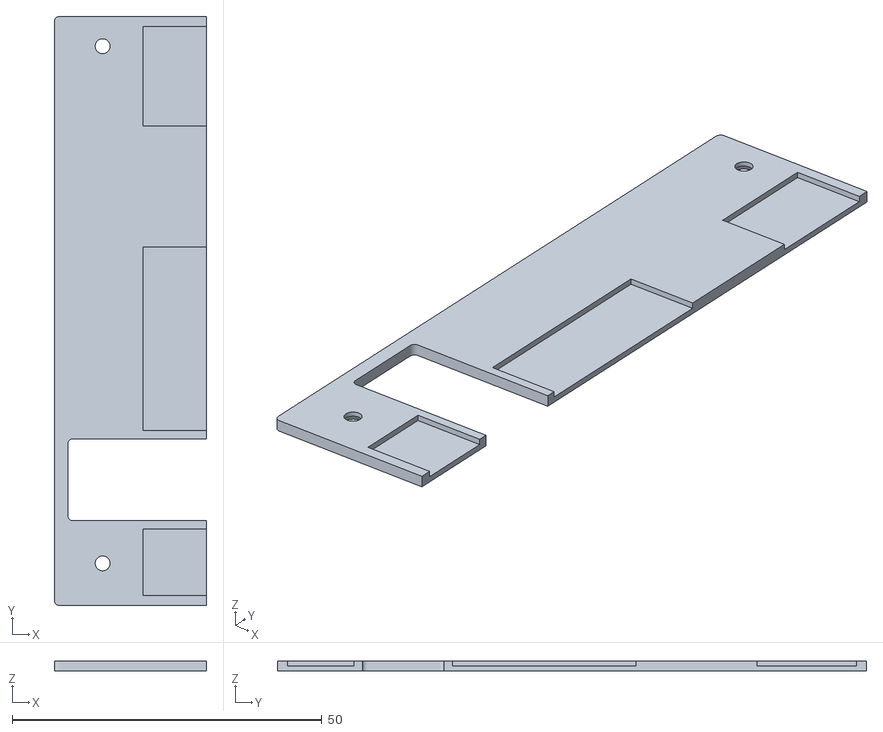
[picture p54: CAD file, 2026-11-09]
cad/out/split/panel_A_left.stl
24.6 x 95.1 x 1.60
