tsuyoshi-otake/paperdiy-pda-terminal/cad/out/split/splice/lid_splice_2.stl

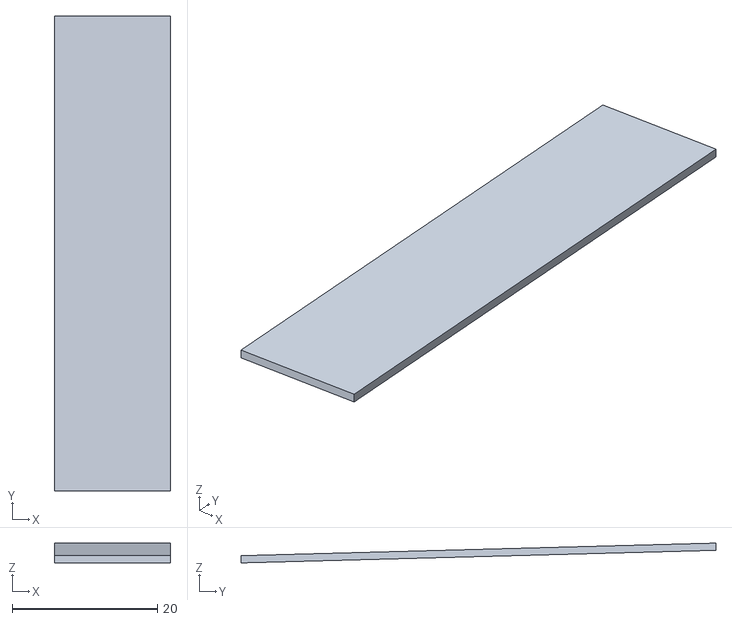
[picture p55: CAD file, 2026-11-09]
cad/out/split/splice/lid_splice_2.stl
16.0 x 65.5 x 2.74
