tsuyoshi-otake/paperdiy-pda-terminal/cad/out/split/splice/panel_splice_3.stl

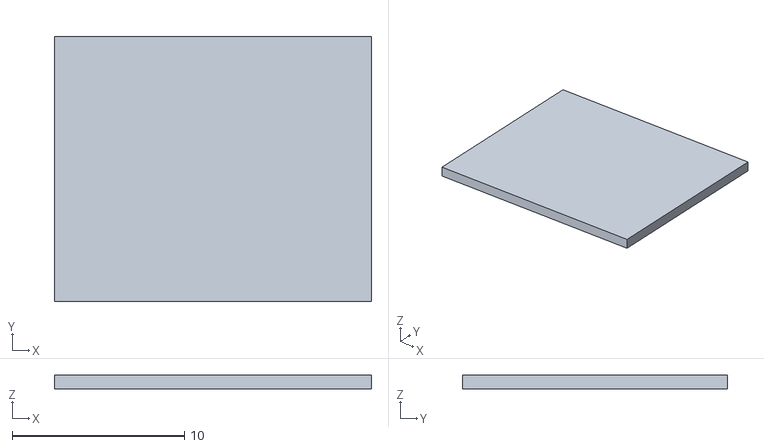
[picture p56: CAD file, 2026-11-09]
cad/out/split/splice/panel_splice_3.stl
18.4 x 15.4 x 0.8
