tsuyoshi-otake/paperdiy-pda-terminal/(list of files, cad)

Other CAD files:
cad/3mf/bambu_a1mini/bambu_plate2_tray.3mf
cad/3mf/large/usb_variants/lid_usb20mm.3mf
cad/3mf/plate1_lid.3mf
cad/3mf/usb_variants/lid_A_left_usb25mm.3mf
cad/out/split/usb_variants/lid_A_left_usb22mm.stl
cad/out/whole/usb_variants/lid_usb18mm.stl
cad/3mf/large/usb_variants/lid_usb30mm.3mf
cad/3mf/plate0_test_coupons.3mf
cad/3mf/usb_variants/lid_A_left_usb28mm.3mf
cad/out/split/lid_A_left.stl
cad/out/whole/panel.stl
cad/out/whole/usb_variants/lid_usb22mm.stl
cad/3mf/plate3_panel.3mf
cad/3mf/usb_variants/lid_A_left_usb16mm.3mf
cad/out/split/usb_variants/lid_A_left_usb25mm.stl
cad/3mf/large/usb_variants/lid_usb28mm.3mf
cad/3mf/usb_variants/lid_A_left_usb22mm.3mf
cad/out/split/usb_variants/lid_A_left_usb28mm.stl
cad/out/whole/usb_variants/lid_usb25mm.stl
cad/3mf/large/usb_variants/lid_usb22mm.3mf
cad/out/display_panel_kit.stl
cad/out/split/usb_variants/lid_A_left_usb16mm.stl
cad/out/whole/usb_variants/lid_usb20mm.stl
cad/3mf/large/usb_variants/lid_usb16mm.3mf
cad/3mf/usb_variants/lid_A_left_usb20mm.3mf
cad/out/split/usb_variants/lid_A_left_usb30mm.stl
cad/out/whole/usb_variants/lid_usb16mm.stl
cad/3mf/large/usb_variants/lid_usb25mm.3mf
cad/3mf/usb_variants/lid_A_left_usb18mm.3mf
cad/out/split/usb_variants/lid_A_left_usb18mm.stl
cad/out/whole/usb_variants/lid_usb28mm.stl
cad/3mf/large/usb_variants/lid_usb_noscrew.3mf
cad/3mf/usb_variants/lid_A_left_usb_noscrew.3mf
cad/out/split/usb_variants/lid_A_left_usb_noscrew.stl
cad/out/whole/usb_variants/lid_usb_noscrew.stl
