tsuyoshi-otake/paperdiy-pda-terminal/cad/out/print_report.md

# Printability report

Generated by `tools/print_report.py`. Slicer: `prusa-slicer` with `tools/a1mini_pla_020.ini` (an approximation of Bambu Studio's A1 mini 0.20 mm Standard + PLA, 3 walls, 15 % gyroid). Times are estimates; Bambu Studio's own estimate is the one to trust.

## Plates

| Plate | Time | Filament | Slicer stability warnings |
| --- | --- | --- | --- |
| `plate0_test_coupons.3mf` | 24m 9s | 10 g (3.4 m) | none |
| `plate1_lid.3mf` | 1h 45m 7s | 65 g (21.9 m) | none |
| `plate2_tray.3mf` | 1h 32m 25s | 62 g (20.7 m) | none |
| `plate3_panel.3mf` | 37m 31s | 24 g (8.0 m) | none |

Plates 1-3 together: about **151 g** of PLA and **3 h 54 min** of printing (plate 0, the test coupons, comes on top).

### One-piece plates for bigger printers (`3mf/large/`, sliced on a 220 x 220 mm bed)

| Plate | Time | Filament | Slicer stability warnings |
| --- | --- | --- | --- |
| `large/plate1_lid.3mf` | 1h 40m 10s | 65 g (21.7 m) | none |
| `large/plate2_tray.3mf` | 1h 28m 6s | 61 g (20.4 m) | none |
| `large/plate3_panel.3mf` | 34m 56s | 24 g (8.1 m) | none |

Together: about **150 g** and **3 h 42 min**, with nothing to glue.

## Does the 0.4 mm nozzle print everything?

Each sliced plate (0.4 mm nozzle, 0.2 mm layers, Arachne walls) compared with the model, layer by layer: the outer 0.3 mm of every section has to be covered by an extrusion (else a feature is too small for the nozzle), and sections thinner than 1.5 mm that go on in the layer above have to be filled without a gap (the snap's 1.1 mm flex zone, its 1.0 mm lip, the 1.2 mm ribs).

| Plate | Part | Surface left unprinted |
| --- | --- | --- |
| `plate0_test_coupons.3mf` | coupon_hinge_lid | 2 spot(s), up to 0.04 mm², in 1 layer(s) (z 8 mm on the bed) |
| `plate0_test_coupons.3mf` | coupon_hinge_tray | 2 spot(s), up to 0.50 mm², in 1 layer(s) (z 9.6 mm on the bed) |
| `plate0_test_coupons.3mf` | hinge_cover_lid | 4 spot(s), up to 0.29 mm², in 1 layer(s) (z 0.4 mm on the bed) |
| `plate0_test_coupons.3mf` | hinge_cover_tray | 4 spot(s), up to 0.29 mm², in 1 layer(s) (z 0.4 mm on the bed) |
| `plate1_lid.3mf` | hinge_cover_lid_1 | 4 spot(s), up to 0.29 mm², in 1 layer(s) (z 0.4 mm on the bed) |
| `plate1_lid.3mf` | hinge_cover_lid_2 | 4 spot(s), up to 0.29 mm², in 1 layer(s) (z 0.4 mm on the bed) |
| `plate1_lid.3mf` | lid_B_main | 6 spot(s), up to 0.07 mm², in 2 layer(s) (z 8..10.6 mm on the bed) |
| `plate2_tray.3mf` | hinge_cover_tray_1 | 4 spot(s), up to 0.29 mm², in 1 layer(s) (z 0.4 mm on the bed) |
| `plate2_tray.3mf` | hinge_cover_tray_2 | 4 spot(s), up to 0.29 mm², in 1 layer(s) (z 0.4 mm on the bed) |
| `plate2_tray.3mf` | tray_A_left | 1 spot(s), up to 0.13 mm², in 1 layer(s) (z 8.2 mm on the bed) |
| `plate2_tray.3mf` | tray_B_main | 5 spot(s), up to 0.50 mm², in 2 layer(s) (z 8.2..9.6 mm on the bed) |

Largest spot: 0.50 mm² in a single 0.2 mm layer; gaps inside thin walls: 0. Nothing a part depends on: the hinge covers' crush ribs start 0.25 mm high, under what the nozzle adds to a wall, so the lowest of the four layers they span is left out and the upper three print; the rest are specks where a rounded edge or the tray's sloping rim runs out in one layer.

## Wall thickness

Share of each part's surface where the wall measured straight inwards is thinner than 0.8 mm (two extrusion lines). Small values come from sharp edges and the dovetail jaws.

| Part | min (mm) | 1st percentile (mm) | surface < 0.8 mm |
| --- | --- | --- | --- |
| lid_A_left | 0.46 | 0.80 | 6.28 % (the ceiling over the USB-C channel is 0.8 mm (USB_CEIL), printed as the first layers on the bed; the splice-plate pockets at the seam leave half the wall until the plate is glued in) |
| lid_B_main | 0.35 | 1.00 | 0.58 % (the splice-plate pockets at the seam leave half the wall until the plate is glued in) |
| hinge_cover_lid_x2 | 0.00 | 0.40 | 8.88 % (a 1 mm plate; the thin spots are the edges of the screw countersinks and of the cones under them, which the screw head and the hinge's countersink hold from both sides) |
| panel_A_left | 0.62 | 0.80 | 25.65 % (the splice-plate pockets at the seam leave half the wall until the plate is glued in) |
| panel_B_main | 0.28 | 0.80 | 3.18 % (the snap bumps on its front and back edges come to a ridge; the splice-plate pockets at the seam leave half the wall until the plate is glued in) |
| tray_A_left | 0.67 | 1.00 | 0.05 % (the splice-plate pockets at the seam leave half the wall until the plate is glued in) |
| tray_B_main | 0.29 | 1.00 | 0.02 % (the splice-plate pockets at the seam leave half the wall until the plate is glued in) |
| hinge_cover_tray_x2 | 0.08 | 0.38 | 9.67 % (a 1 mm plate; the thin spots are the edges of the screw countersinks and of the cones under them, which the screw head and the hinge's countersink hold from both sides) |

Largest share apart from the noted parts: 0.00 %. OK: only sharp edges and the dovetail jaws.

## Does it tip over backwards?

Lid side (printed parts as sliced + PaperDIY Complete Kit 43.1 g + half the hinges): **138 g**, centre of mass 49.1 mm in front of the hinge axis when closed. Base without the keyboard: **64 g**. The device rests on the back edge of the tray at y = 53.0 mm; the lid reaches the table at 162.2 deg and is supported from there on.

| Opening | lid centre of mass behind the back edge | keyboard needed so it does not tip |
| --- | --- | --- |
| 90 deg | +6.8 mm | 0 g |
| 100 deg | +15.2 mm | 0 g |
| 110 deg | +23.2 mm | 17 g |
| 120 deg | +30.5 mm | 35 g |
| 130 deg | +36.8 mm | 52 g |
| 140 deg | +42.1 mm | 66 g |
| 150 deg | +46.0 mm | 76 g |
| 162 deg | +48.9 mm | 83 g |

**The keyboard has to weigh at least 83 g** (centre of mass assumed in the middle of the tray) for the device to stay upright at every angle until the lid rests on the table (162 deg). Weigh yours; if it is lighter, stay below the angle in the table where the needed weight exceeds it, or add weight in the tray.

## Does the lid stay shut?

The two HG-MF08 are free-stop friction hinges: together 0.157 N·m (0.118..0.196 with their ±25 %). The lid side's moment about the axis is at most 0.066 N·m (level, 138 g at 49.1 mm), so the hinges hold it at any angle (1.8x at least) and it never falls shut by itself.

Let go, friction hinges turn back a little (the twist stored in them and in their seats). Anywhere else that is made up for by pushing a little further; at the closed position the lid lands on the tray and cannot go further, so it comes up again: every degree at the axis is 1.7 mm at the front edge. The snap is what keeps it down.

**The rims near the hinges.** Reported from the built device: with the hinge screws tight the lid opens, with the screws loose it stays shut. The hinge axis lies in the parting plane, so rims that touch 1.65 mm from it and come out 0.05 mm proud hold the front edge 3 mm open once the screws pull the leaves home. The lid's underside therefore leans up toward the hinges (`PART_RELIEF`, 0.4 mm at the back face). How much of the lid's coming up was this rather than spring-back is not known; if most of it, the snap had far more than the push below to hold, which would be why it never held.

The snap's figures are simulated: `tools/snap_sim.py` closes the built lid on the built tray along the hinge's arc, with the lip as a spring (plate model) and friction 0.3 on the ramps; all cases are in `out/snap_sim.md`.

| | at the front edge |
| --- | --- |
| push from the hinges' spring-back, less the lid's weight | 0.5..1.3 N |
| to close (the lid 0.2 mm forward .. where it was drawn) | 4..13 N |
| the snap holds (the same two cases) | 7..17 N |
| the snap holds if the lip's printed gap is 0.10 mm wider than drawn | 12 N |
| the snap holds with the lid 0.4 mm forward | 0 N (the bump does not reach its groove) |
| to open: snap + hinge friction - the lid's weight | about 8..18 N |

**No stops.** For one revision (never printed) two tongues on the lid reached down inside the tray's front wall to keep the lid from shifting forward. They are gone: the levering at the hinges is the likelier reason the earlier snaps did not hold; with a lid that sits forward and does not give they would have ridden up on the tray's wall; and they could not be put where the lip is. What remains true: every 0.1 mm the lid sits forward of its drawn position takes 0.1 mm off the engagement (0.37 mm on the built parts). If the closed lid's front face stands proud of the tray's by more than about 0.2 mm, measure the step: the lip has to be moved by that much.

The forces are the plate model's (ceiling and end walls rigid), so the real ones are somewhat lower. They are higher than the 8 N to close and 10 N to open quoted before: those were worked out for 30 and 35 degree faces, and the bump as built has 44 and 49 degree faces (`src/build.py`, `latch_flanks`). An earlier note that the model overstates the hold several times over was drawn from snaps that never engaged, and does not stand. The snap coupons of plate 0 take in the whole flex zone: click them together and pull them apart before printing the lid and the tray. Too hard to open: file the bump's upper flank a little.

Press the front of the lid until the snap clicks; a lid that is only laid down stays open by the spring-back. To open, hold the base: it weighs 64 g plus the keyboard, less than the pull on the lid, and the hinges would carry it up with the lid unless the keyboard weighed about 332 g.
