tsuyoshi-otake/paperdiy-pda-terminal/CHANGELOG.md

# 変更履歴

## 2026-11-12（その 38）ストッパーをやめた：留めツメは中央の 1 つだけ

左右のストッパー（蓋の内側の舌 2 本）を中央のツメと同じ場所に、という依頼だったが、そこには置けない（中央ではトレイの壁がツメの受けで内側いっぱいまで厚く、舌の入る場所がない。蓋の壁もツメと一緒にたわむ部分で、そこに付けた舌は蓋を止める役をしない）。相談のうえ、ストッパーをやめた。

- 蓋から舌 2 本を、トレイからデッキの切り欠き 2 か所と壁の角の面取りをなくした（`LATCH["stop"] = None`。コードは残してあり、値を入れれば戻る）。ツメ（幅 30 mm）、まわりの薄い帯、出っ張りと溝は その 34 のまま
- やめてよい理由：その 37 のとおり、蓋が開く原因はヒンジ側の当たりのほうがありそうなこと。蓋が 0.3 mm より手前に動かずに付いている場合、舌がトレイの壁に乗り上げて閉まらなくなること（その 35）
- 残る弱点：蓋が図面の位置より手前にあると、その分だけ掛かりが減る。シミュレーションでは、図面どおりで閉じる力 13 N・留める力 17 N、0.2 mm 手前で 4 N・7 N、0.3 mm 手前で 2.6 N（持つと開く）、0.4 mm 手前では掛からない。閉じた蓋の手前の面がトレイより 0.2 mm 以上出ているなら、段差を測ってツメの位置を動かす
- シミュレーション（`tools/snap_sim.py`）と図（`snap_sim.png`、`latch.png`）、印刷の報告を、ストッパーなしの形に合わせた。ストッパーを設定すれば、その場合の表も出る
- 試し刷りの留めツメの小片は、薄い帯を含む幅 45 mm に戻した。plate 0 は約 24 分・10 g
- 変わったファイル：plate 0、plate 1（蓋 B）、plate 2（トレイ B）、`large/` の蓋とトレイ、メス端子用の蓋（一体版）、Bambu の plate 0〜2。plate 1 は約 1 時間 45 分・65 g、plate 2 は約 1 時間 32 分・62 g
- **手元のトレイとの組み合わせ**：その 34 以降に刷ったトレイ（デッキの手前に切り欠きが 2 つある）には、この蓋がそのまま合う（切り欠きは空いたままになるだけ）。それより前のトレイ（幅 30 mm のツメを最初に付けた版）は、くぼみが 0.4 mm 浅く、溝の形も違うので、この蓋のツメは収まらない
- 未確認：この版はまだ刷っていない

## 2026-11-12（その 37）ヒンジのねじを締めると蓋が開く：蓋の下面をヒンジ側で逃がした

実機で、ヒンジのねじを締めると蓋が開き、緩く締めていると閉じたままになる、と分かった。

- **見立て**：ヒンジの軸は合わせ目の面の上、背面から 0.15 mm のところにある。蓋とトレイの縁は全周ですき間なしに当たる設計で、いちばん軸に近い当たりは軸から 1.65 mm。蓋の手前の縁はその 60 倍遠い。奥の縁が合わせて 0.05 mm 盛り上がっているだけで（印刷の上面はそのくらい盛り上がる）、皿ねじを締めてヒンジの板が穴の位置に引き寄せられると、奥の縁が支点になって手前が 3 mm 開く。ねじが緩いと、板が穴のすき間の中で逃げて蓋の奥が浮くので、蓋は閉じたままになる。報告と合う
- **直し方**：蓋の下面を、y −40（手前の縁から 6.5 mm）から背面に向かって、背面で 0.4 mm になるよう斜めに削った（`PART_RELIEF`。真ん中で 0.16 mm、背面の壁で 0.39 mm）。蓋は手前の縁で着地し、ヒンジのそばの縁は当たらない。奥の合わせ目に 0.4 mm のすき間が見える
- 変わったのは蓋だけ：`plate1_lid.3mf`（蓋 A・B）、`large/plate1_lid.3mf`、メス端子用の蓋、Bambu の plate 1、試し刷りの plate 0（蓋側のヒンジの小片）。トレイと化粧パネルは変わっていない。plate 1 は約 1 時間 46 分・65 g
- **これまでの説明への影響**：蓋の手前が浮くのを「トルクヒンジの戻り（0.5〜1.3 N）」で説明して、留めツメを何度も直してきたが、浮きの大半がこれだった可能性がある。その場合、ツメは 1.3 N よりずっと大きな力で押し上げられていたことになり、ツメが留まらなかったことの説明にもなる。どちらがどれだけかは、この版を刷るまで分からない
- いまの蓋で試すなら：蓋の奥の縁（ヒンジのある厚い壁の、トレイに当たる面）を紙やすりで 0.3 mm ほど落として、ねじを締めても閉じたままかを見る
- 未確認：見立ては報告と形からの推定で、ヒンジの穴の位置そのもの（メーカーの図面の値で作ってある）がずれている可能性は残る。この版はまだ刷っていない

## 2026-11-12（その 36）トレイの左右の位置決めリブをやめた

その 33 で戻した左右の壁のリブ（キーボードの端から 0.15 mm）は、刷ってみると少しきつかった。

- トレイの内側に出るものは、これでなくなった。キーボードの入る所は元のトレイと同じ 196 × 87 mm のまま。キーボード（推定 194 × 85 mm）は前後・左右に片側 1 mm ほど動く
- `TRAY_KB_RIBS = None`。キーボードの幅を測れば、すき間を決めて戻せる（例：`dict(end_y=(-25, 25), fit=0.5)`）
- 変わったファイル：`plate2_tray.3mf`（トレイ A・B）、`large/plate2_tray.3mf`、`bambu_a1mini/bambu_plate2_tray.3mf`、試し刷りの plate 0（トレイ側のヒンジの小片）。蓋、化粧パネル、留めツメとストッパーのまわりは変わっていない
- plate 2 は約 1 時間 33 分・62 g、plate 1〜3 の合計は約 3 時間 55 分・151 g
- すでに刷ったトレイは、リブ 4 本（左右の壁に 2 本ずつ）をニッパーで切り取れば同じ形になる。刷り直さなくてよい

## 2026-11-11（その 35）留めツメを閉じるところをシミュレーションした（形は変えていない）

「これはシミュレーションできるのか」に答えるために、出来上がった蓋とトレイを使って、閉じる動きを計算した。

- **追加**：`cad/tools/snap_sim.py`（`make sim`、結果は `cad/out/snap_sim.md` と `snap_sim.json`、図は `docs/images/snap_sim.png`）。蓋とトレイの STL を、ツメの真ん中とストッパーの位置で切った断面にして、蓋をヒンジの軸まわりの軌道で下ろす。ツメと、舌を支える壁はばね（`latch_plate.py` の板の計算を 2 つの荷重で解く `wall_compliance` を足した。24.9 N/mm と 108 N/mm）、斜面には摩擦 0.3。閉じたあと、ヒンジの戻り（0.5〜1.3 N）で手前を持ち上げて、留まるかを見る。蓋が図面の位置から前後にずれている・自由に動く・押すとたわむ、刷り上がりのすき間が広い・狭い、を条件として変えられる
- **分かったこと**（力は手前の縁での値）
  - ストッパーのない版は、出っ張りが来るときに蓋が 0.3 mm 手前にあると、留める力が 2.6 N しか残らず、0.4 mm では出っ張りが溝に届かない。「カチッと言わない」「蓋の手前が少し前に出ている」という報告と合う
  - ストッパーのある版は、蓋が前後に動く・たわむ場合には留まる（閉じる力 9 N、留める力 12 N）
  - **その 34 の直しの弱点**：蓋が 0.3 mm より手前に**動かずに**付いている場合、ストッパーの舌がトレイの壁に乗り上げて、閉じるのに 29 N（0.3 mm）、44 N（0.4 mm）要る。手では閉まらず、無理に押すと厚さ 0.9 mm の舌が折れるおそれがある。この場合は、段差の寸法だけツメの位置を動かす必要がある
  - 刷り上がりのすき間（ツメとくぼみ、舌と壁）が 2 か所とも 0.10 mm 広いと、留める力は 1.3 N まで落ちる。0.10 mm 狭いと閉じる力 20 N、ひずみ 0.44 %
- **その 34 の「原因」の書き方を直した**：「ヒンジのねじ穴の遊びのぶん蓋が前後にずれる」と断定していたが、ねじは蓋の前後の向きに締めるので、ねじ穴の遊びでは前後には動かない。蓋が閉じるときに手前へ押されている（ヒンジやその座の遊び・たわみ）のか、最初から手前に付いている（ヒンジの板の座の深さ、印刷の寸法）のかは、分かっていない。シミュレーションはどちらでも報告どおりの結果になるので、実物で確かめるしかない。設計メモ、組み立てガイド、`params.py` のコメント、印刷の報告を、この書き方に直した
- **力の数字の間違いを直した**：閉じる力 7.9 N、留まる力 9.5 N、開ける力 10.4 N と書いていたのは、出っ張りの面を 30°・35° として計算した値だった。出っ張りの形をツメの中 0.3 mm から描いているぶん、出来上がった面は 44°・49° になっている（`build.py` に `latch_flanks` を足し、ログに出す）。シミュレーションでは、閉じる力 9〜13 N、留める力 12〜17 N、開ける力 13〜18 N（蓋がストッパーに当たった状態〜図面どおりの位置）。形は変えていない（これまでに刷った版も同じ面）
- 印刷の報告（`out/print_report.md` の「Does the lid stay shut?」）の留めツメの数字は、式の見積もりをやめて、このシミュレーションの値にした
- 組み立てガイドの 4 章に「カチッと言わないとき」を足した（蓋の手前が出ていないか、奥へ押すと動くかを見る。動かない段差が 0.3 mm 以上なら無理に押し込まない）
- CI でもシミュレーションを走らせる
- **部品の形は 1 バイトも変わっていない**（`make verify` で 71 ファイルとも一致）。刷り直しは要らない
- 未確認：シミュレーションは、蓋がヒンジの上でどこに付いていてどのくらい動くかを入力として受け取るもので、それを当てるものではない。板の計算は天板と左右の壁を動かないものとしているので、力は実物より大きめに出る。ストッパーのある版は、まだ刷っていない

## 2026-11-11（その 34）留めツメが掛からない原因を直した：蓋が手前へずれないようにするストッパー

幅 30 mm にした蓋とトレイを刷っても、カチッと言わず、蓋が開いたままだった。蓋の手前の面は、トレイの面より少し前に出ていた。

- **原因**：蓋は 100 mm 奥のヒンジだけで支えられていて、ヒンジのねじ穴の遊びのぶん前後に 0.数 mm ずれる。閉じるときにツメの斜面がくぼみの縁に当たると、壁がたわむ前に蓋ごと手前へ押し出されてしまい、掛かりの 0.3 mm がなくなっていた。幅や角度の問題ではなかった（その 25 と その 29 の対策は的外れだった）
- **直し方**：ツメの両脇（x ±26 mm）に、蓋の内側の舌（ストッパー、幅 8 mm、合わせ目から 3.5 mm 下まで）を 2 本足した。トレイの手前の壁の内側に入り（デッキに切り欠き）、壁の内側の面に当たって蓋が手前へずれるのを止める。蓋の手前の縁が、トレイの壁を外（ツメ）と内（舌）からまたぐ形になり、ツメは壁をたわませないと通れない
  - 舌と壁のすき間は 0.10 mm。舌の外側の面は閉じる軌道に合わせて傾け、トレイの壁の角には 0.6 mm の面取りを付けた。閉じる最後の 6° で舌がトレイに当たらないことを `build.py` で確かめている
  - 舌はキーボードの入る空間（196 × 87 mm）には出ていない
- **ツメの調整**：掛かっていなかったので、その 29 で強くした分を戻した。掛かりの面 45° → 35°、閉じる側の斜面 45° → 30°、ツメとくぼみのすき間 0.15 → 0.05 mm（ツメはたわむ側なので、くぼみの面に沿わせる）、ツメの長さ 2.2 → 2.6 mm。幅 30 mm はそのまま
  - 蓋がストッパーに当たった状態での掛かりは 0.30 mm。留まる力は計算で 9.5 N（ヒンジが押し上げる力は 0.5〜1.3 N）、閉じる力 7.9 N、開ける力 10.4 N。ひずみは 0.31 %、壁が 0.45 mm いっぱいたわんでも 0.46 %
- **取り消し**：その 29 で「計算は実物の 2〜5 倍に出る」と書いたのは、掛かっていなかったツメの結果から推したもので、根拠がなかった。文書と印刷の報告から消した
- **試し刷り**：留めツメの小片を、薄い帯とストッパー 2 つを含む幅 65 mm にした。本体を刷る前に、カチッと掛かるかを確かめられる。plate 0 は 約 28 分・12 g
- 留めツメの図（`docs/images/latch.png`）にストッパーの断面を足した
- 別の作り方 `KIT_LID=solid`（詰まった蓋）にはストッパーが入らない（その蓋と組むトレイは壁が 3 mm で、舌の入る場所がない）。この蓋ではツメが掛からないおそれがあることと、ひずみが目安を超えること（0.55 %）を、ビルドのログに `CHECK:` として出す（止めはしない）。標準の版には関係ない
- 変わったファイル：`plate0_test_coupons.3mf`、`plate1_lid.3mf`（蓋 B）、`plate2_tray.3mf`（トレイ B）、`large/` の蓋とトレイ、`bambu_a1mini/` の plate 0〜2。化粧パネルは変わっていない
- 未確認：この版はまだ刷っていない。原因の見立ては、「カチッと言わない」「蓋の手前が少し前に出ている」という報告と形からの推定で、まだ実物で確かめていない

## 2026-11-11（その 33）トレイの左右の位置決めリブを戻した

- その 27 でキーボードの位置決めリブ 11 本を全部やめたが、左右の壁の 2 本ずつ（y ±25、幅 1.2 mm、キーボードの端から 0.15 mm）は残しておいてよかったので戻した。キーボードが横にずれなくなる。手前と奥の 9 本は、干渉するのでやめたまま
- デッキの穴（196 × 87 mm）は変えていない。リブの先は穴の縁より 0.85 mm 内側に出る。きついときは先をやすりで削る
- 変わったファイル：`plate2_tray.3mf`、`large/plate2_tray.3mf`、`bambu_a1mini/bambu_plate2_tray.3mf`
- 未確認：この版のトレイはまだ刷っていない

## 2026-11-11（その 32）実機の写真を README に載せた

- 組み上がって動いている実機の写真を README の先頭に載せた（`docs/images/photo_2026-11-11.jpg`。Raspberry Pi に SSH で入ったところ。留めツメを幅 30 mm に広げる前の版）。完成予想図はその下に残した
- 「どこまで確かめたか」の説明を書き直した：実機が 1 台組み上がって動いていること、ただしいまのリポジトリの版そのもの（幅 30 mm の留めツメ）はまだ刷っていないこと（README、`cad/README_ja.md`、`cad/README.md`、組み立てガイド、リリースノート）

## 2026-11-11（その 31）別の作り方が今も作れるかを CI で確かめる

- **直したこと**：その 29 で留めツメのひずみの確認を厳しくしたとき（印刷の誤差を足した値で 0.5 % 未満）、文書にある別の作り方 `KIT_LID = "solid"`（中まで詰まった蓋）がビルドの途中で止まるようになっていた。この蓋は前の壁が低くて固く、誤差を足すと 0.61 % になるため。標準の蓋（`shell`）は厳しい条件のまま、詰まった蓋は図面どおりの掛かりで 0.5 % 未満（0.41 %）を条件にし、誤差を足した値が超えるときはビルドのログに `CHECK:` を出すようにした
- **再発を防ぐ**：`make variants` を足した。前の設計（`PD_MOUNT=bare`）と詰まった蓋（`KIT_LID=solid`）を、作業用のコピーの中で STL と 3MF まで作る（`cad/out` は変わらない）。CI でも push のたびに実行する。これまで、この 2 つは「作れる」と文書に書いてあるだけで、確かめる仕組みがなかった
- `KIT_LID` を環境変数でも選べるようにした（`PD_MOUNT` と同じ）
- 標準の版の出力（STL・3MF）は変わっていない

## 2026-11-11（その 30）最初のリリースと、ドキュメントの見直し

- **リリース**：印刷用のファイルとビルド済みのファームを、GitHub の Releases からまとめて取れるようにした。最初のリリースは `v2026.11.11`（ファーム 0.3.2、筐体はこの日の版）。タグ名は日付にした（ファームの版番号は `firmware/version.txt` のまま別に数える）
  - リリースを出すのは `.github/workflows/release.yml`（Actions → release → Run workflow でタグ名を入れて手動で実行）。題名と本文は `docs/releases/（タグ名）.md` から取り、そのコミットにタグを付ける。「Dry run」なら公開せずに zip だけ作る。手順は README の「リリースの出し方」
  - 付けるファイルは `make dist`（`cad/tools/dist.py`）が `dist/` に作る次の 4 つの zip と `SHA256SUMS`。同じ入力なら同じバイトになる（日時を固定）。それぞれに、当てはまるライセンスの文書を入れてある
  - `paperdiy-pda-case-bambu-a1mini.zip`：A1 mini（0.4 mm ノズル）用の Bambu Studio プロジェクト
  - `paperdiy-pda-case-3mf.zip`：形だけの 3MF（A1 mini 用の分割版、大きいプリンター用の一体版、メス端子用の蓋）
  - `paperdiy-pda-case-stl.zip`：個別の STL
  - `paperdiy-term-firmware-0.3.2.zip`：ファーム（書き込み用の 2 つの bin、SHA256SUMS、ビルド条件、ライセンス表示）
- **ドキュメントの見直し**（いまの形と数字に合わせた）
  - 「どこまで確かめたか」を書き直した：壁 2.0 mm の版も刷って組み、そこで出た問題を直したこと、直したあとのいまの版はまだ刷っていないこと（README、`cad/README_ja.md`、`cad/README.md`、組み立てガイド）
  - README の「まだ確かめていないこと」に、Bambu Studio プロジェクトが実際に設定どおり開くかと、足のない底の滑りやすさを足した
  - 組み立てガイド 2-2 の表で、合計の行の 0.4 mm ノズルと 0.2 mm ノズルの欄が入れ替わっていたのを直した
  - `cad/README_ja.md`：大きいプリンター用の合計が古い値（2 時間 55 分・118 g）で、欄も違っていたのを直した。充電ケーブルを挿したままの開く角度を 99° → 95°、机の上の限界を 169° → 162° に直した
  - `cad/README.md`：メス端子の高さの上限 8.2 mm → 7.2 mm、パラメータ表の `KB_TOP_Z`（12.7 → 13.5）と `HINGE_AXIS_Y`（54.15 → 53.15）を直し、表になかったパラメータ（`HINGE_TORQUE`、`BACK_OLD_Y`、`Y_BACK`、`WHOLE_BED`、`KB_CUTS_ENABLED`、出力先のフォルダなど）を足した。出力の表の並びを直した
  - 印刷の目安をいまの値にそろえた（試し刷り 約 24 分・10 g、plate 1〜3 の合計 3 時間 54 分・151 g、一体版 3 時間 42 分・150 g）

## 2026-11-11（その 29）留めツメを幅広に（12 mm → 30 mm）、掛かりの面を 45° に

留めツメが勝手に外れるので、幅を広げた。

- ツメの幅を 12 mm → **30 mm** にした（`LATCH["w"]`）。たわむ壁をそのぶん広く巻き込むので、計算で 1.7 倍固くなる（15.0 → 24.9 N/mm）。トレイのくぼみと溝、裏の座も同じ幅に広がる
- 掛かりの面（開けるときに乗り越える斜面）を 35° → **45°** にした（`LATCH["open_deg"]`）。同じ押し返しで 1.5 倍留まる。溝の上に残るトレイの壁は 0.6 → 0.8 mm
- 合わせて、留まる力は計算で 5.7 N → **13.9 N（2.4 倍）**。掛かりが 0.15 mm しか残らなくても 6.9 N。閉じる力は 8.1 → 13.4 N、開ける力は 6.6 → 14.8 N
- **この計算は実物より大きく出る**：前のツメは計算では 5.7 N で留まるはずが、刷ったものは勝手に外れた。天板を動かないものとして解いていること、0.45 mm の出っ張りが図面より丸く刷られることが理由で、実際の力は計算の 2〜5 分の 1 ほどと見積もっている（`out/print_report.md` にも書いた）。それでもヒンジが押し上げる力（0.5〜1.3 N）の 2 倍以上は残る見込み
- 薄い帯（x −20〜20 mm、1.1 mm）と掛かり（0.30 mm）は変えていない。帯は化粧パネルの突起の溝（x 22〜30）の手前で止まるので、幅 30 mm が帯に入る上限（両脇に 5 mm）。化粧パネルは変わらない
- ひずみは最大 0.31 %（掛かりが 0.45 mm になっても 0.46 %。目安の 0.5 % 未満）。ひずみは掛かりの深さで決まり、幅では増えない。`build.py` は誤差を足した場合で確かめるようにした
- **試し刷りで留まり具合を確かめられるようにした**：plate 0 の留めツメの小片を、薄い帯を丸ごと含む幅 46 mm にした（前は 26 mm で、帯の途中で切れていて本体よりずっと柔らかかった）。計算では本体の 9 割ほどの固さ。plate 0 は 約 24 分・10 g（前は 21 分・8 g）
- 固すぎるときは、ツメの内側の出っ張りの上側の斜面を紙やすりで少し削る
- 変わったファイル：`plate0_test_coupons.3mf`、`plate1_lid.3mf`（蓋 B）、`plate2_tray.3mf`（トレイ B）、`large/` の蓋・トレイ・メス端子用の一体の蓋、`bambu_a1mini/` の plate 0〜2。分割版の蓋 A（メス端子用を含む）と化粧パネルは変わっていない
- 未確認：この版はまだ刷っていない

## 2026-11-11（その 28）TPU の足をやめた

TPU の足は、作るときの失敗を招くだけだったので、なくした。

- トレイの底の四隅のくぼみ（16 × 8 mm、深さ 0.8 mm）と、TPU の足 4 個（`TPU_FEET`、`FOOT_H`、`out/tpu_foot.stl`）をやめた。トレイの底は平らで、そのまま机に置く（元の作品と同じ）
- `plate4_tpu.3mf` と `bambu_a1mini/bambu_plate4_tpu.3mf`、TPU 用のスライス設定（`tools/a1mini_tpu_040.ini`）を削除した。印刷は PLA の plate 0〜3 だけ
- トレイをスライスしたときの注意（くぼみの上の橋渡し）が消え、どのプレートも注意なしになった
- 足の 0.4 mm がなくなったぶん、蓋が机に当たる角度は約 169° → 約 162°。倒れないために必要なキーボードの重さは 88 g → 83 g（支点はトレイの底の後ろの縁）
- 閉じた高さは手前 23.8 mm・奥 26.4 mm（足を入れた 24.2 / 26.8 mm ではなくなった）
- 変わったファイル：`plate2_tray.3mf`、`large/plate2_tray.3mf`、`bambu_a1mini/bambu_plate2_tray.3mf`（底のくぼみがなくなっただけ。印刷の目安は 1 時間 32 分・62 g のまま）と、試し刷り `plate0_test_coupons.3mf` のトレイ側ヒンジ小片（底のくぼみがなくなった。はめあいは同じなので、刷ってあれば刷り直さなくてよい）。蓋・化粧パネルは変わっていない
- 未確認：この版のトレイはまだ刷っていない。机の上での滑りやすさは確かめていない

## 2026-11-10（その 27）トレイの内側の出っ張り（キーボードの位置決めリブ）をやめた

キーボードに干渉するので、トレイの内側の出っ張りを全部なくした。

- キーボードの位置決めリブ 11 本（手前 4、奥 5、左右 2 ずつ。`TRAY_KB_RIBS`）と、リブとのすき間（`KB_FIT`）をやめた
- デッキの穴を、元のトレイの内側と同じ 196 × 87 mm にした（前は 195.3 × 86.3 mm。`KB_FACE_X`・`KB_FACE_Y` = 元のトレイの内壁）。CACOE が入ることがわかっている大きさで、手前の角も元と同じ R3
- 床から縁まで、この 196 × 87 mm の空間に入り込むものが何もないことを `build.py` で確かめている（0 mm³）。留めツメの受けの座は、空間の手前の面と面一
- デッキは手前と左右で幅 1.0 mm（前は 1.35 mm）、奥の帯は 7.5 mm（前は 7.85 mm）
- **引き換えに、キーボードは位置決めされない**。元のトレイと同じだけ動く（報告では前後・左右とも 2 mm ほど）。気になるなら、はがせる両面テープで床に留める（組み立てガイド 3-6）。キーボードの幅と奥行きを測れば、すき間を詰めたトレイも作れる
- 印刷の目安：plate 2 は 1 時間 32 分・62 g（前は 1 時間 38 分・63 g）、plate 1〜3 の合計は 3 時間 53 分・151 g。一体版は 3 時間 41 分・150 g
- ノズルの確認（`print_report.py`）：薄い壁の中のすき間の判定を、「上の層にも続いている断面」に限った。デッキの穴の角で、傾いた縁の上面が 1 層の中で消える所（0.3 × 1 mm）が、壁のすき間として数えられたため。こういう所は「刷られない表面」の表には前と同じく出る
- 変わったファイル：`plate2_tray.3mf`、`plate0_test_coupons.3mf`（トレイのヒンジ小片）、`large/plate2_tray.3mf`、`bambu_a1mini/` の同じ 2 つ。蓋・化粧パネル・足は変わっていない
- 未確認：この版のトレイはまだ刷っていない

## 2026-11-10（その 26）設定入りの Bambu Studio プロジェクト（A1 mini・0.4 mm ノズル）

- `3mf/bambu_a1mini/` を足した。plate 0〜4 を Bambu Studio のプロジェクトにしたもので（ファイル名は `bambu_plate0_test_coupons.3mf` のように頭に `bambu_` を付け、形だけのファイルと取り違えないようにした）、開くとプリンタ（Bambu Lab A1 mini 0.4 nozzle）、プレート（Textured PEI Plate）、フィラメント（Bambu PLA Basic、plate 4 は Bambu TPU 95A HF）、プロセス（0.20mm Standard @BBL A1M から壁 3 周・ジャイロイド・Arachne・象足補正 0.1 mm・正確な Z の高さを変えたもの）が選ばれた状態になる。あとはスライスして印刷するだけ
- ファイルに入れたのは、プリセットの名前と、変えた 5 か所の値だけ。Bambu Studio は「標準と違う項目の一覧」に無い項目を手元の標準プリセットから読むので、開始 G-code や速度・温度は Bambu の標準のまま使われる（Bambu Studio のソースの読み込み処理に合わせた。`cad/README.md` の「Bambu Studio projects」）
- 同じ 5 か所を入れたプロセスのプリセット `paperdiy_process_a1mini_04.json` も出力する（取り込んで選ぶだけの予備）
- 形だけの `3mf/plate*.3mf` と `3mf/large/` は前のまま
- **未確認**：作る側の環境では Bambu Studio を動かせないので、実際に開いての確認はまだ。開いたら 4 つの欄を確かめること（組み立て説明書 2-0）

## 2026-11-10（その 25）0.4 mm ノズルを標準に

- 作者の A1 mini を 0.4 mm ノズルで使うことにしたので、説明書の印刷設定と表を 0.4 mm ノズル優先に並べ替えた（0.2 mm ノズルの設定と推定時間は残してある）
- **0.4 mm ノズルで刷れない形がないかを確かめる検査**を `tools/print_report.py` に足した。各プレートを 0.4 mm ノズル・0.2 mm 積層・Arachne でスライスし、ノズルの通り道をモデルの断面と 1 層ずつ比べる：(1) どの断面も外側 0.3 mm が樹脂でおおわれているか（細すぎる形は刷られない）、(2) 1.5 mm より薄い所にすき間が残らないか（ツメの帯 1.1 mm、ツメ 1.0 mm、リブ 1.2 mm）
- 結果（`out/print_report.md` の「Does the 0.4 mm nozzle print everything?」）：薄い壁のすき間は 0。刷られないのは、ヒンジカバーの側面の小さなリブのいちばん低い 1 層（高さ 0.25 mm から始まるため。上の 3 層は刷られる）と、0.5 mm² 以下の点だけ。形の変更は不要だった

## 2026-11-10（その 24）全体の見直し：ヒンジの戻りを前提に、ツメの掛かりを増やし、ダンパーをやめた

蓋が閉まりきらない原因は、キーボードではなくトルクヒンジの性質だった。HG-MF08 は摩擦で止めるフリーストップ型（樹脂）で、手を離すと少し戻る。途中の角度なら少し先まで押せば済むが、閉じ位置では蓋がトレイに当たって先へ行けないので、戻った分だけ手前が浮く（軸で 1° が手前で 1.7 mm）。これを押さえるのは留めツメの仕事になる。この前提で全体を見直した。

- **留めツメの掛かりを 0.20 → 0.30 mm に**（出っ張り 0.35 → 0.45 mm）。0.20 mm はプリンタの誤差（±0.15 mm）と同じ大きさで、掛からなくなるおそれがあった。0.30 mm なら、誤差で 0.15 mm まで減っても約 2.8 N で留まる（ヒンジが押し上げる力は 0.5〜1.3 N）
- 掛かりを増やした分、たわむ帯を広く薄くした（x −14〜20・1.2 mm → x −20〜20・1.1 mm）。計算では 15.0 N/mm、開ける力 約 5.7 N、閉じる力 約 8.1 N、ひずみ 0.26 %（掛かりが 0.45 mm になっても 0.39 %）
- ツメを真ん中（x = 0）に移した。右へ 6 mm ずらしていたのは切れ目のあった頃の都合で、いまは理由がない
- **TPU のダンパーをやめた**（部品・トレイの溝・plate 4 から削除）。ヒンジの戻りで蓋はいつもツメに押し付けられているので、がたつき止めは要らず、ダンパーは押し上げる力を約 0.5 N 増やすだけだった。TPU は足 4 個だけになる
- `out/print_report.md` に「Does the lid stay shut?」を足した：ヒンジのトルクと蓋のモーメント、戻りが手前の縁を押す力、ツメが留める力（誤差込み）、開ける力、本体を押さえる必要があること
- 指掛かりは付けない（面一のまま）。開けるときは本体を押さえ、手前の合わせ目に指先を掛ける（約 6.6 N）
- ドキュメント：ヒンジの戻りと「カチッと言うまで押し込む」こと、開け方、試し刷りでの確かめ方（留まった状態で軽く押し上げても外れないこと）を書いた
- 刷り直し：蓋とトレイ（ツメの受けの位置と溝が変わる）。化粧パネルは変更なし

## 2026-11-09（その 23）留めツメの切れ目をなくした

- 切れ目で壁から切り離したツメは、切れ目の上端にひずみが集まり、そこが積層の境目と重なるので（蓋は天板を下にして刷る）、そこから折れる。その 22 で根元を太らせたが、切れ目がある限り弱点は残る
- いまは切れ目なし。ツメ（幅 12 mm・厚さ 1.0 mm、合わせ目から 2.2 mm 下）は壁と一体のまま、まわりの壁を x −14〜20 mm・天板の 2 mm 下まで内側から 1.2 mm に薄くし（端は 45° の斜面で 2.0 mm に戻る）、この帯全体が板として外へたわむ。外から見える切れ目もなくなった
- `src/latch_plate.py`（新規）で前の壁をキルヒホッフ板として解き、`build.py` のログに記録する。出っ張りの位置で 20.5 N/mm、開ける力 約 5.2 N・閉じる力 約 7.2 N、ひずみは最大 0.18 % で帯に散る（0.5 % を越えたらビルドが止まる）。薄くしない 2.0 mm の壁のままだと開ける力は約 17 N で固すぎる
- `cad/requirements.txt` に scikit-fem 12.0.2 を足した
- 時間と量はほぼ同じ（蓋 1 時間 45 分・65 g、plate 1〜3 で 3 時間 59 分・152 g、一体版 3 時間 47 分・151 g、試し刷り 21 分・8 g）
- トレイのくぼみと溝は同じなので、刷り直しは蓋（plate 1）だけ。`docs/images/latch.png`、完成予想、ドキュメントを更新

## 2026-11-09（その 22）留めツメの根元を太く、パネルのねじのボスにリブ

- **留めツメ**（`LATCH`）：前の版は厚さ 1.0 mm のまま上へ 7 mm 伸び、根元で 2.0 mm の壁に角で切り替わっていた。そこがいちばんひずむ場所で、しかも積層をまたいで曲がるので弱かった。いまは、合わせ目より上を壁の中で根元に向かって太らせ（1.0 → 2.0 mm、根元に段差なし）、切れ目を上へ 11 mm に延ばして上端を丸めた。合わせ目から下に出る長さ（2.2 mm）と幅（12 mm）は同じ。計算では、ひずみ 0.43 % → 0.22 %、外へこじって折れる力 約 3 N → 約 16 N、開ける力 4.5 → 6.2 N、閉じる力 6.2 → 8.7 N。`build.py` はテーパーの片持ち梁として積分して記録し、ひずみが 0.5 % を越えたら止まる
- **パネルのねじのボス**（`PANEL_BOSS_RIBS`）：天板から 6.3〜8.6 mm 下がる Ø6 の柱にリブがなかった。前後左右に厚さ 1.2 mm のリブを付けた。5.5 mm 以内の壁へは天井までの板でつなぎ、ほかは長さ 3 mm の三角のリブ。キットの枠、継ぎ板のくぼみ、USB-C の通り道は避け、パネルの裏から 0.5 mm 上で止める。どの向きに何を付けたかは `out/build_log.txt` に出る
- 蓋（plate 1）は 1 時間 39 分・65 g → 1 時間 45 分・66 g（0.2 mm ノズルの推定 約 9 時間 55 分）。plate 1〜3 で 3 時間 59 分・152 g、一体版 3 時間 48 分・151 g
- ドキュメントの数値と `docs/images/latch.png` を更新した

## 2026-11-09（その 21）TPU の滑り止めの足とダンパー

TPU で刷る小物を足した（plate 4、0.4 mm ノズル、4 分・1 g）。殻の構造は変えていない。

- **足**（`TPU_FEET`）：トレイの底の四隅に深さ 0.8 mm のくぼみを付け、16 × 8 mm・厚さ 1.2 mm の TPU の足を押し込む（片側 0.05 mm きつめ）。底から 0.4 mm 出る。1.2 mm 出すと、開いた蓋が 180° を越えても机に当たらず、止まる所がなくなるので低くした。蓋が机に当たる角度は 162° → 169°、閉じた高さは足込みで手前 24.2 mm・奥 26.8 mm。後ろの足は背面の縁から 0.5 mm 内側までなので、倒れないために要るキーボードの重さは 83 → 88 g にとどまる
- **ダンパー**（`TPU_DAMPERS`）：トレイの手前の縁（x = ±70）の溝に、長さ 10 mm の TPU の板ばねを入れる。中央の出っ張りが縁から 0.3 mm 出て、閉じた蓋に押されて面一になる。押し返す力は 1 個 約 0.2 N なので閉じにくくはならず（ツメの留める力は 約 4.5 N）、蓋の手前のガタを止める
- スライサーの注意：トレイの足のくぼみの天井の橋渡し（低く短いので問題なし）と、小さなダンパーのブリム。どちらも `out/print_report.md` に説明を書いた
- `tools/a1mini_tpu_040.ini`（TPU の目安用の設定）を追加し、`tools/print_report.py` で plate 4 をこの設定でスライスするようにした

## 2026-11-09（その 20）A1 mini 用の分割の継ぎ目をまっすぐに

蓋・トレイ・化粧パネルの分割の継ぎ目を、蟻ほぞ（各 3 つ）のある形から、まっすぐな突き合わせにした（`SPLIT_JOINT = "straight"`。`"dovetail"` で前の形に戻せる）。位置合わせと補強は、これまでどおり見えない側に貼る継ぎ板でする。試し刷り（plate 0）から蟻ほぞの小片をなくし、小片の番号を振り直した（ヒンジの座 1・2、留めツメ 3・4、ヒンジカバー 5・6）。plate 1〜3 は 0.4 mm ノズルで 3 時間 52 分・152 g。

## 2026-11-09（その 19）背面の合わせ目の溝を戻した

閉まりにくい原因は背面の合わせ目ではなかったので、その 18 の溝（`BACK_SEAM`）をやめ、前の形（背面の縁を R1.5 で丸める、`HINGE_EDGE_R`）に戻した。ヒンジカバーも軸から 3.6 mm の位置に戻した。壁 2.0 mm、短い留めツメ、カバーと継ぎ板のすき間はそのまま。軸が 0.3 mm 内側にずれたときに蓋とトレイが当たるのは 170° から（机に着く 162° より先）。

## 2026-11-09（その 18）壁を 2.0 mm に、背面の合わせ目に溝、留めツメを短く、カバーと継ぎ板のすき間を広く

刷って組んでみて分かったことを直した。

- **壁・天板・床を 1.2 → 2.0 mm**（`WALL`）：1.2 mm では柔らかすぎた。曲がりにくさは約 4.6 倍。外形は同じで、内側に厚くした。床が厚くなったぶんキーボードと化粧パネルが 0.8 mm 上がり、閉じた高さは手前 22.6 → 23.8 mm（奥は 26.4 mm のまま）。メス端子のねじ耳は 8.2 → 7.2 mm まで、充電ケーブルを挿したままの開く角度は 99° → 95°。化粧パネルの KEY のガードは、厚くなった天板の下で止めた
- **背面の合わせ目に溝**（`BACK_SEAM`）：ヒンジを付けると、開くときに蓋とトレイの背面の縁同士が当たった。蓋側（合わせ目から上 3 mm）とトレイ側（下 3 mm）に深さ 1 mm の溝を回した（外形は同じ、R1.5 の丸めはやめた）。ヒンジの軸がデータより 0.6 mm 内側にずれても、当たるのは机に着く 162° より先の 164°。0.9 mm でも 154° まで当たらない（`build.py` で確かめ、0.6 mm までは必須にした）。カバーは溝の上下 0.75 mm から始まるように、軸から 3.6 → 4.0 mm に
- **留めツメを短く**（`LATCH`）：長すぎた。幅 18 → 12 mm、合わせ目から下へ 3.6 → 2.2 mm、上の切り込み 9 → 7 mm、出っ張り 0.45 → 0.35 mm（合わせ目から 1.4 mm 下）。ひずみ 0.43 %（限度 0.5 % の内側）、開ける力 約 4.5 N・閉じる力 約 6.2 N は前とほぼ同じ。試し刷りのツメの小片は幅 26 mm・奥行き 12 mm にして、プレートに安定して立つように
- **ヒンジカバーと継ぎ板が大きくて入らなかった**：カバーのくぼみのすき間を片側 0.15 → 0.25 mm、つぶしリブの押し込みを 0.15 → 0.1 mm に。カバーは外の面を下にして刷るので、外の面の縁に 0.3 mm の面取りを付けた（1 層目の広がり対策）。継ぎ板のくぼみのすき間は片側 0.15 → 0.3 mm。継ぎ板の厚さは壁の半分で、蓋とトレイは 0.6 → 1.0 mm
- 印刷（0.4 mm ノズル、PrusaSlicer の目安）：plate 1〜3 で 3 時間 53 分・151 g（前は 3 時間 07 分・118 g）。0.2 mm ノズルは前の Bambu Studio の値に増え方を掛けた推定で、約 22 時間・149 g。壁が厚くなったので 0.4 mm ノズルを勧める
- 倒れないために要るキーボードの重さは 77 → 83 g（蓋側 137 g、トレイ 65 g）

## 2026-11-09（その 17）トレイにデッキを付け、キーボードをガタつかない位置に（追加部品をやめて最初から）

その 15・16 の追加部品（キーボードの化粧枠とスペーサー）をやめ、トレイそのものを直した。追加部品のファイル（plate 4・5 など）はなくなった（git の履歴には残っている）。蓋と化粧パネルは変えていない。

- キーボードの寸法を、元のトレイ（196 × 87 mm）で前後・左右とも 2 mm ほどガタつくという報告から 194 × 85 mm と推定した（`KB_SIZE`、要実測）。リブの先端をキーボードから片側 0.15 mm の所に置く（`KB_FIT`、x ±97.15・y ±42.65）
- トレイの縁と面一の厚さ 1.2 mm の天板（デッキ、`TRAY_DECK`）で、キーボードのまわりのすき間と奥の帯をふさいだ。ヒンジのボスや座は見えない。穴はリブの先端より片側 0.5 mm 大きく（195.3 × 86.3 mm）、キーボードが推定より少し大きくても、リブの先を削れば入る
- 手前と左右のデッキ（幅 2.15 mm）の下は 45° の斜面で壁につなぎ、サポートなしで刷れる。奥の帯（8.65 mm）は床から縁まで中身の詰まった形にして、ヒンジのボスと座を取り込んだ。最初は奥の帯をリブの間に橋渡しする形にしたが、スライサーが長い橋渡しを注意したのでやめた。いまはどのプレートにも注意が出ない
- リブは手前 4・奥 5（帯の面に立つ）・左右 2 ずつ。充電口の開口（x 72.9〜89.1）の上はデッキを開けてあり、プラグやスイッチに上から届く
- トレイの継ぎ板は、デッキの穴から入れられるよう、キーボードの下に収まる長さ（20 × 84.8 mm）にした
- トレイは重くなった：0.4 mm ノズルで plate 2 が 1 時間 17 分・49 g（前は 1 時間 03 分・40 g）、plate 1〜3 で 3 時間 07 分・118 g。0.2 mm ノズルは、前の Bambu Studio の値に PrusaSlicer での増え方を掛けた推定で、plate 2 が約 7 時間 05 分・46.2 g、plate 1〜3 で約 17 時間 16 分・117 g
- 倒れないために要るキーボードの重さは 74 → 77 g（重くなった分が後ろの縁の近くにあるのと、重心を形の中心で見積もるため。実際は少し軽くて済む）
- レンダリングのキーボードの仮の形を `KB_SIZE`（194 × 85 mm）と想定の厚さ 11.5 mm に合わせた

## 2026-11-09（その 16）キーボードのスペーサー（任意の追加部品）

キーボードがトレイの中で 2 mm ほどガタつくとのことなので、止めるための部品を追加した。トレイや、ほかの部品とファイルは変えていない。

- キーボードの位置を決めるリブ 11 本（手前 4、奥 3、左右の端 2 本ずつ）の先端にかぶせる小さなキャップ。キーボードに当たる幅 6 mm の面が 0.5・1.0・1.5・2.0 mm 内側に出る（`KB_SHIM`）
- 脇板 0.8 mm でリブを挟み（片側 0.05 mm）、床から 5 mm の高さ。キーボードの化粧枠の 0.3 mm 下に収まる
- 2 mm のものを全部のリブに付けても、トレイ・化粧枠・蓋・キーボードの空間（各辺 2 mm 狭めたもの）のどれとも当たらないことを `build.py` で確かめた
- ガタの半分の厚さを両側に付ける使い方を、組み立てガイドの 3-6 に書いた。前後に 2 mm なら、手前 4 本と奥 3 本に 1.0 mm
- `3mf/plate5_kb_shims.3mf`：1.0 mm × 11 と、0.5・1.5・2.0 mm × 4 ずつ（0.4 mm ノズルで約 6 分・1 g）。キーボードに当たる面を下にして刷る。小さい部品でも床に付く面が広くなるよう、面の幅を 6 mm にした

## 2026-11-09（その 15）キーボードの化粧枠（任意の追加部品）

トレイの中で、キーボードの奥の帯にヒンジのボスとリブが見えていたので、それを隠す枠を追加部品として作った。蓋・トレイ・化粧パネルと、いままでの 3MF は変えていない（ファイルも同じ）。

- 厚さ 1.2 mm の枠を、トレイのキーボードのまわりにはめる。キーボードの奥の幅 8 mm の帯と、左右・手前のすき間（枠の幅 1.4 mm）を覆う
- 上面は縁の傾いた平面より 0.4 mm 低い 1 枚の平面（奥の平らな縁の下に収まり、上面を下にして平らに刷れる）。キーボード位置決めのリブの上に乗り、リブの所は下面を逃がしてある。縁と面一のヒンジの座と留めツメの受けの所は切り欠く
- 外周の突起 12 か所（壁に 0.15 mm 食い込む）で押し込んで留める。接着は要らない
- トレイ・蓋・化粧パネル・ヒンジ・充電プラグ・キーボードの空間のどれとも当たらず、蓋を 0〜180° 回しても当たらないことを `build.py` で確かめた（`KB_BEZEL`）
- A1 mini 用は奥のリブ（x = 25）の上と留めツメのところで 2 つに分け、小さいほうを大きいほうの内側に入れ子にして 1 枚に収めた（`3mf/plate4_kb_bezel.3mf`、0.4 mm ノズルで約 6 分・3 g）。一体の版は `3mf/large/plate4_kb_bezel.3mf`
- レンダリングのキーボードの仮の形を、想定の厚さ 11.5 mm（`KB_THICK`）に合わせた。前は低く、化粧枠の下が覗いて見えていた

## 2026-11-08（その 14）0.2 mm ノズルの印刷設定と、印刷時間・PLA の量を記録

作者の A1 mini は 0.2 mm ノズルだったので、その設定と時間・PLA の量を組み立てガイドの 2 章と `cad/README_ja.md` に書いた。データは変えていない。

- 設定：Cool Plate（SuperTack）、PLA Basic、0.14mm Extra Draft @BBL A1M 0.2 nozzle に、象足補正 0.1 mm・正確な Z の高さ・Arachne を足す。化粧パネル（plate 3）はこの設定で印刷に出した
- Bambu Studio の値（準備の約 8 分を含む）：plate 0 は 1 時間 11 分・5.7 g、plate 1 は 6 時間 29 分・45.2 g、plate 2 は 5 時間 45 分・40.0 g、plate 3 は 3 時間 42 分・25.3 g。plate 1〜3 で 15 時間 56 分・110.4 g（0.4 mm ノズルの約 5.5 倍の時間で、PLA はほぼ同じ）
- 3MF には印刷設定が入っていないことと、見える面の仕上がりがプレートで変わること（テクスチャ PEI か SuperTack か）も書いた

## 2026-11-08（その 13）JLC の推奨値をやめて薄く（壁・天板・床 1.2 mm）

その 12 で合わせた JLC3DP の設計ガイドの値（壁 2 mm・すき間 0.5 mm）をやめ、A1 mini と PLA で刷る前提の薄い値に戻した。その 12 のほかの変更（トレイの殻、ヒンジのボスとリブ、面取りなし、丸みを半分、ボタンの切り欠きとガード、継ぎ板）はそのまま。

- 蓋の壁・天板とトレイの壁・床は 2.0 → 1.2 mm（`WALL`）、リブ・ガイド・ガードは 1.6 → 1.2 mm（`RIB_T`）、ヒンジのボスは Ø5.8 → Ø5.0
- すき間：キットのまわりと化粧パネルのまわり 0.5 → 0.2 mm、ヒンジカバー 0.5 → 0.15 mm、ヒンジの溝 0.4 → 0.25 mm、窓 0.5 → 0.3 mm
- 化粧パネルは 2.0 → 1.6 mm、枠の幅 1.6 → 1.2 mm、突起 0.85 → 0.45 mm。USB-C の通り道の上の天板は 1.5 → 0.8 mm
- ヒンジカバーの縁のリップ（JLC の樹脂・MJF の最小 2 mm のため）をなくし、1 mm の板に戻した（`COVER_LIP` で戻せる）
- 留めツメは厚さ 1.0 mm・出っ張り 0.45 mm・すき間 0.15 mm（位置は x = 6 のまま）。開ける力 約 4.5 N、閉じる力 約 6.3 N、ひずみ 0.37 %。トレイの手前の壁はツメの受けのところだけ元の厚さまで足してあり、溝の裏で 1.5 mm 残る（その 12 では 0.85 mm）
- 継ぎ板は壁の厚さの半分に：蓋とトレイ 0.6 mm、化粧パネル 0.8 mm（くぼみも同じ深さ）。化粧パネルが大きくなったので、分割位置を x = −75 → −74.2 に（パネル B が 173.8 mm で A1 mini に載る）
- 閉じた高さは手前 22.6 mm・奥 26.4 mm（その 12 は 24.8・26.6）、机の上で開く限界は約 162°、充電プラグを挿したままなら 99°。倒れないためのキーボードの重さは 82 → 74 g
- 印刷は、分割版 3 枚で 2 時間 53 分・109 g（その 12 は 4 時間 01 分・152 g、その前は 3 時間 29 分・139 g）、一体の版で 2 時間 40 分・109 g
- JLC3DP への頼み方の節は消した（一体の STL はそのまま使えるが、JLC の推奨値には合わせていない）

## 2026-11-08（その 12）JLC3DP の設計ガイドに合わせた薄い殻、ボタンのガード、分割版の継ぎ板

試作は A1 mini（PLA）、製品は JLC3DP に発注する前提で、作りやすさと材料の少なさを優先して作り直した。

- **JLC の FDM の設計ガイドに合わせた**：蓋の壁・天板とトレイの壁・床は 2.0 mm（`WALL`）。組み合わせる部品のすき間は片側 0.5 mm（キットのまわり `KIT_FIT`、化粧パネル `PANEL_CLR`、ヒンジカバー `COVER_POCKET_CLR`）、ヒンジの溝は 0.4 mm、リブ・ガイド・ガードは 1.6 mm、留めツメは 1.5 mm。面取りはすべてなくし、蓋とトレイの角の丸みは R6 → R3、ほかの小さな丸みも半分にした
- **トレイを薄い殻で作り直した**：元のトレイ（床・壁 3 mm、背面はヒンジの面まで約 10 mm 詰まっていた）の代わりに、同じ外形と合わせ目の、壁・床 2.0 mm の殻。キーボードは壁の内側のリブ（手前 4・奥 3・左右 2 ずつ）で元と同じ位置に収まる。元の背面の充電口の開口も同じ位置に開けた。トレイは 64 → 58 g
- **ヒンジの受けを、詰まったブロックからボスとリブに**：奥行き 9.5 mm のブロックの代わりに、溝のまわりに 2 mm の壁を回した座と、ねじ穴ごとのボス（Ø5.8、ねじ先から 1.5 mm 先まで）と、それを天板・床につなぐリブ（`HINGE_PAD`）
- 蓋とトレイの背面の、合わせ目に沿った縁を R1.5 で丸めた（`HINGE_EDGE_R`）。面取りをなくすと、ヒンジの軸が 0.3 mm 低かったときに 2° で縁同士が当たっていたため。丸めたので 170° まで当たらない
- **ボタンの切り欠きを大きく**（キットの縁から 6.5 → 8 mm、ボタンの両端から 1.5 → 3 mm 先まで）、**KEY の切り欠きの裏にガード**（厚さ 1.6 mm の壁、パネルの裏から PaperDIY の裏の高さまで、キットの縁で閉じる。`PANEL_GUARD`）。切り欠きから落ちたごみが蓋の中に入りにくい。電源の切り欠きは、開いている先が USB-C の通り道（パネルの切り欠きでもともと外とつながっている）で、メス端子の蓋 A では端子の本体の場所なので、ガードは付けない
- 化粧パネルは 2.0 mm、窓はキットの窓より片側 0.5 mm 大きく角は直角（面取りなし）、枠は幅 1.6 mm。突起は 0.85 mm（壁の内側を 0.35 mm 越える）、溝は 0.40 mm。手前の突起は KEY のガードを避けて x = −60・+26 に移した（奥は −23・+26 のまま）
- 留めツメは厚さ 1.0 → 1.5 mm、出っ張り 0.6 mm・すき間 0.3 mm、KEY のガードを避けて x = 0 → 6 に移した。開ける力 約 6 N・閉じる力 約 8.4 N・ひずみ 0.30 %。トレイの手前の壁は、溝の裏で 0.85 mm しか残らない（キーボードの寸法が分かれば詰めたい）
- ヒンジカバーは、左右の縁にリップ（幅 1 mm、1.1 mm 深く入る）を付けて奥行き 2.1 mm に。JLC の樹脂・MJF の最小 2 mm を満たす。つぶしリブは 0.5 → 0.65 mm（食い込みは 0.15 mm のまま）
- **分割版（A1 mini）の継ぎ板**：継ぎ目をまたぐ厚さ 1 mm の板を、見えない側（トレイは床の上面、蓋は天板の内側、化粧パネルは裏）に彫ったくぼみに接着する。面一に収まり、くぼみはどれも印刷で上を向くので橋渡しやサポートは要らない。トレイ 1 枚・蓋 2 枚・化粧パネル 3 枚（`SPLICE`、STL は `out/split/splice/`、各プレートに同梱）。蓋の蟻ほぞまわりの天板の厚い部分（`SPLIT_BLOCK`）はなくした。化粧パネルの分割位置は電源の切り欠きを避けて x = −72 → −75
- キーボードの厚さは `KB_THICK`（いまは 11.5 mm と仮定）で入れ、`KB_TOP_Z = TRAY_FLOOR + KB_THICK` になった
- 閉じた高さは手前 24.8 mm・奥 26.6 mm（前は 24.6・27.2）、開いたときの継ぎ目は 1〜1.5 mm（前は 0.8〜0.9 mm）、机の上で開く限界は約 160°（前は 157°）、キーボードの充電プラグを挿したままなら 95°（前は 91°）
- 印刷は、分割版 3 枚で 4 時間 01 分・152 g（前は 3 時間 29 分・139 g）、一体の版で 3 時間 46 分・151 g。蓋の壁と天板が 2 mm になったぶん蓋は 52 → 67 g、化粧パネルは 23 → 27 g に増えた。蓋の側が 142 g になり、倒れないためのキーボードの重さは 60 → 82 g
- JLC3DP への頼み方（蓋とトレイは一体の STL を FDM・PLA、化粧パネルとカバーは樹脂か MJF）を組み立てガイドの 2-5 と `cad/README_ja.md` に書いた。継ぎ板の図（`docs/images/splice_plates.png`、`docs/splice_figure.py`）を追加し、ほかの図とレンダリングを描き直した

## 2026-11-08（その 11）化粧パネルの蟻ほぞまわりの細い部分と、USB-C ガイドの修正

- 化粧パネル B の左奥の角（左のヒンジの受けの横）が、奥の蟻ほぞの受けとヒンジの受けの切り欠きにはさまれ、幅 0.2 mm ほどでしかつながっていなかったのを直した。手前の蟻ほぞと USB-C の切り欠きの間も 1.8 mm しかなかった
- パネルの蟻ほぞだけ小さくし（首 4.5・頭 7・深さ 5 mm、すき間 0.2 mm。`PANEL_DOVETAIL`）、奥のほぞを y = 40 → 36.8 に移した。ほぞのまわりの肉はどこも 2.8 mm 以上ある。蓋とトレイの蟻ほぞは変わらない
- パネルの部品を厚さの中ほどで 1 mm 削っても 1 つにつながっていること（幅 2 mm 未満の細い部分がないこと）をビルドで確かめるようにした
- USB-C のガイド（プラグの両脇の 2 本の壁）を、左端の穴の横の壁から PaperDIY の端までつなげた（前は穴から 15 mm 奥の x = −84 から始まっていた）。分割版では蓋 A と B の境目で切れるが、貼り合わせると一直線になる
- 化粧パネルの突起と溝の位置を示す図を追加した（`docs/images/panel_snap.png`、組み立てガイド 3-5）

## 2026-11-08（その 10）化粧パネルを押し込むだけで留まるように

- 化粧パネルの手前と奥の縁に、小さな突起を 2 つずつ付けた（x = −23・+26、長さ 8 mm、パネルの縁から 0.45 mm 出た 45° の山。`PANEL_SNAP`）。蓋の壁（1.6 mm）には、パネルがボスに当たる位置に深さ 0.3 mm の溝を切った。押し込むと壁が少したわんで突起が溝にパチンとはまり、ねじなしでもある程度留まる。外すときはボタンの切り欠きに爪をかけて持ち上げる。ねじ 6 本はこれまでどおり使える
- 突起は壁のリブの間（壁がたわむところ）で、留めツメ（手前の真ん中）とヒンジの受けを避けた位置。はまった状態では突起と溝は 0.05 mm 離れていて、部品同士の検査は 0 mm³
- 固すぎるときは `PANEL_SNAP["bump"]` を下げて化粧パネルだけ刷り直せる（溝の深さは `PANEL_SNAP["h"]` で決まり、蓋はそのまま）
- 変わったのは化粧パネル、蓋 B（分割版）、一体の蓋とメス端子用の一体の蓋、試し刷りの小片の一部と、それを含むプレート。蓋 A・トレイ・カバーは変わらない

## 2026-11-08（その 9）ヒンジカバーを押し込むだけで留まるように

- ヒンジカバーの左右の縁に、小さなつぶしリブを片側 2 本ずつ付けた（`COVER_RIBS`）。リブは内側の面で 0.15 mm、外側の面で 0.3 mm 出ていて、くぼみの壁に最大 0.15 mm 食い込む。押し込むだけでくぼみに留まるので、ねじを入れる前（ねじなしでも）カバーが落ちない
- リブはカバーの側に付けたので、きつさはカバーだけ刷り直して調整できる（きつい：`COVER_RIBS["h"]` を下げる、ゆるい：上げる）。蓋とトレイは変わらない
- 変わったのはカバーの STL と、カバーを含むプレート（plate 0・1・2、`large/plate1・2`）。部品同士の検査はリブを除いたカバーで 0 mm³、リブの食い込みは別にログに出す

## 2026-11-08（その 8）ヒンジカバーを面一にして、ヒンジのねじで共締め

- ヒンジカバー（厚さ 1 mm）を背面のくぼみにはめて、背面と面一にした。ヒンジの板はカバーの厚さ分（1 mm）深く沈め、軸は背面の 0.15 mm 外になった（前は 1.15 mm）。蓋を 0〜180° 回しても当たらない
- カバーに M2 の皿穴を開け、裏にヒンジの板の皿穴にはまる円すい（Ø4.1・高さ 0.7 mm）を付けた。ヒンジの M2×8 がカバーごと板を留めるので、カバーの接着が要らなくなった。ねじは今までどおり M2×8 の 14 本だけ（ヒンジ側のねじがケースに入る深さは 6 → 5 mm、ねじ先の位置は同じ）
- 開いたときの画面とキーボードの継ぎ目が 2.3〜2.6 mm から 0.8〜0.9 mm に狭まった。机の上で蓋が机に当たる角度は 160.5° → 157.3°、充電プラグを挿したまま開ける角度は 95° → 91°
- トレイ側のカバーは底まで届き、机に付く後ろの縁が y = 51 → 53 mm に下がったので、倒れないためのキーボードの重さは 76 → 60 g
- ヒンジの軸の高さはメーカーの 3D データから読んだ値なので、ずれたときの検査をビルドに足した（軸が 0.15 mm 内側でも 180° まで当たらず、0.3 mm 内側だと 168° で当たる。机の上の限界 157° より先）
- カバーを 2 mm にすると JLC など印刷サービスの最小 2 mm を満たすが、面一にすると軸が背面の内側に入って蓋とトレイの縁がぶつかるので、1 mm のまま自分で刷る
- 蓋とトレイ（plate 1・2、一体の版とメス端子用の一体の蓋、試し刷りのヒンジの小片）を作り直した。分割版のメス端子用の蓋 A と化粧パネルは変わらない。ヒンジの図とレンダリングを描き直し、組み立て手順（3-4 でヒンジとカバーを一緒に付ける）と倒れやすさの表を更新した

## 2026-11-08（その 7）ドキュメントの整理

- README を入口として作り直した：特徴、作り方の流れ、文書の一覧、リポジトリの構成、まだ確かめていないこと、ライセンス
- 英語の `cad/README.md` から前の設計（基板をそのまま載せる版）の説明を `cad/README_bare.md` に分け、今の設計のヒンジ、充電口、印刷、部品、実物で測ること、検査の内容を書き足した。目次を付けた
- `firmware/README.md`：実機で動いていることを反映し、ブラウザ（ESP Tool）での書き込み方と「困ったとき」の表（画面の向き、キーボード、SSH のエラー、文字化け、設定が消える）を足した
- `docs/README.md` を追加（画像と描くスクリプトの一覧）。組み立てガイドの確認項目を、確かめ終わったものに合わせて更新した
- Markdown のリンクと見出しへのリンクをすべて確かめた

## 2026-11-08（その 6）大きいプリンター用の一体の版

- 造形範囲が 220 mm 角以上のプリンター（Bambu Lab A1・P1・X1 など）向けに、蓋・トレイ・化粧パネルを分割しない一体の版を追加した（`3mf/large/`、STL は `out/whole/`）。蟻ほぞの貼り合わせが要らず、継ぎ目も出ない。3 枚で約 3 時間 15 分・138 g（分割版は 3 時間 28 分・140 g）
- 一体の蓋には、分割した蓋で蟻ほぞを受けるための天板の厚い部分を付けない（蓋 51 g）。PrusaSlicer の「浮いた橋渡しの支点」の注意も出なくなった
- メス端子用の蓋も一体の版を用意した（`3mf/large/usb_variants/`）。一体の部品は、検査済みの部品から材料を減らしただけであることをビルドで確かめ、メス端子との当たりも一体の蓋で検査している
- 分割版で後から蓋 A を刷り替えたいときは、蓋の蟻ほぞを接着しなくてよいことを組み立て手順に書いた（蓋 A は化粧パネルのねじでパネルに留まり、パネルは蓋 B にも留まる）

## 2026-11-08（その 5）公開と MIT ライセンス

- リポジトリを公開した。ソースコードと文書は MIT ライセンス（`LICENSE`）。筐体の 3D データとそれを描いた画像（`cad/out/`、`cad/3mf/`、`cad/renders/`、`docs/images/`）は phone-enclosure（CC BY-NC 4.0）の改変物なので、引き続き CC BY-NC 4.0（`cad/LICENSE.md`）
- ビルド済みのファームに入っているライブラリの著作権表示とライセンス本文を `firmware/prebuilt/THIRD_PARTY_NOTICES.md` にまとめた
- README を今の状態に合わせて更新した（ファームの実機での確認、英語の概要、ライセンス）

## 2026-11-08（その 4）化粧パネルに USB-C プラグの切り欠き

- 化粧パネルの、USB-C プラグの通り道（蓋の左端から PaperDIY の端子まで）の上を、ボタンと同じように切り欠いた（幅 13.2 mm、パネルの左端に 2.2 mm の枠を残す。`PANEL_USB_SLOT`）。直接挿すときはプラグが端子に入るのを見ながら指で押し込め、メス端子の蓋 A のときは延長ケーブルのオス側をパネルを外さずに抜き差しできる
- 切り欠きに当たらないよう、パネル手前の蟻ほぞを y = −36 → −37.6 に移した（パネルの縁と切り欠きの両側に 1.8 mm ずつ残る）
- 化粧パネルは 24 → 23 g、本番 3 枚で約 140 g。蓋側が 126 g になり、倒れないためのキーボードの重さは 76 g。刷り直すのは化粧パネル（plate 3）だけ
- 部品同士の検査はすべて 0 mm³。取り付け図とレンダリングを描き直した

## 2026-11-08（その 3）ファーム 0.3.2：SSH の接続エラーをくわしく出す

- SSH が「Connection reset by peer」で失敗した。この英語は TCP の接続を断られたときにしか出ないが、どこへつなぎに行ったのかが画面にもログにも出ていなかった
- 接続先の IP とポート、この端末の IP を、接続中の画面とエラーとシリアルログに出すようにした。TCP で断られたときは「サーバーが TCP の接続を拒否しました（…）」、応答がないとき・経路がないときもそれぞれ日本語で出す。認証の成否と、失敗したときの libssh2 のエラー番号もログに出す
- 実機のログで、PaperDIY が Raspberry Pi ではなくルーターの 22 番につなぎに行っていたことが分かった。接続先の設定の打ち間違い（またはキーの取りこぼし）で、ファームの不具合ではなかった
- 0.3.1 の上に本体だけ（0x20000）を書いて、設定が残ることも実機で確かめた

## 2026-11-08（その 2）ファーム 0.3.1：SSH の「メモリ不足」を直した、設定を消さない更新用ファイル

- 0.3.0 で SSH に接続すると「メモリ不足」で止まった。実機の起動ログを読むと、起動直後に内部 RAM が 24 KB（いちばん大きい空きが 16 KB）しか残っておらず、Wi-Fi・Bluetooth・電子ペーパーの処理と、SSH の通信タスク（12 KB）や暗号の計算が内部 RAM を取り合っていた
- SSH の通信タスクは 1 つを使い回し、そのスタックを PSRAM に置いた。暗号（mbedTLS）の計算と、512 バイトを超える小さな確保も PSRAM へ。Wi-Fi の受信バッファを 16 → 8 にし、Wi-Fi の処理を IRAM に置くのをやめた（SSH には十分な速さ）。実機で起動直後の内部 RAM の空きは 24 KB → 57 KB（最大の塊 16 KB → 31 KB）
- それでも足りないときは、エラーに内部 RAM と PSRAM の空きを出すようにした。起動時と SSH の各段階の空きはシリアルのログにも出る
- これまでの書き込みに使っていた `paperdiy-term-merged.bin` は設定の領域も空にするので、書き込むたびにキーボードのペアリング、Wi-Fi、SSH の接続先が消えていた。更新用に本体だけの `prebuilt/paperdiy-term-app.bin`（0x20000 番地に書く）を追加し、CI と `make firmware-check` で両方を比べるようにした

## 2026-11-08 ファーム 0.3.0：ペアリング待ちのキーボードに自動でつなぐ

- キーボードがつながっていない間は、Bluetooth の処理が数秒ごとに周りを調べ、ペアリング待ちのキーボードがあれば自分で接続を始めるようにした。画面に 6 桁の数字が出たら、キーボードで打って Enter を押すだけで済む（ボタンで検索・選択しなくてよい）
- 選ぶ条件は、検出可能（ペアリング待ち）の広告を出していること、HID サービスかキーボードの外見（appearance）を出していること（マウスなどは除く）、電波の強さが −80 dBm 以上であること。限定検出（ペアリングボタンを押した状態）のものを優先し、次に電波の強いものを選ぶ
- 登録済みのキーボードがキーを押して戻ってきたときは、そちらが優先。数字が打たれずに失敗したキーボードは 2 分間、メニューで登録を解除したキーボードは 5 分間、自動では選ばない
- 接続画面に、自動でつなごうとしているキーボードの名前と、打つ数字を表示する。ボタンA で一覧から選ぶ方法もそのまま使える
- 実機の PaperDIY に書き込み済み（キーボードとの接続はまだ確認していない）

## 2026-11-07（その 7）ファーム 0.2.1：画面の向きを筐体に合わせた

- 実機の PaperDIY に 0.2.0 を書き込んだところ、起動して画面も出たが、USB-C を左にした向き（筐体に入れたときの向き）で上下が逆だった
- 横向きにする回転を逆にして、USB-C が左・KEY ボタンが上で正しく見えるようにした（`main/term/renderer.cpp`）。メニューの「画面の上下反転」はこれまでどおり使える
- バージョンを 0.2.1 にして `prebuilt/` を差し替えた（ESP-IDF v5.5.6、SHA-256 は `prebuilt/SHA256SUMS`）

## 2026-11-07（その 6）中空の蓋と化粧パネル、USB-C の付け替え、色の完成予想図

**蓋を中空にして、化粧パネルで押さえる**
- 蓋を、壁 1.6 mm・天板 1.2 mm の中空の殻にした（`KIT_LID = "shell"`、新しい標準）。内側には、ヒンジの受け、化粧パネルのねじのボス 6 本、キットの裏を受けるリブ 3 本、USB-C プラグの案内、蟻ほぞの受けを付けた。plate 1 は 2 時間 45 分・87 g → 1 時間 18 分・52 g
- 前の設計と同じように、画面の窓のある化粧パネル（厚さ 1.6 mm、`PANEL_*`）を付けた。裏の枠（高さ 2.0・幅 1.2 mm）が PaperDIY のまわりに入り、M2×8 皿タッピングねじ 6 本で蓋のボスに留める。PaperDIY はパネルとリブの間に挟まる。天面からの M2×4 のねじはなくなり、ねじは M2×8 の 14 本だけになった
- KEY1・KEY2 と電源は、パネルの切り欠きから指で直接押せる
- 化粧パネルも 2 分割して蟻ほぞで貼る（`plate3_panel.3mf`、35 分・24 g）
- 化粧パネルのぶん PaperDIY が 1.6 mm 上がったので、蓋の厚さは手前 16.6 mm・奥 14.2 mm、閉じた全体は手前 24.6 mm・奥 27.2 mm（その 5 は 23.1・27.2 mm）。奥はヒンジで決まるので変わらない。キーボードの厚さを測って入れれば、手前はさらに下がる
- 中まで詰まった蓋は `KIT_LID = "solid"` で今も作れる

**USB-C**
- 標準は、左端の穴（13 × 7.6 mm）からまっすぐなプラグを直接挿す。案内のリブが PaperDIY の端子まで導き、挿したまま閉じられる。プラグの上の天板は 0.8 mm（`USB_CEIL`）
- あとからパネルマウントのメス端子に替えられるように、蓋 A（左端の小片）だけを替える版を作った（`3mf/usb_variants/`、ねじ間隔 16・18・20・22・25・28・30 mm とねじなし）。開口は左端の奥寄り（y = 20、`USB_PM_Y_KIT`）。ねじ耳と本体の高さ 7.8 mm までの端子が化粧パネルと天板の間に入ることと、蓋 B が変わらないことをビルドで確かめている

**そのほか**
- 本番は plate 1〜3 の 3 枚で約 3 時間 28 分・141 g（その 5 は 2 枚で約 4 時間 20 分・151 g）。試し刷りは約 22 分・9 g
- 蓋側は 127 g になり、倒れないためのキーボードの重さは 77 g（その 5 は 82 g）
- 部品同士の検査に、化粧パネルと蓋・トレイ・キット・USB-C プラグ・キーボードの空間、メス端子と蓋・パネル・キットを追加。すべて 0 mm³。蓋を開く検査は化粧パネルごと回している
- 完成予想図を、黒だけ・カーキだけ・ミックス（蓋がカーキ、トレイと化粧パネルが黒）の 3 通りで描くようにした（`docs/images/render_{open,closed}_{black,khaki,mix}.png`）
- PrusaSlicer の「浮いた橋渡しの支点」の注意（蓋 B）は、ヒンジの受けのブロックの中で天板を橋渡ししているだけで問題ないことを、スライスした層で確かめた

## 2026-11-07（その 5）PaperDIY をケースごと入れる薄い蓋、留めツメ、背面のすき間をなくした

**PaperDIY をケースごと**
- PaperDIY は Complete Kit のケースに入れたまま組み込むことにした（`PD_MOUNT = "kit"`、新しい標準）。寸法は M5Stack が公開している 3D データ（M5_Hardware の K159-B、ケース 120.0 × 67.0 × 6.3 mm）から読み、`src/params.py` に出典付きで書いた
- 蓋は、元の蓋の外形・合わせ目・角の丸みに合わせた、中まで詰まった新しい部品にした。内側の面にキットのくぼみ（まわり 0.2 mm）があり、天面から M2×4 皿小ねじ 1 本をキットの基板のスタンドオフに入れて留める（キットに 2.2 mm 入る。M5Stack の指定は 3 mm 未満）
- ボタンは、KEY1・KEY2 と電源のキャップの前に指の入る切り欠きを付けて直接押す。押し棒はなくなった
- USB-C は、蓋の左端から端子まで、まっすぐなプラグが入る溝を付けた。パネルマウントの延長ケーブルと、ねじ間隔ごとの蓋 A は要らなくなった
- 電池は内蔵の 140 mAh のまま（足りなければモバイルバッテリー）。2000 mAh の電池・電池枠・画面パネル・ストラップ・天面プレートはなくなった
- 蓋の内側の面は、キーボードの上 0.5 mm の高さ（`KB_TOP_Z`、いまは元の蓋と同じキーボード厚さ 11.5 mm を想定）。天面は、背面でヒンジの板とカバーが収まる高さと、USB-C の溝の上に 1.2 mm 残る高さを通る平面にした。蓋の厚さは手前 15.2 mm・奥 14.1 mm、閉じた全体は手前 23.1 mm・奥 27.2 mm（前は 30 mm）。キーボードの厚さを測って入れれば、さらに下がる
- 蓋の天面は傾いた平面なので、3MF では天面がプレートにぴったり付くように傾きを直して並べた

**磁石なしの留めツメ**
- 蓋の手前の壁の真ん中に、幅 18 mm・厚さ 1 mm のツメを切り出し、トレイの手前の面にくぼみと溝を付けた。閉じるとツメの出っ張り（0.45 mm）が溝に落ちてパチンと留まり、蓋の手前を持ち上げると外れる。計算では開ける力 約 4.5 N、閉じる力 約 6 N、ひずみ 0.37 %。実際の開く弧に沿ったたわみ（最大 0.29 mm）も検査に入れた
- 留め磁石・穴あけジグ・留めクリップはなくなった（plate 4・5 を削除）

**開いたときのすき間**
- 背面の壁を、ヒンジの裏だけでなく全幅で 9.5 mm にして、背面全体をヒンジの板と同じ面にそろえた（`BACK_STYLE = "solid"`、蓋とトレイ）。ヒンジの間で蓋の下の縁が軸から 7.65 mm 手前にあったため、開くと縁がトレイから浮き、画面とキーボードの間に 11〜15 mm のすき間が開いていた。いまは 2.3〜2.6 mm。ヒンジの部品は同じ
- そのかわり、キーボードの充電ケーブルを挿したままだと、蓋は 95° までしか開かない（前は 119°）

**そのほか**
- 試し刷り（plate 0）を、ヒンジ・蟻ほぞ・留めツメ・カバーに入れ替えた（約 25 分・11 g）
- 本番は plate 1・2 の 2 枚で約 4 時間 20 分・151 g（前は 3 枚で約 4 時間 50 分・179 g）。蓋が軽くなり、倒れないためのキーボードの重さは 82 g（前は 156 g）
- キーボードがトレイの中で動くので、寸法（`KB_SIZE`）を入れると内壁にパッドが付くようにした（測るまでは付かない）
- 図を入れ替えた（PaperDIY の入れ方、留めツメ）。前の設計の図（ストラップ、押し棒、磁石、クリップ）と、その図を描くスクリプトは削除
- 古い出力が残らないよう、`build.py` と `export_3mf.py` は作る前に出力フォルダの STL・PNG・3MF を消すようにした
- 前の設計は `PD_MOUNT = "bare"`（または環境変数 `PD_MOUNT=bare`）で今も作れる。組み立て手順はコミット `7b0e57d` の版にある

## 2026-11-07（その 4）押し棒が抜け落ちないようにした

- 押し棒はつばで外へ抜けないだけで、内側へは何も止めていなかったので、パネルを入れる前に蓋を傾けると穴から落ちていた。パネルの U 字の受けに合わせながら入れるのも難しかった
- 押し棒の外側の先を縦の切れ目（幅 1.0 mm・長さ 7.5 mm）で 2 つに割り、それぞれに爪を付けた。蓋の内側から押し込むと、2 つの爪がすぼまって φ3.4 の穴を通り、壁の外 0.9 mm のところでパチンと開いて留まる。壁をつば（内側）と爪（外側）ではさむので、パネルを入れる前でも抜け落ちない
- 爪は、穴と同じ半径の円を軸から 0.35 mm ずらした形にした。すぼめるとちょうど穴に収まり、検査でもはみ出しは 0。曲げのひずみは約 1.2 %（穴が 0.1 mm 小さく刷れた場合）。割った部分は上も平らにして、スライサーで片側ずつ 1 mm の 1 周になることを G-code で確かめた
- 爪と壁の間の 0.9 mm が、ボタンを押せる量になる（前はつばがパネルの受けに当たるまでの 0.7 mm）。つばは 1.2 → 0.8 mm に薄くして、いちばん奥まで押し込んでも KEY のつばがパネルの受けに当たらないこと（0.2 mm あく）を検査に追加した
- 押し棒は外から見て 2 mm ほど出る（前は 1 mm）。外から見て切れ目が縦なら、平らな面がパネル側を向いている
- 外すときは、外に出た先をつまんで爪をすぼめ、内側へ押し戻す
- 変わったのは押し棒 3 本（plate 3）だけ。蓋とパネルは刷り直さずにそのまま使える
- 組み立てガイドに手順と図（`docs/images/pushrod_snap.png`）を追加。試し刷りの押し棒も同じ形になったので、plate 0 で留まり方を先に確かめられる

## 2026-11-07（その 3）ストラップに基板の回り止めと、電子ペーパーの押さえを追加

- PaperDIY Assembly Kit の基板は画面の裏に載っているだけで、ストラップのねじ 1 本（基板のスタンドオフ）でしか留まっていなかったので、そのねじを中心に回ることがあった
- ストラップから腕を 2 本出し、その先の脚を基板の画面中央寄りの端のすぐ外（0.2 mm）に立てた。脚は基板の左右に 1 本ずつで、基板は回れない。脚の先は画面の裏から 0.2 mm 浮かせ、ESP32 モジュールと、真ん中を通る電池のケーブルを避けている
- 部品同士が当たらない検査はすべて 0 mm³。変わったのはストラップ（plate 3）だけなので、ストラップを刷り直せば今の部品に使える
- 腕はそのまま右へ伸ばし、電子ペーパーの右端の近く（端から 3.5 mm）まで届くリブ付きのレール 2 本にした。足（x = 18 と 49）で画面の裏を押さえるので、画面の右側も浮かない。電池のケーブルはレールの間を通る
- ストラップがほぼ正方形になったので、plate 3 は部品の位置を手で決めるようにした
- ストラップが 3 g ほど重くなったぶん、倒れないためのキーボードの重さは 156 g（前は 152 g）、本番 3 枚は約 179 g・4 時間 50 分

## 2026-11-07（その 2）留め磁石（後づけ）

- 閉じた蓋を留めるしくみとして、蓋とトレイの前の壁が合わさる面に φ2×3 mm のネオジム磁石を 4 組埋める方法を追加した。刷った部品に φ2 の穴を 8 か所あけて磁石を接着するだけで、部品の刷り直しは要らない
- 穴の位置がずれないように、前の壁をまたいで側面に当てる穴あけジグ（L・R、`3mf/plate5_magnet_jigs.3mf`、約 17 分・8 g）を用意した。蓋とトレイで同じジグを使うので、閉じると穴が向かい合う。ジグが蓋・トレイに当たらないこと、穴が壁の中に収まること（外側に 0.7 mm 残る）を検査に追加
- 保持力の見積もりは前の縁で約 8 N（ヒンジの 5 倍ほど）。強すぎるときは 2 組に減らせる
- これから刷る人向けに、`MAGNET_HOLES = True` で穴を最初からあけた蓋とトレイを作れるようにした（既定は `False` なので、今のデータは変わらない）
- 組み立てガイドに手順（3-4）と図を追加。以降の節番号を 1 つずつ繰り下げた

## 2026-11-07 留めクリップを追加（任意）

- トルクヒンジは閉じた位置で止まるだけで、かばんの中では蓋が開くことがあるので、閉じたケースの手前の縁に差し込むクリップを追加した（`3mf/plate4_front_clip.3mf`、2 個、約 10 分・4 g）。ほかの部品は 1 バイトも変わらないので、刷り直しは要らない
- 形は、閉じた蓋とトレイの手前の断面（前面と上下の 3 mm の面取り）に 0.1 mm のすき間で沿わせた U 字。内側の出っ張り（0.2 mm）が蓋の天面とトレイの底を押さえて、ずれないようにする。手前の縁のどこに付けても蓋・トレイ・押し棒に当たらないことを、5 か所で検査した（KEY の押し棒の上だけは避ける）
- 組み立てガイドに、PaperDIY の留め方、ヒンジのねじ、試し刷りの小片の図を追加

## 2026-11-05 背面の壁を薄くして、リブで補強した

- 背面の壁を元の作品と同じ 3 mm に戻し、ねじが要るヒンジの裏（幅 27 mm）だけを奥行き 9.5 mm の「ヒンジ受け」にした。ヒンジ受けの両側は斜めのリブ（長さ 5.5 mm）で壁になだらかにつなぐ
- 蓋の中に、長い壁と天板の角をつなぐ三角のリブを 14 枚追加（厚さ 1.6 mm、天板側 7 mm・壁側 7.5 mm）。ストラップ・押し棒・USB-C ケーブルを避けた位置で、画面パネル・PaperDIY・電池・押し棒と当たらないことを検査で確認
- 奥行きは 99.5 → 93 mm（ヒンジ受けのところだけ 99.5 mm）。蓋とトレイの体積は 13 % 減ったが、印刷する PLA は 183 → 175 g、時間は 4 時間 50 分 → 4 時間 40 分。厚い壁の中はもともとインフィル 15 % で刷られていたので、重さが減るのは外形が小さくなったぶんだけ
- 背面の充電口のくぼみは、壁が元の 3 mm に戻ったので不要になり削除。充電ケーブルを挿したままでも 119° まで開く（前は 95°）
- 机に当たる角度の計算を、頂点を間引かずに 0.1° 刻みで行うようにした：約 150°（前の 154° は間引きによる誤差）。倒れないためのキーボードの重さは 152 g
- 壁のループ数を 2 にした場合の目安（plate 1〜3 で約 163 g）を組み立てガイドに追加
- 3MF を作り直した。ねじ間隔ごとの蓋 A も変わったので、新しいものを使う

## 2026-11-04 ヒンジの軸の位置を実物の形で計算し直した

- スガツネのサイトの 3D モデルで HG-MF08 の形を確かめた：裏は平らで、筒（約 5.5 mm）は表側にだけ出ており、軸は裏から約 3.2 mm。溝に付けると軸は背面から約 1.1 mm 外に来る
- 開閉・倒れやすさ・充電プラグの検査と完成予想の図を、この軸で回すように直した。印刷するデータ（STL・3MF）は変わらない
- 結果：蓋を 0〜180° 回しても部品は当たらない（前は 155° でカバー同士が当たる計算）。机に当たるのは約 154°。充電ケーブルを挿したままでも 95° まで開く。倒れないためのキーボードの重さは 153 g（前は 143 g）
- 組み立てガイドに、ヒンジを付ける向き（平らな面を溝の底に、筒を外に）と、試し刷りのヒンジ小片で 150° 以上開くかを確かめる手順を追加

## 2026-11-03（その 3）筐体・作りやすさ・書類・再現性

**筐体**
- キーボードの充電口：背面を 9.5 mm に厚くしたせいで深いトンネルになっていた開口に、外側からくぼみを付けて元の作品と同じ条件に戻した。プラグを挿したままでは蓋が 90° までしか開かないことを、モーションの検査で確かめて書類に書いた
- USB-C パネルマウント：取り付け穴のある蓋 A（左端の小片）を、ねじ間隔 16 / 18 / 20 / 22 / 25 / 28 / 30 mm と穴なしの 8 種類用意した。耳が当たる内側のフィレットを平らにし、各版でコネクタの外形と蓋・パネル・押し棒が当たらないことを確かめる検査を追加。位置を y = +2 → +1 に移し、30 mm でも電源の押し棒に当たらないようにした
- 押し棒：底の平らな面を 1.8 → 2.4 mm に広げ（プレートからはがれにくくする）、パネルの受けを合わせて上げた
- 倒れやすさの見積もり：蓋を開いたときに後ろに倒れないためのキーボードの重さを角度ごとに計算（143 g 以上ならどこまで開いても倒れない）

**作りやすさ**
- 試し刷りプレート（`plate0_test_coupons.3mf`、約 30 分）：ヒンジの座、蟻ほぞ、パネルの角のねじ、押し棒の穴を本番の部品から同じ向きで切り出した
- `tools/print_report.py`：PrusaSlicer で全プレートをスライスして、時間・重さ・スライサーの安定性の警告を出す。壁の厚さと倒れやすさも計算する
- Bambu Studio の設定：ブリムを「なし」から「自動（標準）」に

**再現性**
- 元データ（phone-enclosure）をコミット `a21bfd6` と STL の SHA-256 で固定。違うものではビルドが止まる。`cad/tools/fetch_original.sh` で取得
- Python のパッケージ（`cad/requirements.txt`）、npm パッケージ（`docs/render/package-lock.json`）を固定
- 筐体の出力が同じ PC では 1 バイトも違わずに再現することを確認（1 CPU でも同じ）。3MF の zip の日時を固定。全出力の指紋を `cad/out/MANIFEST.json` に記録し、`make verify` で比べる（別の PC では丸めでバイトが変わるファイルがあるので、形が 0.01 mm / 0.01 % 以内なら一致とする。GitHub Actions では 32 / 44 がバイト一致、12 が形だけ一致）
- ファーム：ESP-IDF を v5.5.6（タグ）に固定し、`CONFIG_APP_REPRODUCIBLE_BUILD=y` とバージョン 0.2.0 で再現可能ビルドに。別のフォルダで 2 回、新しく clone したリポジトリで 1 回、GitHub Actions の `espressif/idf:v5.5.6` コンテナで 1 回ビルドし、どれも同じバイナリになることを確認。`prebuilt/` を差し替えて `SHA256SUMS` と `BUILDINFO.md` を追加。sdkconfig.defaults から ESP-IDF 5.5 に存在しない設定 2 つを削除（バイナリは変わらない）
- 端末エミュレータのホスト上テストを `firmware/test/host/` に入れた（AddressSanitizer・UBSan 付き、`make test`）
- ルートの `Makefile` と GitHub Actions（`.github/workflows/build.yml`）

**書類**
- 分解図（番号付き）とヒンジまわりの図を追加。部品表を CSV に
- 組み立てガイドに試し刷り、印刷時間と重さの目安、蓋 A の選び方、使うときの注意（倒れやすさ、充電中の角度）を追加
- 各 README を更新

## 2026-11-03（その 2）組み立てと A1 mini での印刷を考えた設計

- ねじを M2×8 皿タッピングと M2×4 皿小ねじの 2 種類に。インサートとダボピンをなくし、蓋の継ぎ目も蟻ほぞに
- カメラ窓を埋めた。組み立てガイド（`cad/ASSEMBLY_ja.md`）を追加

## 2026-11-03（その 1）試作

- PaperDIY 用ファーム（BLE キーボード、Wi-Fi、SSH）と、phone-enclosure を元にした筐体
- トルクヒンジ（スガツネ HG-MF08）を背面に埋め込み、カバーで隠す方式に
- A1 mini 用の 3MF、完成予想のレンダリング、ビルド済みファーム
