tsuyoshi-otake/paperdiy-pda-terminal/cad/out/build_log.txt

== layout (PD_MOUNT = 'kit': the PaperDIY Complete Kit in its own case, front face down in a pocket in the lid)
  kit pocket x -64.2..56.2, y -33.7..33.7; window centre x = 0.0
  shell lid (walls 2.0, ceiling 2.0); bezel panel z 14.00..15.60 (keyboard top 13.5 + 0.5; MEASURE the keyboard); kit front z = 15.60, back + gap z = 22.10
  lid top plane z = 24.994 + 0.02653 y, set by the hinge at the back and the kit pocket (front edge)
  lid 15.8 mm thick at the front face, 13.4 at the back; closed case 23.8 mm tall at the front, 26.4 at the back (was 30.0 / 30.0)
== building
== exports (bounding boxes are axis-aligned in the assembly frame)
  out/display_lid_usbc.stl: bbox 202.0 x 99.5 x 21.1 mm, watertight=True, winding_ok=True, bodies=1, vol=56650 mm3
  out/keyboard_tray.stl: bbox 202.0 x 99.5 x 12.9 mm, watertight=True, winding_ok=True, bodies=1, vol=63595 mm3
  out/paperdiy_kit_envelope.stl: bbox 121.3 x 68.2 x 6.3 mm, watertight=True, winding_ok=True, bodies=1, vol=50716 mm3
  out/display_panel_kit.stl: bbox 197.6 x 96.0 x 7.9 mm, watertight=True, winding_ok=True, bodies=1, vol=19332 mm3
  out/hinge_cover_lid_x2.stl: bbox 24.2 x 1.7 x 9.9 mm, watertight=True, winding_ok=True, bodies=1, vol=224 mm3
  out/hinge_cover_tray_x2.stl: bbox 24.2 x 1.7 x 9.2 mm, watertight=True, winding_ok=True, bodies=1, vol=207 mm3
== split pieces for A1 mini (limit 175 mm)
  out/split/lid_A_left.stl: bbox 29.0 x 99.5 x 18.5 mm, watertight=True, winding_ok=True, bodies=1, vol=9091 mm3
  out/split/lid_B_main.stl: bbox 173.0 x 99.5 x 21.1 mm, watertight=True, winding_ok=True, bodies=1, vol=46268 mm3
  out/split/tray_A_left.stl: bbox 29.0 x 99.5 x 12.9 mm, watertight=True, winding_ok=True, bodies=1, vol=9856 mm3
  out/split/tray_B_main.stl: bbox 173.0 x 99.5 x 12.9 mm, watertight=True, winding_ok=True, bodies=1, vol=51979 mm3
  out/split/panel_A_left.stl: bbox 24.6 x 95.1 x 1.6 mm, watertight=True, winding_ok=True, bodies=1, vol=2783 mm3
  out/split/panel_B_main.stl: bbox 173.0 x 96.0 x 7.9 mm, watertight=True, winding_ok=True, bodies=1, vol=15693 mm3
  panel_A_left: eroded by 1 mm (visible half) -> 1 piece(s)
  panel_B_main: eroded by 1 mm (visible half) -> 1 piece(s)
== splice plates for the split pieces (tray 1 mm, lid 1 mm, panel 0.8 mm; glued from the hidden side into pockets in both halves)
  out/split/splice/lid_splice_1.stl: bbox 16.0 x 11.0 x 1.3 mm, watertight=True, winding_ok=True, bodies=1, vol=176 mm3
  interference lid_splice_1 vs lid_A_left: 0.000 mm3 OK
  interference lid_splice_1 vs lid_B_main: 0.000 mm3 OK
  out/split/splice/lid_splice_2.stl: bbox 16.0 x 65.5 x 2.7 mm, watertight=True, winding_ok=True, bodies=1, vol=1048 mm3
  interference lid_splice_2 vs lid_A_left: 0.000 mm3 OK
  interference lid_splice_2 vs lid_B_main: 0.000 mm3 OK
  out/split/splice/tray_splice_1.stl: bbox 20.0 x 84.8 x 1.0 mm, watertight=True, winding_ok=True, bodies=1, vol=1696 mm3
  interference tray_splice_1 vs tray_A_left: 0.000 mm3 OK
  interference tray_splice_1 vs tray_B_main: 0.000 mm3 OK
  out/split/splice/panel_splice_1.stl: bbox 18.4 x 10.1 x 0.8 mm, watertight=True, winding_ok=True, bodies=1, vol=149 mm3
  interference panel_splice_1 vs panel_A_left: 0.000 mm3 OK
  interference panel_splice_1 vs panel_B_main: 0.000 mm3 OK
  out/split/splice/panel_splice_2.stl: bbox 18.4 x 29.0 x 0.8 mm, watertight=True, winding_ok=True, bodies=1, vol=427 mm3
  interference panel_splice_2 vs panel_A_left: 0.000 mm3 OK
  interference panel_splice_2 vs panel_B_main: 0.000 mm3 OK
  out/split/splice/panel_splice_3.stl: bbox 18.4 x 15.4 x 0.8 mm, watertight=True, winding_ok=True, bodies=1, vol=227 mm3
  interference panel_splice_3 vs panel_A_left: 0.000 mm3 OK
  interference panel_splice_3 vs panel_B_main: -0.000 mm3 OK
== lid A for a screw-ear panel-mount female USB-C (swap only lid A; room inside the end wall 7.4 mm)
  out/split/usb_variants/lid_A_left_usb_noscrew.stl: bbox 29.0 x 99.5 x 18.5 mm, watertight=True, winding_ok=True, bodies=1, vol=8671 mm3
    lid_A_left_usb_noscrew: opening 13.0 x 7.0 mm at y = 20, z = 19.3, no screw holes (glue)
  out/split/usb_variants/lid_A_left_usb16mm.stl: bbox 29.0 x 99.5 x 18.5 mm, watertight=True, winding_ok=True, bodies=1, vol=8674 mm3
    lid_A_left_usb16mm: opening 10.2 x 7.0 mm at y = 20, z = 19.3, M3 holes 16 mm apart
  out/split/usb_variants/lid_A_left_usb18mm.stl: bbox 29.0 x 99.5 x 18.5 mm, watertight=True, winding_ok=True, bodies=1, vol=8646 mm3
    lid_A_left_usb18mm: opening 12.2 x 7.0 mm at y = 20, z = 19.3, M3 holes 18 mm apart
  out/split/usb_variants/lid_A_left_usb20mm.stl: bbox 29.0 x 99.5 x 18.5 mm, watertight=True, winding_ok=True, bodies=1, vol=8635 mm3
    lid_A_left_usb20mm: opening 13.0 x 7.0 mm at y = 20, z = 19.3, M3 holes 20 mm apart
  out/split/usb_variants/lid_A_left_usb22mm.stl: bbox 29.0 x 99.5 x 18.5 mm, watertight=True, winding_ok=True, bodies=1, vol=8635 mm3
    lid_A_left_usb22mm: opening 13.0 x 7.0 mm at y = 20, z = 19.3, M3 holes 22 mm apart
  out/split/usb_variants/lid_A_left_usb25mm.stl: bbox 29.0 x 99.5 x 18.5 mm, watertight=True, winding_ok=True, bodies=1, vol=8635 mm3
    lid_A_left_usb25mm: opening 13.0 x 7.0 mm at y = 20, z = 19.3, M3 holes 25 mm apart
  out/split/usb_variants/lid_A_left_usb28mm.stl: bbox 29.0 x 99.5 x 18.5 mm, watertight=True, winding_ok=True, bodies=1, vol=8635 mm3
    lid_A_left_usb28mm: opening 13.0 x 7.0 mm at y = 20, z = 19.3, M3 holes 28 mm apart
  out/split/usb_variants/lid_A_left_usb30mm.stl: bbox 29.0 x 99.5 x 18.5 mm, watertight=True, winding_ok=True, bodies=1, vol=8635 mm3
    lid_A_left_usb30mm: opening 13.0 x 7.0 mm at y = 20, z = 19.3, M3 holes 30 mm apart
== whole parts for printers with a 220 mm bed or bigger (no split, no dovetails, nothing to glue)
  out/whole/lid.stl: bbox 202.0 x 99.5 x 21.1 mm, watertight=True, winding_ok=True, bodies=1, vol=56650 mm3
  out/whole/tray.stl: bbox 202.0 x 99.5 x 12.9 mm, watertight=True, winding_ok=True, bodies=1, vol=63595 mm3
  out/whole/panel.stl: bbox 197.6 x 96.0 x 7.9 mm, watertight=True, winding_ok=True, bodies=1, vol=19332 mm3
  out/whole/usb_variants/lid_usb_noscrew.stl: bbox 202.0 x 99.5 x 21.1 mm, watertight=True, winding_ok=True, bodies=1, vol=56230 mm3
  out/whole/usb_variants/lid_usb16mm.stl: bbox 202.0 x 99.5 x 21.1 mm, watertight=True, winding_ok=True, bodies=1, vol=56233 mm3
  out/whole/usb_variants/lid_usb18mm.stl: bbox 202.0 x 99.5 x 21.1 mm, watertight=True, winding_ok=True, bodies=1, vol=56205 mm3
  out/whole/usb_variants/lid_usb20mm.stl: bbox 202.0 x 99.5 x 21.1 mm, watertight=True, winding_ok=True, bodies=1, vol=56194 mm3
  out/whole/usb_variants/lid_usb22mm.stl: bbox 202.0 x 99.5 x 21.1 mm, watertight=True, winding_ok=True, bodies=1, vol=56194 mm3
  out/whole/usb_variants/lid_usb25mm.stl: bbox 202.0 x 99.5 x 21.1 mm, watertight=True, winding_ok=True, bodies=1, vol=56194 mm3
  out/whole/usb_variants/lid_usb28mm.stl: bbox 202.0 x 99.5 x 21.1 mm, watertight=True, winding_ok=True, bodies=1, vol=56194 mm3
  out/whole/usb_variants/lid_usb30mm.stl: bbox 202.0 x 99.5 x 21.1 mm, watertight=True, winding_ok=True, bodies=1, vol=56194 mm3
  one-piece lid 56.65 cm3 (the checked lid 56.65 cm3)
== test coupons (cut from the real parts; print these first)
  out/coupons/coupon_hinge_tray.stl: bbox 30.0 x 17.0 x 12.9 mm, watertight=True, winding_ok=True, bodies=1, vol=3219 mm3
  out/coupons/coupon_hinge_lid.stl: bbox 30.0 x 17.0 x 13.2 mm, watertight=True, winding_ok=True, bodies=1, vol=1947 mm3
  out/coupons/coupon_latch_lid.stl: bbox 44.8 x 12.0 x 18.7 mm, watertight=True, winding_ok=True, bodies=1, vol=1944 mm3
  out/coupons/coupon_latch_tray.stl: bbox 44.8 x 12.0 x 8.1 mm, watertight=True, winding_ok=True, bodies=1, vol=1734 mm3
== interference checks (closed)
  interference kit (case + caps) vs lid: 0.000 mm3 OK
  interference USB-C plug in the kit's port vs lid: 0.000 mm3 OK
  interference lid vs tray: 0.000 mm3 OK
  relief at the hinge side: the lid's underside leans up from y -40 to 0.4 mm at the back face (-0.01 at y -40, 0.16 at y 0, 0.39 at y 51). The rims would meet 1.65 mm from the hinge axis, the front edge is 60 times further out: rims 0.05 mm proud there would hold it 3.0 mm open with the hinge screws tight; now up to 0.39 mm does nothing
  interference keyboard space (tray floor 2.0 to z 13.5) vs lid: 0.000 mm3 OK
  interference keyboard space vs tray (deck, pads, hinge bosses): 0.000 mm3 OK
  keyboard room 196 x 87 mm from the floor up (the original tray's); nothing stands out of the walls, 1 mm a side at the ends and 1 mm at the front and back round the estimated 194 x 85 mm keyboard (MEASURE); deck 1.2 mm flush with the rim, 1.00 mm wide at the front and the ends (45 deg under), solid 7.50 mm behind it, open over the charge port (x 72.9..89.1)
  interference kit vs bezel panel: 0.000 mm3 OK
  interference bezel panel vs lid: -0.000 mm3 OK
  interference bezel panel vs tray: 0.000 mm3 OK
  interference USB-C plug vs bezel panel: 0.000 mm3 OK
  interference keyboard space vs bezel panel: 0.000 mm3 OK
  interference panel A vs B (straight): 0.000 mm3 OK
  interference lid_A_left_usb_noscrew: panel-mount female vs lid: 0.000 mm3 OK
  interference lid_A_left_usb_noscrew: panel-mount female vs panel: 0.000 mm3 OK
  interference lid_A_left_usb_noscrew: panel-mount female vs kit: 0.000 mm3 OK
  interference lid_A_left_usb_noscrew: panel-mount female vs the one-piece lid: 0.000 mm3 OK
  interference lid_A_left_usb16mm: panel-mount female vs lid: 0.000 mm3 OK
  interference lid_A_left_usb16mm: panel-mount female vs panel: 0.000 mm3 OK
  interference lid_A_left_usb16mm: panel-mount female vs kit: 0.000 mm3 OK
  interference lid_A_left_usb16mm: panel-mount female vs the one-piece lid: 0.000 mm3 OK
  interference lid_A_left_usb18mm: panel-mount female vs lid: 0.000 mm3 OK
  interference lid_A_left_usb18mm: panel-mount female vs panel: 0.000 mm3 OK
  interference lid_A_left_usb18mm: panel-mount female vs kit: 0.000 mm3 OK
  interference lid_A_left_usb18mm: panel-mount female vs the one-piece lid: 0.000 mm3 OK
  interference lid_A_left_usb20mm: panel-mount female vs lid: 0.000 mm3 OK
  interference lid_A_left_usb20mm: panel-mount female vs panel: 0.000 mm3 OK
  interference lid_A_left_usb20mm: panel-mount female vs kit: 0.000 mm3 OK
  interference lid_A_left_usb20mm: panel-mount female vs the one-piece lid: 0.000 mm3 OK
  interference lid_A_left_usb22mm: panel-mount female vs lid: -0.000 mm3 OK
  interference lid_A_left_usb22mm: panel-mount female vs panel: 0.000 mm3 OK
  interference lid_A_left_usb22mm: panel-mount female vs kit: 0.000 mm3 OK
  interference lid_A_left_usb22mm: panel-mount female vs the one-piece lid: -0.000 mm3 OK
  interference lid_A_left_usb25mm: panel-mount female vs lid: 0.000 mm3 OK
  interference lid_A_left_usb25mm: panel-mount female vs panel: 0.000 mm3 OK
  interference lid_A_left_usb25mm: panel-mount female vs kit: 0.000 mm3 OK
  interference lid_A_left_usb25mm: panel-mount female vs the one-piece lid: 0.000 mm3 OK
  interference lid_A_left_usb28mm: panel-mount female vs lid: 0.000 mm3 OK
  interference lid_A_left_usb28mm: panel-mount female vs panel: 0.000 mm3 OK
  interference lid_A_left_usb28mm: panel-mount female vs kit: 0.000 mm3 OK
  interference lid_A_left_usb28mm: panel-mount female vs the one-piece lid: 0.000 mm3 OK
  interference lid_A_left_usb30mm: panel-mount female vs lid: 0.000 mm3 OK
  interference lid_A_left_usb30mm: panel-mount female vs panel: 0.000 mm3 OK
  interference lid_A_left_usb30mm: panel-mount female vs kit: 0.000 mm3 OK
  interference lid_A_left_usb30mm: panel-mount female vs the one-piece lid: 0.000 mm3 OK
  panel-mount female: ears and body up to 7.2 mm tall fit between the panel and the ceiling
  panel snaps: 4 bumps (8 mm long; front edge x = -60, +26, back edge x = -23, +26) 0.25 mm past the wall on the way in, then in 0.30 mm grooves in the lid's 2.0 mm walls; seated, they touch nothing
  interference lid A vs B (straight): -0.000 mm3 OK
  interference tray A vs B (straight): -0.000 mm3 OK
  interference hinge (tray leaf + barrel) vs tray: 0.000 mm3 OK
  interference hinge (lid leaf) vs lid: 0.000 mm3 OK
  interference hinge barrel vs lid: 0.000 mm3 OK
  interference lid hinge cover 0 vs lid: 0.000 mm3 OK
  interference lid hinge cover 0 vs tray: 0.000 mm3 OK
  interference lid hinge cover 1 vs lid: -0.000 mm3 OK
  interference lid hinge cover 1 vs tray: 0.000 mm3 OK
  interference tray hinge cover 0 vs tray: 0.000 mm3 OK
  interference tray hinge cover 0 vs lid: 0.000 mm3 OK
  interference tray hinge cover 1 vs tray: 0.000 mm3 OK
  interference tray hinge cover 1 vs lid: 0.000 mm3 OK
  cover crush ribs: 2 per side edge, tapered 0.25 -> 0.35 mm over the 1 mm thickness, up to 0.10 mm into the pocket wall (pressed in: lid cover 0.06 mm3, tray cover 0.06 mm3 of rib in the wall; nothing else touches)
  the panel holds the kit: rim 2.0 mm around it (0.2 clear), ribs 0.1 mm above its back; 6 x M2x8 countersunk through the 1.6 mm panel, 6.4 mm into the bosses
  panel bosses Ø6 (pilot 1.8), 6.3..8.6 mm from the ceiling down to the panel; ribs 1.2 thick, 0.5 above the panel's back:
    (-91, -37.5): +x gusset 3.0, -x tie 5.6, +y tie 2.8, -y tie 4.6
    (91, -37.5): +x tie 5.6, -x gusset 3.0, +y gusset 3.0, -y tie 4.6
    (-91, 46): +x gusset 3.0, -x tie 5.6, +y tie 2.6, -y gusset 3.0
    (91, 46): +x tie 5.6, -x gusset 3.0, +y tie 2.6, -y gusset 3.0
    (-62, -39.5): +x gusset 3.0, -y tie 2.6
    (-62, 40): +x gusset 3.0, +y tie 5.6, -y gusset 1.6
  skin over the kit 2.00..3.79 mm, over the USB-C channel 0.98 mm
== snap (latch): a lip on a thinned zone of the front wall, no slits
  lip 30 wide, 1 thick, 2.6 below the parting, not slit: the front wall is thinned from inside to 1.1 over x -20..20 (to 2 below the ceiling, 45 deg chamfers) and bends as a plate
  no stops: every 0.1 mm the lid sits forward of its drawn position takes 0.1 mm off the engagement (tools/snap_sim.py)
  plate model (Kirchhoff, ceiling and end walls rigid, so the real wall is somewhat softer): 24.9 N/mm at the bump; engagement with the lid where it was drawn: 0.40 mm; a rigid lip on the real opening arc overlaps the tray by at most 0.39 mm (at 0.1 deg)
  peak strain 0.41 % (0.46 % if the lid is held back and the lip bends by the whole bump; x -0.1, z 19.9, 1.18 thick; across the print layers: keep < 0.5 %), spread over the zone, no slit ends; an outward pull of ~17 N at the bump reaches ~25 MPa; to open ~22.5 N at the lip (+ the hinges' friction), to close ~17.7 N
  the bump's faces as built stand at 44 deg (closing ramp) and 49 deg (catch face) to the closing direction: its profile is rooted 0.3 mm inside the lip, which steepens them from the 30 / 35 deg of LATCH. tools/snap_sim.py closes the built lid on the built tray (out/snap_sim.md)
  tray front wall left behind the recess 1.95 mm, behind the groove 1.50 mm
== hinge motion (lid + kit + panel + covers rotated about the real axis y=53.15, z=12.85; tray fixed)
  no collision with the tray from 0 to 180 deg
  on a table the lid reaches the table at 162.2 deg (opening limit)
  covers 1 mm, flush in the back face; leaves 1 mm deeper, axis 0.15 mm outside the back face
  hinge screws M2x8: head in the cover (Ø4 x 90°), cone Ø4.1 x 0.7 in the leaf countersink, 5 mm past the leaf seat, tip 1.5 mm short of the end of its boss (Ø5)
  axis 0.15 mm further in (+0.00 mm from the back face): still clear to 180 deg
  axis 0.3 mm further in (-0.15 mm from the back face): lid meets tray at 170 deg
== keyboard charge port (straight plug, overmold 12 x 6.5 mm, centred at x=81 z=8.4)
  interference charge plug vs tray: 0.000 mm3 OK
  interference charge plug vs lid (closed): 0.000 mm3 OK
  with that plug in, the lid opens to 95 deg; beyond that its back face meets the plug
== renders
