tsuyoshi-otake/paperdiy-pda-terminal/cad/tools/a1mini_pla_020.ini

# PrusaSlicer approximation of Bambu Studio "Bambu Lab A1 mini 0.4 nozzle / 0.20mm Standard / Bambu PLA Basic"
# with the two changes recommended in ASSEMBLY_ja.md (3 wall loops, 15% gyroid). Used only to estimate print time
# and filament per plate (tools/slice_estimates.py); print with Bambu Studio and its own A1 mini profile.
bed_shape = 0x0,180x0,180x180,0x180
max_print_height = 180
printer_technology = FFF
gcode_flavor = marlin2
nozzle_diameter = 0.4
filament_diameter = 1.75
filament_density = 1.24
filament_cost = 2.5
filament_max_volumetric_speed = 20
temperature = 220
first_layer_temperature = 220
bed_temperature = 65
first_layer_bed_temperature = 65
layer_height = 0.2
first_layer_height = 0.2
perimeters = 3
top_solid_layers = 5
bottom_solid_layers = 3
fill_density = 15%
fill_pattern = gyroid
top_fill_pattern = monotonic
bottom_fill_pattern = monotonic
infill_every_layers = 1
support_material = 0
brim_width = 0
skirts = 0
extrusion_width = 0.42
first_layer_extrusion_width = 0.5
perimeter_speed = 300
external_perimeter_speed = 200
small_perimeter_speed = 50%
infill_speed = 270
solid_infill_speed = 250
top_solid_infill_speed = 200
gap_fill_speed = 250
bridge_speed = 50
travel_speed = 500
first_layer_speed = 50
default_acceleration = 10000
perimeter_acceleration = 5000
external_perimeter_acceleration = 5000
infill_acceleration = 10000
solid_infill_acceleration = 10000
top_solid_infill_acceleration = 2000
bridge_acceleration = 5000
first_layer_acceleration = 500
travel_acceleration = 10000
machine_limits_usage = time_estimate_only
machine_max_acceleration_extruding = 20000,20000
machine_max_acceleration_retracting = 5000,5000
machine_max_acceleration_travel = 20000,20000
machine_max_acceleration_x = 20000,20000
machine_max_acceleration_y = 20000,20000
machine_max_acceleration_z = 1500,1500
machine_max_acceleration_e = 5000,5000
machine_max_feedrate_x = 500,500
machine_max_feedrate_y = 500,500
machine_max_feedrate_z = 30,30
machine_max_feedrate_e = 30,30
machine_max_jerk_x = 9,9
machine_max_jerk_y = 9,9
machine_max_jerk_z = 3,3
machine_max_jerk_e = 2.5,2.5
retract_length = 0.8
retract_speed = 30
complete_objects = 0
