tsuyoshi-otake/paperdiy-pda-terminal/(commit log)

2026-11-03 Initial prototype: PaperDIY firmware and printable enclosure
    - firmware/: ESP-IDF 5.5 app for M5Stack PaperDIY. BLE HID keyboard host
    (Bluedroid + esp_hidh, passkey shown on e-paper), Wi-Fi setup with saved
    networks and reconnect, libssh2/mbedTLS SSH client, xterm-subset terminal
    with partial e-paper refresh.
    - cad/: derivative of unkyulee/phone-enclosure (CC BY-NC 4.0). Lid, panel
    and tray for the PaperDIY, push-rods for its side buttons, battery bay,
    and pieces split to fit a 180 mm bed.
    Not yet tested on hardware or printed.
    Claude-Session: https://claude.ai/code/session_01HXgm54K2gU24gYTDkGnLL1
    [display_lid_usbc.stl, display_panel_paperdiy.stl, key_pushrod_x2.stl, keyboard_tray.stl, lid_A_left.stl, lid_B_main.stl, panel_A_left.stl, panel_B_main.stl]
2026-11-03 Add prebuilt merged firmware image
    firmware/prebuilt/paperdiy-term-merged.bin is the 0x0 image built from this
    commit's sources (ESP-IDF 5.5), so the board can be flashed without a
    toolchain. READMEs point to it instead of Releases.
    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
2026-11-03 Add rendered preview of the finished device to README
    docs/render/ renders the assembled cad/out STLs with three.js in headless
    Chromium (open and closed views) and crops them into docs/images/. The
    keyboard, screen contents and top plate are illustrative.
    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
2026-11-03 Add print-ready 3MF plates for the A1 mini
    cad/src/export_3mf.py turns every part into its print orientation and lays
    the parts out on 180 x 180 mm plates, one 3MF per plate, grouped by colour:
    lid, tray, panel + strap, and hinge knobs + push-rods. Each file is reloaded
    and checked (watertight, on the bed, inside the plate).
    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
    [plate1_lid.3mf, plate2_tray.3mf, plate3_panel_strap.3mf, plate4_knobs_rods.3mf]
2026-11-03 Keep 3MF build items to the core-spec attributes
    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
    [plate1_lid.3mf, plate2_tray.3mf, plate3_panel_strap.3mf, plate4_knobs_rods.3mf]
2026-11-03 Replace the knob hinge with two flush torque hinges
    The original hinge (knuckle on an axis inside a 14 mm barrel strip,
    printed threaded knob-pins, M3x40 cores, O-rings) is replaced by two
    Sugatsune HG-MF08 free-stop torque hinges recessed into the back face.
    - Hinge axis moves to the outer back edge on the parting line
    (y 50, z 12.85); the knuckle, ears and trough are removed and the back
    wall is rebuilt from its plain profile, so the case is 11 mm shallower.
    - Back walls thickened outward 3.0 -> 6.5 mm (pocket and lid interior
    unchanged) so the leaf screws have material; screw bosses inside the lid.
    - 2.0 mm mortises keep the leaves flush; a slot takes the barrel; pilot
    holes at t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
    [display_lid_usbc.stl, keyboard_tray.stl, lid_A_left.stl, lid_B_main.stl, plate1_lid.3mf, plate2_tray.3mf, plate3_panel_parts.3mf, plate3_panel_strap.3mf]
2026-11-03 Hide the hinge leaves under printed cover plates
    The flush HG-MF08 leaves on the back face are now covered by 1.0 mm
    printed plates in the case colours (lid / tray), glued onto a 1.5 mm
    land around each mortise, so only the barrels show, open or closed.
    - New outputs: hinge_cover_lid_x2.stl, hinge_cover_tray_x2.stl; added to
    3MF plates 1 and 2 (visible face down).
    - The covers stand 1.0 mm proud: a flush cover would put the axis inside
    the face and the lid wall would sweep into the tray.
    - Motion check now includes the covers: no contact up to the 150 deg
    table limit; the covers meet at ~155 deg and act as the stop.
    - HINGE_MOUNT = "parting" kept as an option (leaves folded in the par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
    [hinge_cover_lid_x2.stl, hinge_cover_tray_x2.stl, plate1_lid.3mf, plate2_tray.3mf, plate3_panel_parts.3mf]
2026-11-03 Design for assembly and A1 mini printing; add assembly guide
    - Fasteners cut to two kinds: 14x M2x8 countersunk tapping screws into
    printed 1.8 mm pilots (panel corners, strap ends, hinges) + 1x M2x4
    machine screw into the PaperDIY standoff. No heat-set inserts, dowels or
    socket screws (FASTENING = "inserts" restores inserts).
    - Lid halves now join like tray and panel: 3 glued dovetail keys in the
    ceiling instead of pads + dowels + inserts + screws.
    - Back walls 9.5 mm so M2x8 works on both hinge leaves (no lid bosses);
    every screw checked against the meshes: 4.9-5.9 mm engagement, >= 1.5 mm
    of wall left beyond each tip. Case depth 99.5 mm (original 108).
    - Palma camera window fi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
    [display_lid_usbc.stl, display_panel_paperdiy.stl, hinge_cover_lid_x2.stl, hinge_cover_tray_x2.stl, keyboard_tray.stl, lid_A_left.stl, lid_B_main.stl, panel_B_main.stl]
2026-11-03 Add test coupons, USB-C lid variants and reproducible builds
    Enclosure
    - Cut a bay around the keyboard charge port back to the original 3 mm wall;
    the thickened back wall had turned the opening into a 9.5 mm tunnel. A plug
    check shows the lid opens to 90 deg with a cable plugged in.
    - Build lid A (the only piece with the USB-C mount) for hole spacings 16-30 mm
    and without holes, square the inner fillet behind the ears, and check a
    connector envelope against the lid, panel and power rod for each variant.
    - Widen the push-rod flats for bed adhesion and raise the cradles to match.
    Manufacturability
    - plate0_test_coupons.3mf: hinge seat, dovetail, panel corner screw and rod
    bore cut f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
    [bom.csv, coupon_corner_lid.stl, coupon_corner_panel.stl, coupon_dovetail_A.stl, coupon_dovetail_B.stl, coupon_hinge_lid.stl, coupon_hinge_tray.stl, coupon_keywall_lid.stl]
2026-11-03 Record the CI results in the reproducibility notes
    On the GitHub Actions runner 32 of the 44 CAD outputs were byte-identical
    and 12 matched in geometry only (last-digit rounding on another CPU), which
    `make verify` accepts. The firmware built in espressif/idf:v5.5.6 matched
    prebuilt/ byte for byte, the fourth independent build to do so.
    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
2026-11-03 Rotate the lid about the hinge's real axis in every check
    Sugatsune's 3D model of the HG-MF08 shows a flat back and a ~5.5 mm
    barrel on the front only, its axis ~3.2 mm above the back. Seated in the
    2.05 mm mortise the axis is ~1.15 mm outside the back face, not on it.
    The motion sweep, plug check, tipping estimate and renders now use that
    axis: nothing touches from 0 to 180 deg, the table limit is ~154 deg, the
    lid opens to 95 deg with a charge cable in, and the keyboard needs 153 g
    to keep it from tipping at any angle. Printed geometry is unchanged.
    The assembly guide now says which way the hinge goes in and asks to open
    the joined hinge coupons past 150 deg before printing lid and tray.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
    [bom.csv]
2026-11-05 Slim the back wall: 3 mm with hinge housings and ribs
    Only the hinge screws need the 9.5 mm back wall, so the back wall goes back to the
    original 3 mm and each hinge gets a 27 mm wide, 9.5 mm deep housing blended into the
    wall by tapered ribs. Inside the lid, 14 triangular ribs tie the long walls to the
    ceiling, placed clear of the strap, push-rods and USB-C cable.
    - Depth 99.5 -> 93 mm (99.5 over the housings); solid volume -13 %, sliced PLA
    183 -> 175 g, 4 h 50 -> 4 h 39 min. The thick wall was mostly 15 % infill, so the
    saving comes from the smaller outside.
    - The charge-port bay is no longer needed; with the plug in, the lid opens to 119 deg
    (was 95).
    - Table-contact angle compute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
    [bom.csv, coupon_corner_lid.stl, coupon_dovetail_A.stl, coupon_dovetail_B.stl, coupon_hinge_lid.stl, coupon_hinge_tray.stl, coupon_keywall_lid.stl, display_lid_usbc.stl]
2026-11-06 Show how the hinges are screwed on
    Add docs/images/hinge_screws.png (back view of one hinge and a section through a
    pair of screws, cut from the built STLs) and docs/hinge_figure.py that draws it
    (make render). The assembly guide now says where the eight M2x8 screws go
    (through the leaf into the printed pilot holes in the hinge housings, 6 mm deep,
    1.5 mm short of the inner face), to use countersunk heads only, and to drive them
    by hand. Fix the parameter named for the hinge coupon's screw fit
    (HINGE_PILOT_D, not SCREW_PILOT_D).
    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
2026-11-06 Map the test-print plate in the assembly guide
    Add docs/images/plate0_coupons.png, a labelled top view of plate 0 drawn from the
    3MF (docs/coupons_figure.py, run by make render), with what each pair of pieces
    checks. The guide now says the coupons are not part of the finished device, and
    that the push-rod and the two hinge covers on plate 0 are the real parts, so they
    can serve as spares.
    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
2026-11-06 Show how the PaperDIY is held on the panel
    Add docs/images/paperdiy_mount.png (back of the screen panel with the PaperDIY,
    strap and screws, plus a section along the strap cut from the built STLs) and
    docs/paperdiy_figure.py that draws it (make render). The assembly guide now says
    which way the PaperDIY faces, that it sits glass-down in the 1 mm locating rim and
    is clamped by the strap, and that the centre screw engages only 1.5 mm (never
    longer than M2x5).
    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
2026-11-07 Add an optional front clip that keeps the closed lid shut
    The torque hinges hold any angle but do not latch, so the closed case can open in
    a bag. front_clip.stl is a U pushed onto the front edge of the closed case: its
    profile is the outline of the closed lid + tray (front face and 3 mm chamfers) with
    0.1 mm clearance, the lips reach 12 mm back, and a ridge near each tip presses
    0.2 mm into the lid top and tray bottom so it stays on. No other part changes:
    all existing STL/3MF outputs are byte-identical.
    - plate4_front_clip.3mf: two clips standing on their U profile (~10 min, 4 g).
    - build.py checks the clip without ridges at five places along the front against
    lid, tray and key push-rod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
    [bom.csv, front_clip.stl, plate4_front_clip.3mf]
2026-11-07 Add a retrofit magnetic catch with printed drilling jigs
    Inside the closed case there is no room for a catch, but the front walls of lid
    and tray meet on a ~1 mm land at z = 8.0. Four pairs of 2 x 3 mm magnets go into
    4 mm deep holes in that land (x = +-44, +-84; 0.7 mm skin to the front face), for
    about 8 N at the front edge, roughly five times the hinges' holding torque.
    - magnet_jig_L/R.stl (plate5_magnet_jigs.3mf, ~17 min, 8 g): straddle the front
    wall, stop against the end face, 8 mm guide bores; the same jigs fit lid and
    tray, so the holes are coaxial. build.py checks both jigs on both parts (0 mm3)
    and logs how much of each hole is in material.
    - MAGNET_HOLES (default False) pr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
    [bom.csv, magnet_jig_L.stl, magnet_jig_R.stl, plate5_magnet_jigs.3mf]
2026-11-07 Note magnet substitutes for the magnetic catch
    2 x 2 mm magnets also work (a little weaker), as do three stacked 2 x 1 mm
    magnets sold for model kits; 100-yen-shop magnets (6 mm and up) do not fit the
    3 mm wall.
    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
    [bom.csv]
2026-11-07 Stop the PaperDIY PCB turning about its single screw
    The Assembly Kit's PCB only lies on the back of the display, and the strap held it
    at its one M2 standoff, so it could turn about that screw. Two arms off the strap
    now end in legs 0.2 mm past the PCB's inner end (x = -12.1, one each side of the
    centre line), with their feet 0.2 mm above the display's back. They clear the
    ESP32 module and leave the middle free for the battery lead; all interference
    checks stay at 0 mm3. Only the strap (plate 3) changes, so reprinting the strap
    is enough for parts already printed.
    The heavier strap moves the tipping limit to 153 g and plates 1-3 to 176 g;
    docs, figure, exploded render and manifest updated.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
    [bom.csv, paperdiy_strap.stl, plate3_panel_parts.3mf]
2026-11-07 Hold down the display's far end with rails off the strap
    Nothing held the right-hand part of the e-paper, so it could lift. The strap's
    arms now carry on as two ribbed rails (6 mm wide, 1.6 mm rib) to x = 52.3, 3.5 mm
    short of the end of the glass, with feet at x = 18 and 49 standing on the display's
    back at the same height as the legs. The battery lead runs between the rails.
    All interference checks stay at 0 mm3; only the strap changes.
    The nearly square strap no longer fits the rows layout, so plate 3 is placed by
    hand (placed_layout in export_3mf.py, with bed-edge and gap checks). Plate 3 is now
    37 g / 1 h 08 min, plates 1-3 179 g, keyboard needed 156 g; docs, figure, renders
    and manife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
    [bom.csv, paperdiy_strap.stl, plate3_panel_parts.3mf]
2026-11-07 Snap the push-rods into the lid walls so they stop falling out
    The rods only had a collar inside the wall, so nothing kept them from sliding
    inward: before the panel went in they dropped out of their bores whenever the lid
    tilted, and lining all three up with the panel's cradles was fiddly.
    The outer end of each rod is now split by a vertical 1.0 mm slot (7.5 mm long)
    and each half carries a barb (ROD_SNAP). Pushed in from inside, the halves close
    up, pass the 3.4 mm bore and spring open 0.9 mm past the outer face, so the wall
    is held between collar and barbs. The barbs are circles of the bore's radius set
    0.35 mm off the axis, so squeezed together they exactly fill the bore (checked:
    0 mm3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
    [bom.csv, key_pushrod_x2.stl, plate0_test_coupons.3mf, plate3_panel_parts.3mf, power_pushrod.stl]
2026-11-07 Kit-in-case lid, built-in snap tab, and no gap at the hinge line
    The PaperDIY now stays in the Complete Kit's own case (PD_MOUNT = "kit", the new
    default). Its dimensions come from M5Stack's model (M5_Hardware K159-B, case
    120.0 x 67.0 x 6.3 mm). The lid is a new solid part that follows the original's
    outline, parting plane and corners. It has:
    - a pocket for the kit (0.2 mm clearance);
    - one M2x4 countersunk screw from the top into the kit's standoff (2.2 mm into
    the kit; M5Stack allows under 3 mm);
    - finger notches at the KEY and power caps (no push-rods);
    - a channel from the left end for a straight USB-C plug (no panel-mount cable).
    The inner face sits KB_CLR above the keyboard (KB_TOP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
    [bom.csv, coupon_corner_lid.stl, coupon_corner_panel.stl, coupon_dovetail_A.stl, coupon_dovetail_B.stl, coupon_hinge_lid.stl, coupon_hinge_tray.stl, coupon_keywall_lid.stl]
2026-11-07 Point the docs at the earlier design's commit instead of a tag
    The tag could not be pushed, so the assembly guide and changelog now name
    commit 7b0e57d.
    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
2026-11-07 Hollow lid with a bezel panel, swappable USB-C end, colour mock-ups
    - Kit lid is now a 1.6 mm shell with a 1.2 mm ceiling (KIT_LID = "shell"):
    hinge housings, six panel bosses, ribs onto the kit's back, USB-C guides,
    thick blocks around the dovetail keys. Plate 1: 87 g / 2 h 45 min -> 52 g / 1 h 18 min.
    - New bezel panel (PANEL_*): screen window, locating rim around the kit,
    finger slots for KEY1/KEY2 and power, six M2x8 countersunk screws. Split
    A/B with dovetails, plate3_panel.3mf. No more M2x4 screw: 14 x M2x8 only.
    - USB-C: straight plug through the left end (13 x 7.6, 0.8 mm ceiling over
    the plug path); lid-A variants for a panel-mount female (M3 16-30 mm or
    glue, ears up to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
    [bom.csv, coupon_hinge_lid.stl, coupon_latch_lid.stl, display_lid_usbc.stl, display_panel_kit.stl, lid_A_left.stl, lid_A_left_usb16mm.3mf, lid_A_left_usb16mm.stl]
2026-11-07 Firmware 0.2.1: landscape screen upright with the USB-C end on the left
    Flashed 0.2.0 on a real PaperDIY: it boots and draws, but upside down when
    held the way the kit sits in the enclosure (USB-C left, KEY buttons on top).
    Rotate the landscape the other way; the menu's 180-degree flip still works.
    Rebuilt prebuilt/ with ESP-IDF v5.5.6.
    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
2026-11-07 Firmware 0.3.0: pair on its own with a keyboard waiting to be paired
    While no keyboard is connected, the BLE task already scanned for the saved
    keyboard; it now also picks a nearby keyboard in pairing mode (discoverable
    flags, HID service or keyboard appearance, RSSI >= -80 dBm, limited
    discoverable first) and starts pairing, so only the passkey has to be typed.
    The saved keyboard wins when it comes back; a keyboard that failed is left
    alone for 2 min, a forgotten one for 5 min. The pairing screen shows the
    attempt and the passkey; manual selection with button A still works.
    Claude-Session: https://claude.ai/code/session_01HXgm54K2gU24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
2026-11-07 Firmware 0.3.1: fix "out of memory" on SSH login; app-only image for updates
    The boot log on the PaperDIY showed 24 KB of internal RAM free (largest
    block 16 KB) with Wi-Fi, BLE and the e-paper driver running, so the 12 KB
    SSH I/O task stack and the key exchange ran out. Keep one SSH I/O task
    with its stack in PSRAM, allocate mbedTLS and mallocs above 512 bytes from
    PSRAM, use 8 static Wi-Fi RX buffers and no Wi-Fi IRAM placement: 57 KB
    free (31 KB block) measured after start. Errors and the log now report
    the heap.
    The merged image erases NVS (0xFF between the partition table and the
    app), so every flash dropped the keyboard bond, Wi-Fi and SSH hosts. Add
    prebuilt/paperdiy-term-app.bin for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
2026-11-07 Firmware 0.3.2: show where an SSH connection goes and why it fails
    "Connection reset by peer" only comes from the TCP connect, but neither
    the screen nor the log said which address was tried. Show the target
    address, this device's IP and a Japanese reason (refused, no answer, no
    route); log every step, the auth result and libssh2's error number.
    On the PaperDIY the log showed 10.255.10.149 connecting to the router
    (10.255.10.1:22) instead of the Pi (10.255.10.21): a typo in the saved
    host. Flashed as the app alone at 0x20000; the settings survived.
    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
2026-11-07 Bezel panel: open over the USB-C plug path, like the button slots
    Cut the panel over the plug path from a 2.2 mm frame at its left edge to
    the kit (PANEL_USB_SLOT, 13.2 mm wide): a straight plug can be watched and
    pushed into the port by hand, and with a panel-mount female lid A the
    extension's inner plug goes in and out without taking the panel off. The
    front panel key moves to y -37.6 to stay clear (1.8 mm each side). Only
    plate 3 changes (23 g); all interference checks 0 mm3. Figure, renders,
    docs, report and manifest updated.
    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
    [bom.csv, display_panel_kit.stl, panel_A_left.stl, panel_B_main.stl, plate3_panel.3mf]
2026-11-07 Licence: MIT for code and docs, CC BY-NC 4.0 kept for the enclosure
    - LICENSE: MIT for the source code and documentation, with a scope note.
    - cad/LICENSE.md: the models and images derived from Un Kyu Lee's
    phone-enclosure (cad/out, cad/3mf, cad/renders, docs/images) stay
    CC BY-NC 4.0, as the original requires.
    - firmware/prebuilt/THIRD_PARTY_NOTICES.md: notices and licence texts of
    M5GFX, M5Unified, LovyanGFX, efont, libssh2 and ESP-IDF in the binaries.
    - READMEs: current status (firmware runs on a PaperDIY), English summary,
    licence sections, Esc and troubleshooting notes. Drop LAN addresses
    from the changelog.
    Claude-Sessi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
2026-11-07 LICENSE: plain MIT text so GitHub detects it
    The scope (code and docs MIT, enclosure models and images CC BY-NC 4.0)
    stays in README.md and cad/LICENSE.md.
    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
2026-11-07 One-piece lid, tray and panel for printers with a 220 mm bed
    - build.py writes out/whole/: lid (without the ceiling blocks that only
    carry the dovetail keys), tray, panel and the panel-mount lids in one
    piece. Each is asserted to be its checked part minus material; the
    panel-mount lids are also checked against the connector envelope.
    - export_3mf.py writes 3mf/large/ plates on a 220 x 220 mm bed, plus the
    panel-mount lids. print_report.py slices them: 138 g, 3 h 15 min,
    nothing to glue (split version 140 g, 3 h 28 min).
    - Docs: assembly guide 2-4, file tables, changelog; note that lid A can
    stay unglued (held by the panel screws) if it may be swapped later.
    - Manifest covers the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
    [lid.stl, lid_usb16mm.3mf, lid_usb16mm.stl, lid_usb18mm.3mf, lid_usb18mm.stl, lid_usb20mm.3mf, lid_usb20mm.stl, lid_usb22mm.3mf]
2026-11-08 Docs: README as the entry point, earlier design split out, firmware troubleshooting
    - README.md: features, steps, a table of all documents, repository map,
    open items, licence.
    - cad/README.md: the bare-kit design moves to cad/README_bare.md; the
    current design gains hinge, charge port, printing, hardware, what to
    measure and verification sections, and a table of contents.
    - firmware/README.md: runs on a real PaperDIY; flashing from the browser
    (ESP Tool); a troubleshooting table; link to the Japanese-input issue.
    - docs/README.md: what the images are and how to redraw them.
    - Assembly guide checks updated; every Markdown link and anchor checked.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
2026-11-08 Hinge covers flush in the back face, held by the hinge screws
    The 1 mm covers now sit in a pocket, flush with the back face; the leaves
    sit 1 mm deeper, so the hinge axis is 0.15 mm outside the back face (clear
    0-180 deg). A cone under each countersunk hole fills the leaf's
    countersink, so the hinge's own M2x8 screws clamp cover and leaf: no glue,
    still 14 x M2x8. The open seam narrows from 2.3-2.6 to 0.8-0.9 mm; the
    table limit is 157.3 deg, the charge-plug limit 91 deg, and the tray
    covers reach the table, so a 60 g keyboard keeps it upright. The tray's
    back-bottom chamfer is squared under each cover. build.py also checks the
    motion with the axis 0.15 / 0.3 mm further in (contact at 168 de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
    [bom.csv, coupon_dovetail_B.stl, coupon_hinge_lid.stl, coupon_hinge_tray.stl, display_lid_usbc.stl, hinge_cover_lid_x2.stl, hinge_cover_tray_x2.stl, keyboard_tray.stl]
2026-11-08 Hinge covers: crush ribs so they stay in their pockets without screws
    Two tapered crush ribs on each side edge of the flush covers (COVER_RIBS:
    0.15 mm proud at the inner face, 0.3 mm at the outer, up to 0.15 mm into
    the pocket wall) hold a cover once pressed in, before or without the
    hinge screws. The ribs are on the covers, so the fit is tuned by
    reprinting the covers only; lid and tray are unchanged. Clearance checks
    use the covers without ribs; the rib press is logged separately.
    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
    [bom.csv, hinge_cover_lid_x2.stl, hinge_cover_tray_x2.stl, plate0_test_coupons.3mf, plate1_lid.3mf, plate2_tray.3mf]
2026-11-08 Bezel panel: snap detents so it stays in without its screws
    Four 8 mm bumps on the panel's front and back edges (x -23 / +26, a 45 deg
    ridge 0.45 mm out at mid-thickness, PANEL_SNAP) pass the lid's 1.6 mm walls
    by 0.25 mm on the way in and sit in 0.3 mm grooves (0.05 clear) once the
    panel rests on its bosses. They are between the wall ribs, clear of the
    latch and the hinge housings. The grooves follow PANEL_SNAP["h"], the
    bumps ["bump"], so a tight fit is fixed by reprinting the panel only.
    The six screws are unchanged. Docs, report, figures and renders updated.
    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
    [bom.csv, coupon_hinge_lid.stl, coupon_latch_lid.stl, display_lid_usbc.stl, display_panel_kit.stl, lid.stl, lid_B_main.stl, lid_usb16mm.3mf]
2026-11-08 Panel: smaller dovetails, no slivers; USB-C guides from the end wall
    The panel's back key (y 40) and the left hinge-housing cut-out left the
    corner beside the housing on a 0.2 mm sliver, and the front key left 1.8 mm
    strips. The panel now uses smaller keys (PANEL_DOVETAIL: neck 4.5, head 7,
    depth 5) with the back one at y 36.8, so every web is >= 2.8 mm; build.py
    erodes each panel piece by 1 mm and asserts it stays in one piece. The
    USB-C guide ribs now run from the end wall, beside the opening, to the kit
    (they started 15 mm in). New figure docs/images/panel_snap.png shows the
    panel snaps; docs, report, renders and manifest updated.
    C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
    [coupon_hinge_lid.stl, coupon_latch_lid.stl, display_lid_usbc.stl, lid.stl, lid_A_left.stl, lid_B_main.stl, panel_A_left.stl, panel_B_main.stl]
2026-11-08 JLC-ready thin shells, KEY guard, splice plates for the split parts
    Designed for a PLA prototype on the A1 mini and a JLC3DP product:
    - 2.0 mm walls, ceiling and floor; 0.5 mm clearance between assembled
    parts; features >= 1.5 mm; no chamfers; corner radii halved (r 3)
    - tray rebuilt as a thin shell with keyboard-locating ribs out to the
    original inner faces; the charge-port opening kept
    - hinge pads, screw bosses and ribs instead of solid 9.5 mm housings;
    back edges along the parting rounded r 1.5 for axis tolerance
    - bigger finger slots; a guard ring behind the KEY slot
    - latch 1.5 mm thick at x = 6; covers with side lips (2.1 mm deep)
    - split pieces: 1 mm splice plates glued on the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
    [bom.csv, coupon_dovetail_A.stl, coupon_dovetail_B.stl, coupon_hinge_lid.stl, coupon_hinge_tray.stl, coupon_latch_lid.stl, coupon_latch_tray.stl, display_lid_usbc.stl]
2026-11-08 Thin A1 mini shells: 1.2 mm walls, ceiling and floor; drop the JLC values
    Back from JLC's FDM guide to values for PLA on the A1 mini; the rest of
    the redesign (shell tray, hinge bosses and ribs, no chamfers, halved
    radii, bigger slots, KEY guard, splice plates) stays.
    - WALL 2.0 -> 1.2, RIB_T 1.6 -> 1.2, hinge bosses 5.8 -> 5.0
    - clearances: kit and panel 0.5 -> 0.2, covers 0.5 -> 0.15, hinge
    mortise 0.4 -> 0.25, window 0.5 -> 0.3
    - panel 2.0 -> 1.6, rim 1.2 wide, snap bumps 0.45; USB-C ceiling 0.8
    - covers without side lips (COVER_LIP None)
    - latch t 1.0, bump 0.45, clr 0.15 (x = 6 kept)
    - splice plates half the wall (0.6 lid/tray, 0.8 panel), per-part t;
    panel split at x = -74.2 so pan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
    [bom.csv, coupon_dovetail_A.stl, coupon_dovetail_B.stl, coupon_hinge_lid.stl, coupon_hinge_tray.stl, coupon_latch_lid.stl, coupon_latch_tray.stl, display_lid_usbc.stl]
2026-11-08 Docs: 0.2 mm nozzle print settings, times and PLA use
    The author's A1 mini has a 0.2 mm nozzle. Record the settings used for
    the panel (0.14mm Extra Draft for the 0.2 nozzle on the SuperTack
    plate, plus elephant-foot 0.1, precise Z height, Arachne) and Bambu
    Studio's times and masses for plates 0-3 (plates 1-3: 15 h 56 min,
    110.4 g), next to the 0.4 mm nozzle estimates. No geometry change.
    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
2026-11-09 Optional keyboard bezel that hides the tray's ribs and hinge bosses
    A 1.2 mm frame laid into the tray around the keyboard, as an add-on:
    the lid, tray, panel and existing plates are byte-identical.
    - top is one plane 0.4 mm under the rim's slope (under the flat rim at
    the back, prints flat); rests on the keyboard ribs via notches;
    cut-outs at the hinge pads and the snap tab's pad; 12 press-fit
    bumps (0.15 mm into the walls)
    - checked against tray, lid, panel, keyboard room, charge plug, hinge
    and covers, and the lid swept 0-180 deg
    - A1 mini: split on the back rib x = 25 and at the snap tab; piece B
    nested inside piece A on plate4_kb_bezel.3mf (~6 min, 3 g);
    one piece in 3mf/larg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
    [bom.csv, kb_bezel.stl, kb_bezel_A_left.stl, kb_bezel_B_right.stl, keyboard_bezel.stl, plate4_kb_bezel.3mf]
2026-11-09 Optional keyboard shims that take up the keyboard's play
    Caps slid over the ends of the 11 keyboard-locating ribs, as an add-on
    (the tray and all other parts are unchanged): a 6 mm wide face 0.5,
    1.0, 1.5 or 2.0 mm thick against the keyboard, 0.8 mm side walls that
    hug the rib, 5 mm tall (under the keyboard bezel).
    - checked with 2 mm shims on every rib against tray, bezel, lid and the
    keyboard's room shrunk by 2 mm
    - plate5_kb_shims.3mf: 11 x 1.0 mm and 4 each of 0.5 / 1.5 / 2.0 mm,
    face down, no slicer warnings (~6 min, 1 g)
    - docs: BOM 16, assembly 3-6 (half the play on each side), English
    section, checklist, changelog; render of the shims on the ribs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
    [bom.csv, kb_shim_0.5mm.stl, kb_shim_1.0mm.stl, kb_shim_1.5mm.stl, kb_shim_2.0mm.stl, plate5_kb_shims.3mf]
2026-11-09 Tray deck and a play-free keyboard fit, built in (no add-on parts)
    Replaces the optional keyboard bezel and shims with the tray itself:
    - KB_SIZE 194 x 85 mm (estimate from the reported ~2 mm play in the
    original 196 x 87 room; MEASURE); ribs stand KB_FIT 0.15 mm off it
    (x +-97.15, y +-42.65): 4 front, 5 back, 2 per end
    - TRAY_DECK: 1.2 mm face flush with the rim; opening 0.5 mm larger than
    the rib faces (file the ribs if the keyboard is a bit bigger); 45 deg
    fillet under it along the front and end walls; behind the keyboard a
    strip solid from the floor up (takes in the hinge bosses and pads);
    open over the charge-port opening
    - the deck is carved out of the cavity (its top is th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
    [bom.csv, coupon_dovetail_A.stl, coupon_dovetail_B.stl, coupon_hinge_tray.stl, coupon_latch_tray.stl, kb_bezel.stl, kb_bezel_A_left.stl, kb_bezel_B_right.stl]
2026-11-09 2.0 mm walls, back seam groove, shorter snap tab, looser covers and splices
    From printing and assembling the 1.2 mm version:
    - WALL 1.2 -> 2.0 (walls, ceiling, floor): 1.2 was too flexible. Closed
    height 23.8 front / 26.4 back; panel-mount female up to 7.2 mm; with
    the charge plug in the lid opens to 95 deg. The panel's KEY guard now
    stops under the thicker ceiling.
    - BACK_SEAM: a 1 mm deep groove, 3 mm above / below the parting, along
    the back of lid and tray (outer size unchanged; replaces the r 1.5
    edge rounding): the edges rubbed when opening. Clear to 164 deg with
    the hinge axis 0.6 mm further in (asserted), 154 deg at 0.9 mm.
    Covers now start 4.0 mm from the axis.
    - LATCH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
    [bom.csv, coupon_dovetail_A.stl, coupon_dovetail_B.stl, coupon_hinge_lid.stl, coupon_hinge_tray.stl, coupon_latch_lid.stl, coupon_latch_tray.stl, display_lid_usbc.stl]
2026-11-09 Revert the back seam groove: the closing trouble was not at the back
    Back to the r 1.5 rounding of the back edges along the parting
    (HINGE_EDGE_R) and covers starting 3.6 mm from the hinge axis. Walls
    2.0 mm, the short snap tab and the looser cover and splice fits stay.
    Docs restored; changelog 19.
    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
    [coupon_dovetail_A.stl, coupon_hinge_lid.stl, coupon_hinge_tray.stl, display_lid_usbc.stl, hinge_cover_lid_x2.stl, hinge_cover_tray_x2.stl, keyboard_tray.stl, lid.stl]
2026-11-09 Straight seams for the A1 mini split pieces (no dovetail keys)
    SPLIT_JOINT = "straight" (kit): lid, tray and panel are cut straight at
    SPLIT_X_*; the splice plates on the hidden side align and hold the
    seam, as before. "dovetail" brings the keys back. The dovetail coupons
    leave plate 0 and the coupon figure numbers whatever is on the plate.
    Plates 1-3: 3 h 52 min, 152 g (0.4 nozzle). Docs, figures and
    changelog 20 updated.
    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
    [bom.csv, coupon_dovetail_A.stl, coupon_dovetail_B.stl, lid_A_left.stl, lid_A_left_usb16mm.3mf, lid_A_left_usb16mm.stl, lid_A_left_usb18mm.3mf, lid_A_left_usb18mm.stl]
2026-11-09 TPU feet and dampers for the tray
    - TPU_FEET: four 16 x 8 mm pads, 1.2 thick, pressed into 0.8 mm pockets
    in the tray's bottom corners (0.05 mm press fit, chamfered mouth and
    table edge), 0.4 mm proud: low enough that the open lid still meets
    the table (now at 168.6 deg) and stops; rear pads 0.5 mm from the back
    edge, so the keyboard needed against tipping goes 83 -> 88 g. The
    report tips about the rear feet and puts the table FOOT_H lower.
    - TPU_DAMPERS: two 10 mm bow springs in grooves in the front rim at
    x = +-70; a 0.3 mm bump pressed flush by the closed lid, ~0.77 N/mm,
    ~0.23 N each (no rattle, no harder to close). Checked in place.
    - plate4_tpu.3mf (4 feet, 2 dampers + 1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
    [bom.csv, coupon_hinge_tray.stl, coupon_latch_tray.stl, keyboard_tray.stl, plate0_test_coupons.3mf, plate2_tray.3mf, plate4_tpu.3mf, tpu_damper.stl]
2026-11-09 Thicken the snap tab's root and brace the panel bosses
    The snap tab was 1.0 mm thick all the way up and stepped to the 2.0 mm wall at a
    square corner, at its most strained point, bent across the print layers. It now
    tapers from 1.0 at the parting to the full wall at its root (no step), with the
    slits 11 mm up and round-ended. Below the parting it is unchanged (12 wide, 2.2
    down). build.py integrates the tapered cantilever: peak strain 0.22 % (was
    0.43 % plus the corner), ~16 N outward pull to reach ~25 MPa (was ~3 N), open
    6.2 N / close 8.7 N; it asserts the strain stays under 0.5 %.
    The six panel bosses (Ø6, 6.3-8.6 mm down from the ceiling) get 1.2 mm ribs:
    full-height ties into walls wi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
    [coupon_hinge_lid.stl, coupon_latch_lid.stl, display_lid_usbc.stl, lid.stl, lid_A_left.stl, lid_A_left_usb16mm.3mf, lid_A_left_usb16mm.stl, lid_A_left_usb18mm.3mf]
2026-11-09 Renders from the front, the end, the front right and the side
    New views in docs/render: front and end (closed, level, near-orthographic
    through a narrow lens; no MSAA there, since edge-on inner walls leaked through
    the outer faces as 1 px streaks, so render.js supersamples them instead), diag
    (closed, front right, low) and side (open, from the left; the view existed but
    was not rendered).
    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
2026-11-09 Snap without slits: the lip sits on a thinned zone of the front wall
    A tab freed from the wall by two slits breaks from the slit ends, where the strain
    gathers on a layer line (the lid prints ceiling down); a thicker root does not
    remove that. The lip (12 x 1.0, 2.2 below the parting, same bump) now stays part
    of the wall, and the front wall is thinned from inside to 1.2 mm over x -14..20 up
    to 2 mm below the ceiling, with 45 deg chamfers (facing up in print) back to the
    2.0 wall, clear of the panel's snap groove. That zone bends outward as a plate.
    src/latch_plate.py solves the wall as a Kirchhoff plate (Morley, scikit-fem,
    ceiling and end walls rigid): 20.5 N/mm at the bump, ~5.2 N to ope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
    [coupon_latch_lid.stl, display_lid_usbc.stl, lid.stl, lid_B_main.stl, lid_usb16mm.3mf, lid_usb16mm.stl, lid_usb18mm.3mf, lid_usb18mm.stl]
2026-11-10 Review with the hinges' spring-back in mind: deeper snap, no dampers
    The lid not staying shut was the torque hinges, not the keyboard: HG-MF08 are
    free-stop friction hinges in POM and turn back a little when let go. At the
    closed position the lid cannot be pushed past closed to make up for it, so it
    comes up again (1 deg at the axis = 1.7 mm at the front edge). Holding it down
    is the snap's job: 0.5..1.3 N at the front edge.
    - Snap engagement 0.20 -> 0.30 mm (bump 0.45): a printer's +-0.15 mm still
    leaves 0.15 mm (~2.8 N of hold); 0.20 could shrink to nothing. The flex zone
    is wider and thinner to match (x -20..20, 1.1 mm): 15.0 N/mm, ~5.7 N to open,
    ~8.1 N to close, strain 0.26 %. Th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
    [bom.csv, coupon_latch_lid.stl, coupon_latch_tray.stl, display_lid_usbc.stl, keyboard_tray.stl, lid.stl, lid_A_left.stl, lid_A_left_usb16mm.3mf]
2026-11-10 Make the 0.4 mm nozzle the standard and check it prints every feature
    print_report: new check "Does the 0.4 mm nozzle print everything?". Each PLA
    plate is sliced (0.4 nozzle, 0.2 layers, Arachne) and the toolpaths are compared
    with the model layer by layer: the outer 0.3 mm of every section has to be
    covered, and sections thinner than 1.5 mm must be filled without a gap. Result:
    no gaps in thin walls; only the lowest layer of the hinge covers' crush ribs and
    specks of at most 0.5 mm2 are left out. No geometry change needed.
    Docs: print settings and plate tables lead with the 0.4 mm nozzle (the 0.2 mm
    settings and estimates stay as the alternative).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
2026-11-10 Add Bambu Studio projects for the A1 mini (0.4 mm nozzle)
    3mf/bambu_a1mini/ holds one project per plate that opens in Bambu Studio
    with the printer, plate type, filament and process already chosen:
    - printer: Bambu Lab A1 mini 0.4 nozzle, Textured PEI Plate
    - process: 0.20mm Standard @BBL A1M with five changes (3 walls, gyroid,
    Arachne, 0.1 mm elephant foot compensation, precise Z height)
    - filament: Bambu PLA Basic (plates 0-3), Bambu TPU 95A HF (plate 4)
    The projects carry only the preset names and the changed values; all other
    settings come from the presets installed with Bambu Studio. A process preset
    (paperdiy_process_a1mini_04.json) is included for importing by hand.
    The files fol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
    [plate0_test_coupons.3mf, plate1_lid.3mf, plate2_tray.3mf, plate3_panel.3mf, plate4_tpu.3mf]
2026-11-10 Name the Bambu Studio projects bambu_plate*.3mf
    They had the same file names as the geometry-only plates, so the two kinds
    could not be told apart once downloaded into one folder.
    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
    [bambu_plate0_test_coupons.3mf, bambu_plate1_lid.3mf, bambu_plate2_tray.3mf, bambu_plate3_panel.3mf, bambu_plate4_tpu.3mf, plate0_test_coupons.3mf, plate1_lid.3mf, plate2_tray.3mf]
2026-11-10 Tray: no ribs inside, the keyboard's room is the original 196 x 87 mm
    The eleven ribs that located the keyboard (0.15 mm a side round an estimated
    194 x 85 mm) got in the keyboard's way. They are gone, and the deck's opening
    is the original tray's room, the one size the keyboard is known to go into.
    build.py checks that nothing stands into that room from the floor up.
    The keyboard is no longer located: it has the same play as in the original
    tray (reported: about 2 mm both ways).
    print_report.py: a gap in a thin section counts as a wall gap only where the
    section goes on in the layer above. The deck's corner, where the sloping rim's
    top face runs out in one layer (0.3 x 1 mm), was counted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
    [bambu_plate0_test_coupons.3mf, bambu_plate2_tray.3mf, bom.csv, coupon_hinge_tray.stl, coupon_latch_tray.stl, keyboard_tray.stl, plate0_test_coupons.3mf, plate2_tray.3mf]
2026-11-10 Remove the TPU feet: flat tray bottom, every part PLA
    The pockets in the tray's first layer and the second material only invited
    mistakes in the making. The tray's bottom is flat again and stands on the
    table, as the original's does.
    - params/build: TPU_FEET, FOOT_H, the pockets and tpu_foot.stl are gone
    - 3MF: plate4_tpu and its Bambu Studio project are gone (plates 0-3 remain)
    - print report: no TPU profile; the tray's "floating bridge anchors" note is
    gone, so no plate has a slicer warning
    - the lid now meets the table at 162.2 deg (168.6 on the feet); the keyboard
    has to weigh 83 g to keep the device upright up to there (was 88 g)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
    [bambu_plate0_test_coupons.3mf, bambu_plate2_tray.3mf, bambu_plate4_tpu.3mf, bom.csv, coupon_hinge_tray.stl, keyboard_tray.stl, plate0_test_coupons.3mf, plate2_tray.3mf]
2026-11-11 Snap: 30 mm lip with a 45 deg catch face; release bundles; docs brought up to date
    Snap. The 12 mm lip with a 35 deg catch face let go by itself in a print,
    though the plate model gave it 5.7 N. The lip is 30 mm wide now (1.7x the
    stiffness: it takes more of the flex zone with it) and the catch face is at
    45 deg (1.5x the hold for the same push): 13.9 N by the model, 2.4x. The
    flex zone, the engagement and the panel are unchanged; the strain is set by
    the engagement, not by the width (0.31 %, 0.46 % with +0.15 mm, asserted).
    The report now says that the model overstates the hold and by roughly how
    much. The snap coupons take in the whole flex zone (46 mm), so plate 0 shows
    the click as the l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
    [bambu_plate0_test_coupons.3mf, bambu_plate1_lid.3mf, bambu_plate2_tray.3mf, coupon_latch_lid.stl, coupon_latch_tray.stl, display_lid_usbc.stl, keyboard_tray.stl, lid.stl]
2026-11-11 Coupon figure: captions as in the assembly guide (160 deg, the snap holds against a finger)
    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
2026-11-11 The solid-lid variant builds again; CI builds the other designs too
    The stricter snap check of the last change (strain under 0.5 % with the
    print's 0.15 mm added) stopped the documented KIT_LID = "solid" build: its
    front wall is lower and stiffer (0.61 %). The default lid keeps the strict
    check; the solid lid is held to the limit at the drawn engagement (0.41 %)
    and logs a CHECK line for the rest.
    `make variants` builds PD_MOUNT=bare and KIT_LID=solid (STL and 3MF) in
    scratch copies, and the build workflow runs it, so "still builds" in the
    docs is checked from now on. KIT_LID can be set from the environment.
    The default outputs are unchanged.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
2026-11-11 README: a photo of the built device, and the status rewritten around it
    One device is assembled and in use (2026-11-11, logged in to a Raspberry Pi
    over SSH; it has the 12 mm snap). The photo leads the README; the status
    paragraphs in the READMEs, the assembly guide and the release notes now say
    that a device exists and that the revision in the repository (30 mm snap) is
    the part not printed yet.
    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
2026-11-11 Tray: the two locating ribs on each end wall are back
    Removing all eleven keyboard ribs went too far: the end ones did not get in
    the way and keep the keyboard from sliding sideways. They are back as they
    were (y +-25, 0.15 mm off the ends of the estimated 194 mm keyboard). The nine
    on the front and back stay out; the deck's opening is unchanged.
    Plate 2: 1 h 34 min, 62 g.
    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
    [bambu_plate0_test_coupons.3mf, bambu_plate2_tray.3mf, bom.csv, coupon_hinge_tray.stl, keyboard_tray.stl, plate0_test_coupons.3mf, plate2_tray.3mf, tray.stl]
2026-11-11 Snap: stops that keep the lid from shifting forward, so the lip has to bend
    The 30 mm lip did not click either, and the lid's front face stood proud of
    the tray's. The lid hangs on the hinges 100 mm behind the snap and can shift
    a few tenths on them: the bump's ramps pushed the whole lid forward instead
    of bending the lip, and the 0.3 mm of engagement was gone. Width and catch
    angle were never the problem.
    Two tongues on the lid, either side of the flex zone, now reach down inside
    the tray's front wall (notches in the deck) and bear on its inner face. Their
    outer face leans back with the closing arc; build.py sweeps the last 6 deg
    and asserts they never touch the tray.
    With the snap actual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
    [bambu_plate0_test_coupons.3mf, bambu_plate1_lid.3mf, bambu_plate2_tray.3mf, coupon_hinge_lid.stl, coupon_hinge_tray.stl, coupon_latch_lid.stl, coupon_latch_tray.stl, display_lid_usbc.stl]
2026-11-11 CI: an unreachable Ubuntu archive skips the print report instead of hanging the run
    Two runs in a row sat for half an hour and more in `apt-get install
    prusa-slicer` ("Temporary failure resolving" the archive mirror). The install
    is now its own step with a 10 min limit; if it fails, the printability report
    is skipped with a warning and the rebuild, variant and firmware checks decide
    the run. A failure of the report itself still fails the run.
    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
2026-11-11 Snap: simulate the lid closing on the built parts; forces and cause restated
    tools/snap_sim.py (make sim) closes the built lid on the built tray: sections
    through the lip and a stop tongue on the hinge's arc, lip and tongue backing as
    springs (latch_plate.wall_compliance), friction, then the spring-back. The lid
    may sit off its drawn position, shift freely or give; printed gaps may differ.
    Results in cad/out/snap_sim.md, figure docs/images/snap_sim.png.
    What it shows:
    - without stops a lid 0.3 mm forward barely holds (2.6 N), at 0.4 mm the bump
    does not reach: matches the prints that did not click
    - with stops a lid that shifts or gives holds (9 N to close, 12 N hold)
    - with stops a lid t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
2026-11-11 Tray: the end-wall ribs are gone again (too tight in the print)
    The two locating ribs on each end wall, brought back 0.15 mm off the ends of
    the estimated 194 mm keyboard, were a little tight on the printed tray. Nothing
    stands out of the tray's walls now; the keyboard's room is the original
    196 x 87 mm. TRAY_KB_RIBS = None (set it again with a measured fit).
    Changed parts: tray (split, one-piece, Bambu project) and the tray hinge coupon
    of plate 0. Lid, panel and the snap are unchanged. Plate 2: 1 h 33 min, 62 g.
    Renders, figures, report, docs and release notes follow.
    Claude-Session: https://claude.ai/code/session_01HXgm54K2gU24gYT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
    [bambu_plate0_test_coupons.3mf, bambu_plate2_tray.3mf, bom.csv, coupon_hinge_tray.stl, keyboard_tray.stl, plate0_test_coupons.3mf, plate2_tray.3mf, tray.stl]
2026-11-11 Lid: relief toward the hinges, so tight hinge screws no longer open it
    Reported from the built device: with the hinge screws tight the lid opens,
    with the screws loose it stays shut. The hinge axis lies in the parting plane,
    0.15 mm behind the back face; the rims met 1.65 mm from it, the front edge is
    60 times further out. Rims 0.05 mm proud there hold the front 3 mm open once
    the countersunk screws pull the leaves home.
    PART_RELIEF: the lid's underside leans up from y -40 to 0.4 mm at the back
    face, so the lid lands on its front edge and the rims near the hinges never
    meet. Only the lid changes (plate 1, the lid hinge coupon of plate 0, the
    panel-mount lids); tray and panel are unchanged.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
    [bambu_plate0_test_coupons.3mf, bambu_plate1_lid.3mf, coupon_hinge_lid.stl, display_lid_usbc.stl, lid.stl, lid_A_left.stl, lid_A_left_usb16mm.3mf, lid_A_left_usb16mm.stl]
2026-11-11 Snap: the stops are gone, one lip in the middle
    The request was to put the two stop tongues where the lip is. They cannot sit
    there: the tray's wall is full behind the lip's recess, and the lid's wall
    there is the zone that bends with the lip. Agreed instead: no stops.
    - LATCH["stop"] = None: no tongues on the lid, no notches or lead-in on the
    tray. The code stays; a dict brings them back. Lip, flex zone, bump and
    groove are unchanged.
    - Why it is acceptable: tight hinge screws levering the lid open (PART_RELIEF)
    is the likelier reason the snaps did not hold, and with a lid that sits
    forward and does not give the tongues would have ridden up on the tray wall.
    - What remains: every 0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
    [bambu_plate0_test_coupons.3mf, bambu_plate1_lid.3mf, bambu_plate2_tray.3mf, coupon_hinge_lid.stl, coupon_hinge_tray.stl, coupon_latch_lid.stl, coupon_latch_tray.stl, display_lid_usbc.stl]
